parthishere/Insane-Keyboard/project_report/the_insane_keyboard.tex

\documentclass[a4paper,11pt]{article}%,twocolumn
\input{settings/packages}
\input{settings/page}
\input{settings/macros}
\usepackage[ framed, numbered]{matlab-prettifier}%framed,%
\usepackage{listings}
\usepackage{physics}
\usepackage{pdfpages}
\usepackage[toc,page]{appendix}
\usepackage{float}
% for code
\usepackage{listings}
\usepackage{color}
\usepackage{pifont}

\usepackage{scalerel,xparse}
\NewDocumentCommand\emojismile{}{
    \scalerel*{
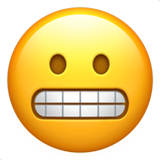
[picture p1: project_report/figures/emoji/u1F62C.png]
        
    }{X}
}

% Define colors
\definecolor{codegreen}{rgb}{0,0.6,0}
\definecolor{codegray}{rgb}{0.5,0.5,0.5}
\definecolor{codepurple}{rgb}{0.58,0,0.82}
\definecolor{backcolour}{rgb}{0.95,0.95,0.92}
% Setup the listings package
\lstset{
    backgroundcolor=\color{backcolour},   
    commentstyle=\color{codegreen},
    keywordstyle=\color{magenta},
    numberstyle=\tiny\color{codegray},
    stringstyle=\color{codepurple},
    basicstyle=\footnotesize,
    breakatwhitespace=false,         
    breaklines=true,                 
    captionpos=b,                    
    keepspaces=true,                 
    numbers=left,                    
    numbersep=5pt,                  
    showspaces=false,                
    showstringspaces=false,
    showtabs=false,                  
    tabsize=2
}

\begin{document}
\input{content/title_page}

\pagebreak

\tableofcontents
\listoffigures
\listoftables
\vfill
\begin{center}
    \textbf{\textit{*PDF is clickable}}
\end{center}

\pagebreak

% \section{}

\section{\color{red}Project Proposal}

\textbf{Team name:}\\
Low Self Esteem Team\\

\textbf{Student Name:}\\
Parth Rajeshkumar Thakkar\\
ParthRajeshkumar.Thakkar@colorado.edu\\

Anagha Aditya\\
Anagha.Aditya@colorado.edu\\

Akash Karoshi\\
Akash.Karoshi@colorado.edu\\

\subsection{Project Rationale and Goals}
For the ECEN 5833 Low Power Embedded System Design course, our team is developing an advanced mechanical keyboard called "The Insane Keyboard". This project aims to create a high-performance input device that combines ergonomic design, customization options, and some cool features.

\subsubsection{Project Rationale}
Our analysis of the mechanical keyboard market revealed several issues:
\begin{itemize}
    \item Ergonomic keyboards often lack additional features or are expensive
    \item Many feature-rich keyboards are wired, limiting mobility
    \item Affordable keyboards offer limited customization
    \item Few keyboards combine ergonomic design, wireless capability, programmable lighting, and smart functions
    \item Keyboards with displays or extra features often have poor power efficiency
\end{itemize}
\subsubsection{Project Goals}
We aim to create a mechanical keyboard with the following features:
\begin{itemize}
    \item Split ergonomic design to reduce physical strain
    \item Wireless connectivity using Bluetooth Low Energy.
    \item Programmable RGB lighting with addressable LEDs
    \item Hot-swappable key switches for easy customization
    \item Low-power E-ink display for additional information
    \item Multi-device compatibility
    \item Advanced power management techniques
    \item Environment temperature and pressure sensing.
    \item Real Time clock module for timer, stopwatch and time features.
    \item Potential energy harvesting from typing (Yet to be seen)
    \item Open-source firmware for extensive customization
    \item Cost-effective design for market accessibility
\end{itemize}

\subsubsection{Unique Features}
"The Insane Keyboard" has unique features like:
\begin{itemize}
    \item Integration of multiple desirable features in one device
    \item Optimized power management for extended use
    \item Potential energy harvesting from typing motions
    \item Open-source firmware for community-driven development
    \item Adaptable design for future upgrades
\end{itemize}

\subsubsection{Expected Outcomes}
Upon completion, this project could:
\begin{itemize}
    \item Improve ergonomics in daily computer use
    \item Advance keyboard power management and energy harvesting
    \item Foster a community of keyboard enthusiasts and developers
    \item Demonstrate practical applications of low-power embedded design
\end{itemize}

\subsection{Existing Products and Ideas from products}

% Placeholder for a diagram of the keyboard design
\begin{figure}[H]
    \centering
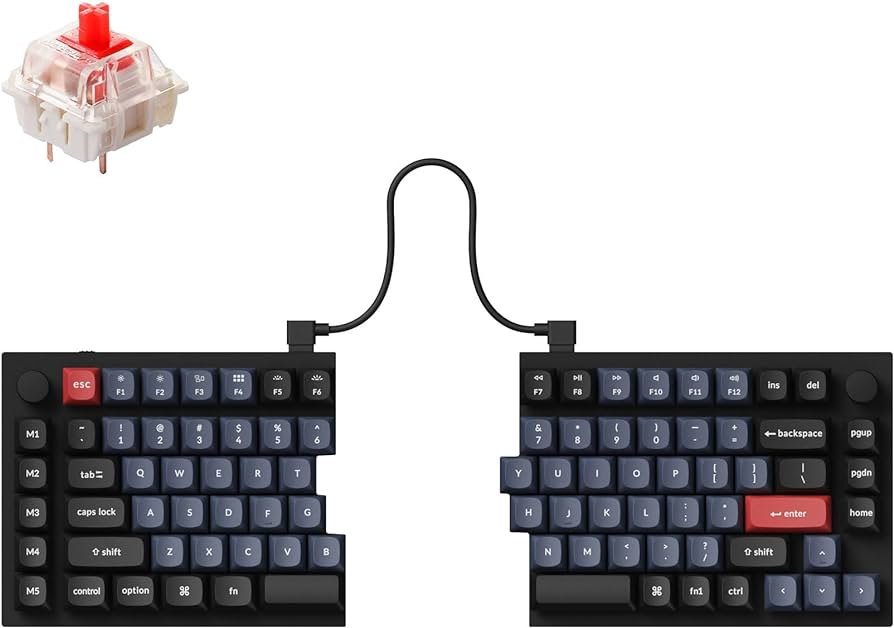
[picture p2: project_report/figures/split_keyboard.jpg]
    
    \caption{Split Keyboard without display(Wired)}
    % Figure content to be added
\end{figure}
\vspace{0.2cm}
\begin{figure}[H]
    \centering
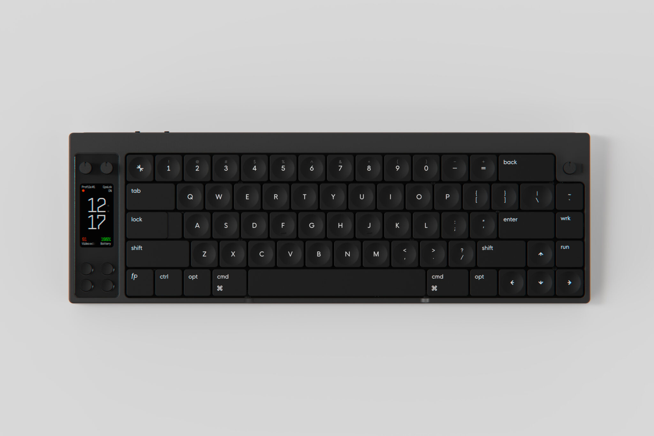
[picture p3: project_report/figures/nomad.jpg]
    
    \caption{Keyboard which is expensive and have a Display}
    % Figure content to be added
\end{figure}
\vspace{0.2cm}

\begin{figure}[H]
    \centering
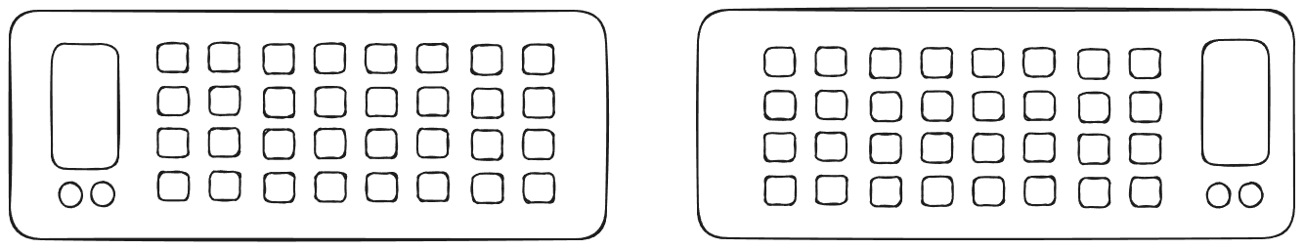
[picture p4: project_report/figures/concept.png]
    
    \caption{Conceptual Design of The Insane Keyboard}
    % Figure content to be added
\end{figure}
\vspace{0.2cm}

\subsection{High Level Requirements}

\subsubsection{General Requirements}
\begin{itemize}
\item Two EFR32BG13 boards (one per module)
\item Should be Ergonomic
\item 75\% keyboard layout (TKL layout)
\item IO expander for each MCU
\item Temperature sensor
\item Pressure sensor
\item Real-Time Clock (RTC)
\item Connectivity to three host devices
\item Computer software for LED customization
\item Individually customizable LEDs
\item E-ink display on each module
\item Energy harvesting on each module
\item Charging circuit with Type-C connector
\item Charging indicator
\item Battery indicator
\item Minimum 6-key rollover
\item HID protocol communication between modules
\item Smart power states (active, idle, deep sleep)
\item RTOS: FreeRTOS (Yet to be decide)
\item PWM-based RGB LED control
\item Hot-swappable key switches
\item Time, date, battery status, current profile, custom graphics
\item Spotify integration for music control and now-playing information(yet to be seen)
\end{itemize}

\subsection{Keyboard Layout and Design}

\subsubsection{Main Board Key Layout}
\begin{center}
\begin{tabular}{|c|c|c|c|c|c|c|}
\hline
\multicolumn{7}{|c|}{\textbf{Function Row}} \\ \hline
\begin{tabular}[c]{@{}c@{}}ESC\ $\sim$ `{}\end{tabular} &
\begin{tabular}[c]{@{}c@{}}F1\ 1 !\end{tabular} &
\begin{tabular}[c]{@{}c@{}}F2\ 2 @\end{tabular} &
\begin{tabular}[c]{@{}c@{}}F3\ 3 \#\end{tabular} &
\begin{tabular}[c]{@{}c@{}}F4\ 4 \$\end{tabular} &
\begin{tabular}[c]{@{}c@{}}F5\ 5 \%\end{tabular} &
\begin{tabular}[c]{@{}c@{}}F6\ 6 \^{}\end{tabular} \\
\hline
\multicolumn{7}{|c|}{\textbf{QWERTY Row}} \\
\hline
TAB & Q & W & E & R & T &\\
\hline
\multicolumn{7}{|c|}{\textbf{Home Row}} \\
\hline
CAPS & A & S & D & F & G & \\
\hline
\multicolumn{7}{|c|}{\textbf{Bottom Row}} \\
\hline
SHIFT & Z & X & C & V & B & \\
\hline
\multicolumn{7}{|c|}{\textbf{Modifier Row}} \\
\hline
CTRL & OPT & WIN/MAC & ALT & \multicolumn{3}{c|}{SPACE} \\
\hline
\end{tabular}
\end{center}
\textbf{Additional Inputs:}
\begin{itemize}
\item 2 × Rotary Encoders (Knobs)
\item 3 × Extra Buttons
\end{itemize}
\textbf{Additional Components}
\begin{itemize}
    \item E-Ink display
    \item Battery
    \item Battery Charging and Power Management Unit \textcolor{yellow}{(Not in Secondary module)}
    \item Tempurature Sensor \textcolor{yellow}{(Not in Secondary module)}
    \item Real time Clock \textcolor{yellow}{(Not in Secondary module)}
\end{itemize}

\subsection{Secondary Module Key Layout}
\begin{center}
\begin{tabular}{|c|c|c|c|c|c|c|c|}
\hline
\multicolumn{8}{|c|}{\textbf{Function Row}} \\
\hline
F7 & F8 & F9 & F10 & F11 & F12 & BKSP & HOME \\
\hline
\multicolumn{8}{|c|}{\textbf{QWERTY Row}} \\
\hline
Y & U & I & P & \{[ & \}] & |$\backslash$  & DEL \\
\hline
\multicolumn{8}{|c|}{\textbf{Home Row}} \\
\hline
H & J & K & L & \begin{tabular}[c]{@{}c@{}}; :\end{tabular} & \begin{tabular}[c]{@{}c@{}}" '\end{tabular} & ENTER & PGUP \\
\hline
\multicolumn{8}{|c|}{\textbf{Bottom Row}} \\
\hline
N & M & \begin{tabular}[c]{@{}c@{}}, <\end{tabular} & \begin{tabular}[c]{@{}c@{}}. >\end{tabular} & \begin{tabular}[c]{@{}c@{}}/ ?\end{tabular} & SHIFT & ↑ & PGDN \\
\hline
\multicolumn{8}{|c|}{\textbf{Modifier Row}} \\
\hline
& SPACE & ALT/MAC & FN & CTRL & ← & ↓ & → \\
\hline
\end{tabular}
\end{center}
\textbf{Additional Inputs:}
\begin{itemize}
\item 2 × Rotary Encoders (Knobs)
\item 3 × Extra Buttons
\end{itemize}
\textbf{Additional Components:}
\begin{itemize}
    \item E-Ink display
    \item Battery
    \item Power Management Unit
\end{itemize}

\subsection{Challenges and Considerations}
\begin{itemize}
\item Managing state machines with complex software like e-ink display drivers
\item Integrating drivers with BLE firmware
\item Implementing RTC driver and temperature control driver
\item Ensuring reliable wireless connectivity
\item Implementing multi-host communication and switching
\item Developing HID profile in BLE stack
\item Implementing anti-ghosting techniques
\item Optimizing keyboard scan rate for low latency
\item Achieving N-key rollover or 6-key rollover
\end{itemize}

\pagebreak
\section{\color{red}Project Update: Week 1}

\subsection{Technical Considerations}

\subsubsection{Functional hardware block diagram}

\begin{figure}[H]
    \centering
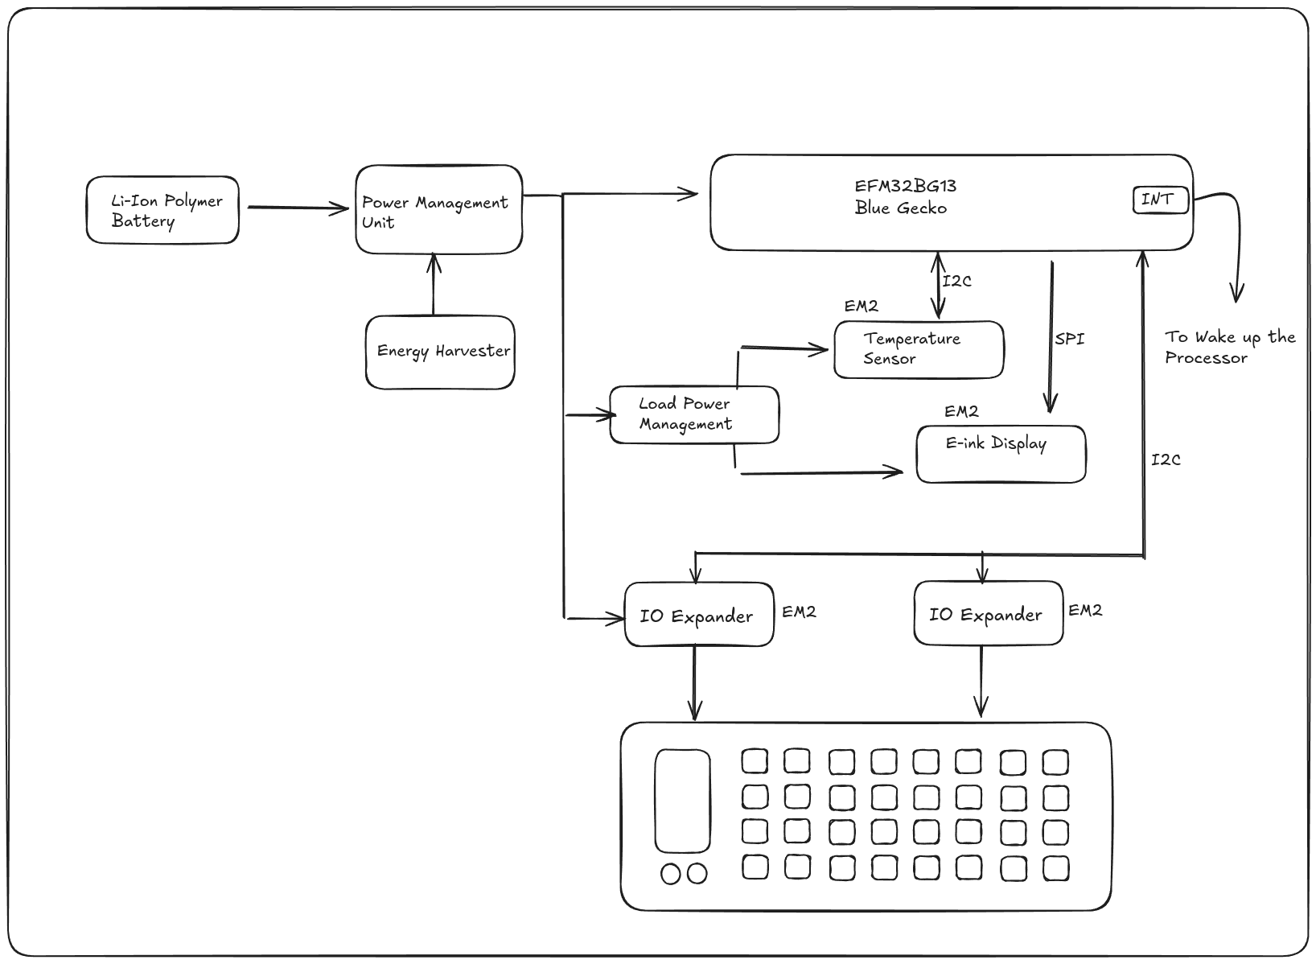
[picture p5: project_report/figures/blockdiagram.png]
    
    \caption{Hardware block diagram}
    % Figure content to be added
\end{figure}
\vspace{0.2cm}

\textbf{0-Key Rollover (Normal Matrix)}
\begin{figure}[H]
	\centering
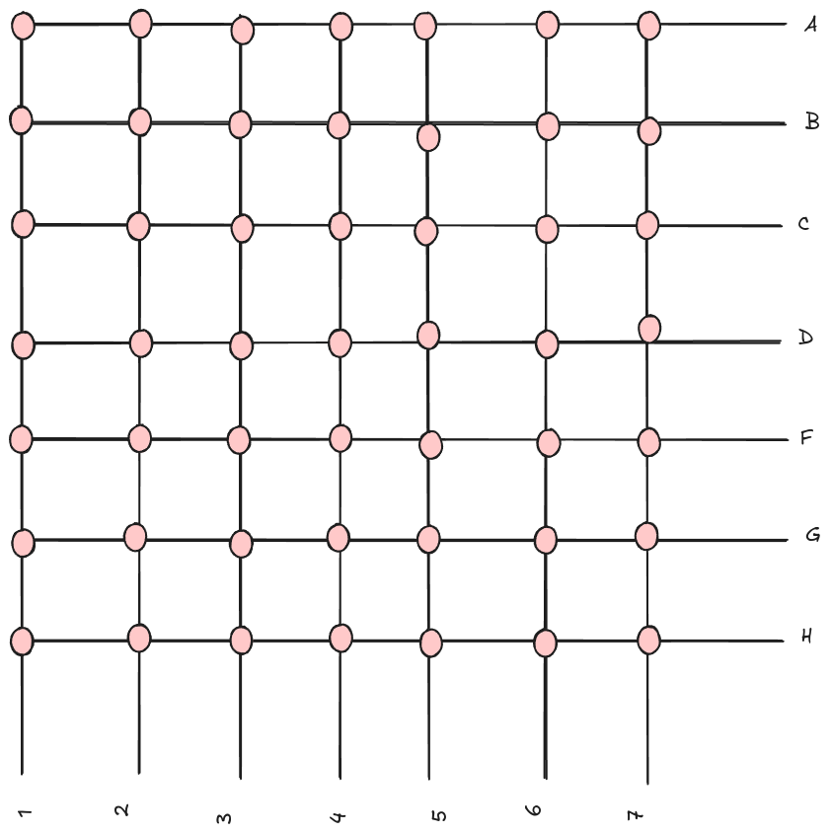
[picture p6: project_report/figures/NRO.png]
	
	\caption{Normal Matrix for no key roll over}
\end{figure}
\begin{figure}[H]
	\centering
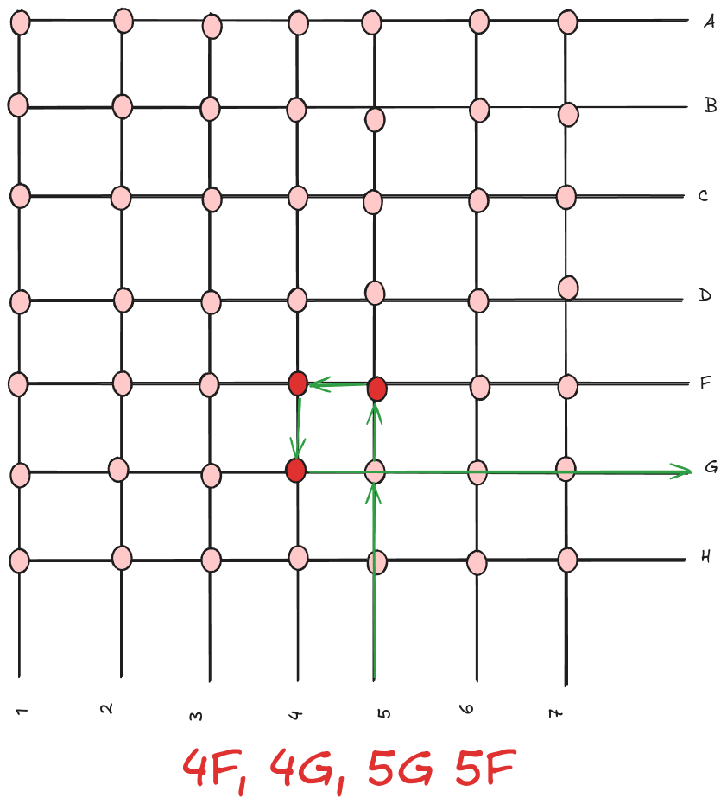
[picture p7: project_report/figures/nkr-EX.png]
	
	\caption{Decoding wrong button press}
\end{figure}

\textbf{N-Key Rollover feature with Diodes}
\begin{figure}[H]
    \centering
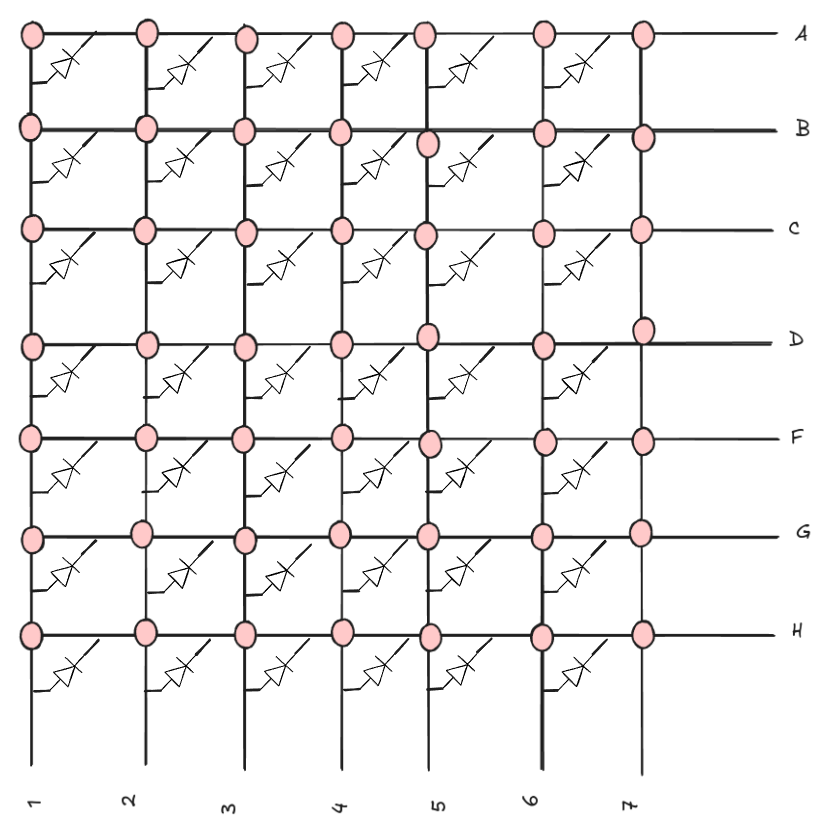
[picture p8: project_report/figures/NKRO.png]
    
    \caption{N-Key Rollover}
\end{figure}

\begin{figure}[H]
	\centering
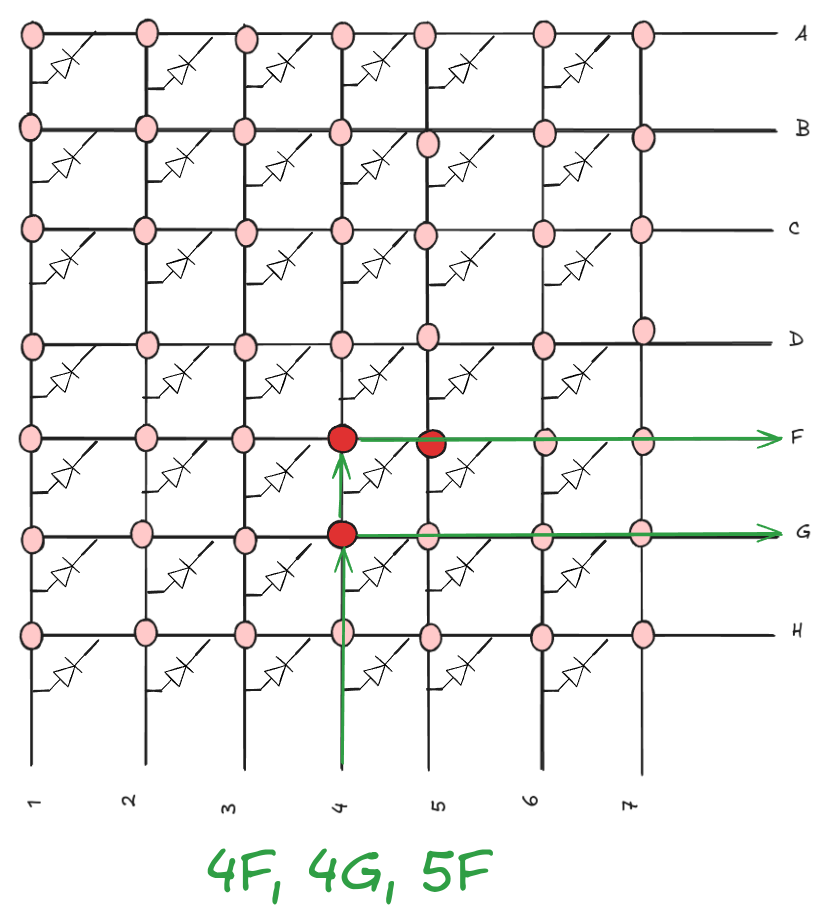
[picture p9: project_report/figures/NKRO-EX.png]
	
	\caption{Multiple keys pressed}
\end{figure}

The keyboard uses a matrix layout, which is an efficient way to manage multiple key inputs with fewer microcontroller pins. In the images, we see an 8x7 matrix (rows A-H, columns 1-7).\\
Scanning Process:\\

The microcontroller scans this matrix by activating one column at a time and reading the state of all rows.
When a key is pressed, it connects a row and column, which the microcontroller detects.\\

\textbf{Ghosting and Its Prevention:}

Ghosting is a problem in simple matrix designs where pressing multiple keys can lead to false key registrations.
Example (Image 1):\\

If keys at 4F, 4G, and 5F are pressed simultaneously, the matrix might also falsely register 5G.\\

\textbf{Solution (Images 2 and 3):}

Diodes are added to each key switch.
These diodes allow current to flow in only one direction, preventing the "phantom" current paths that cause ghosting.
With diodes, when 4F, 4G, and 5F are pressed, 5G is not falsely registered.\\

\textbf{N-Key Rollover (NKRO):}

NKRO allows the keyboard to correctly register any number of simultaneous key presses.\\
Implementation:\\

Each key gets its own diode, ensuring independent registration.
The microcontroller scans the entire matrix rapidly, detecting all pressed keys without conflicts.\\

\textbf{Hardware Components:}

\textbf{Central Microcontroller:}

EFM32BG13 Blue Gecko: This MCU manages all keyboard functions and interfaces with other components.\\

\textbf{Sensors:}

TMP117: Measures temperature, humidity, and pressure, potentially for environmental adaptation or user information.\\
DS3231 RTC Module: Provides accurate timekeeping, useful for time-based functions or logging.\\

\textbf{Display}:

E-Ink Display (800x600, 4.3inch): Offers a low-power way to show keyboard status, settings, or other information.\\

\textbf{Expansion:}

MCP23017 IO Expander: Increases the number of available pins for the key matrix, allowing for more keys or other inputs.\\

\textbf{Power Management:}

Power Management Unit: Manages power distribution and consumption.\\
Li-Ion Polymer Battery: Provides portable power.\\
Energy Harvester: Potentially extends battery life by capturing ambient energy.\\

\textbf{Key Switches and Caps:}

Gateron G Black Pro 2.0 switches: Known for smooth linear action.
Cherry MX key caps: Industry-standard keycaps for customization.\\

\textbf{Additional Inputs:}

Rotary encoders: Provide alternative input methods, possibly for volume control or menu navigation.\\

\textbf{PCB Design:}

4-layer PCB: Allows for more complex routing and better signal integrity.\\
Two versions:\\

Main Module with  all sensors and charging capabilities.\\
Simplified Secondary Module without temperature, humidity, RTC, and LiPo charger.\\

\subsection{Wireless Communication and Software Architecture}

We have made significant progress in defining our wireless communication protocol and software architecture:

\subsubsection{HID Profile Characteristics}
We've detailed the HID (Human Interface Device) profile for our keyboard, including:
\begin{itemize}
    \item Keyboard Input Report: 8-byte structure for key presses
    \item Keyboard Output Report: 1-byte for LED status
    \item Protocol Mode: Supports both Boot and Report protocols
    \item HID Information and Control Point: For device management
    \item Report Map: Defines input/output report formats
\end{itemize}

\subsubsection{Software Architecture}
We've developed a functional software block diagram that outlines the interaction between various software components, including the BLE stack, keyboard matrix scanning, and power management modules.

\begin{figure}[H]
    \centering
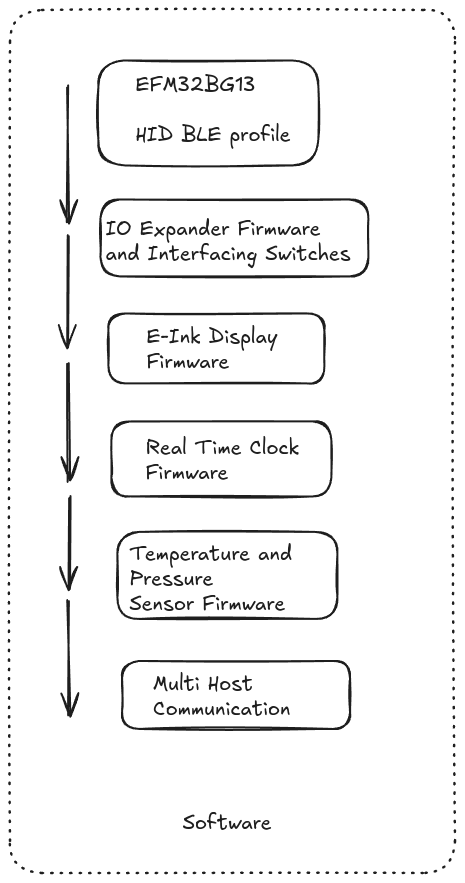
[picture p10: project_report/figures/software_diagram.png]
    
    \caption{Software Block Diagram}
\end{figure}

\subsection{Project Management}

We've set up a robust project management system:

\begin{enumerate}
    \item Timeline: We've created a detailed project timeline (Figure \ref{fig:timeline}) to track our progress and milestones.
    
    \item Version Control: Our project is now on GitHub, allowing for better collaboration and code management.
    \begin{itemize}
        \item Project Board: \href{https://github.com/users/parthishere/projects/2}{GitHub Project}
        \item Code Repository: \href{https://github.com/parthishere/Insane-Keyboard}{GitHub Code Repository}
    \end{itemize}
    
    \item Task Tracking: We're using a Kanban board (Figure \ref{fig:kanban}) to manage our tasks and workflow efficiently.
\end{enumerate}

\begin{figure}[H]
    \centering
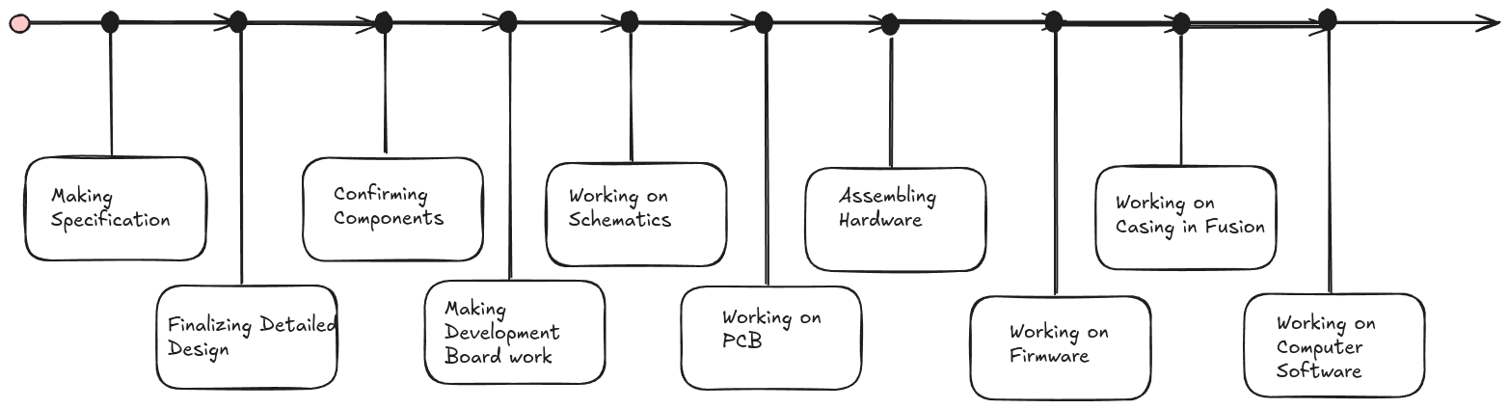
[picture p11: project_report/figures/Timeline.png]
    
    \caption{Project Timeline}
    \label{fig:timeline}
\end{figure}

\begin{figure}[H]
    \centering
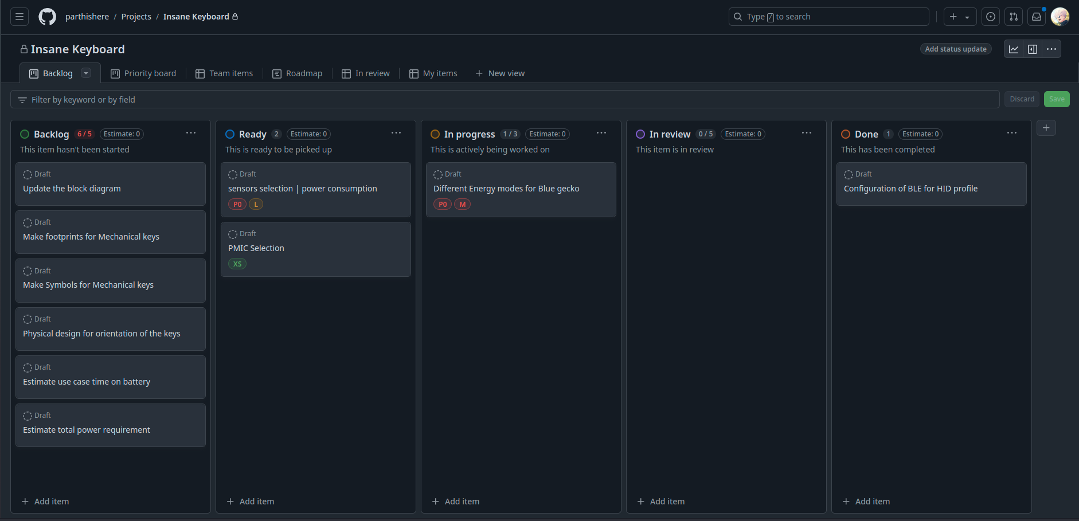
[picture p12: project_report/figures/kanban.png]
    
    \caption{Kanban Board for Task Management}
    \label{fig:kanban}
\end{figure}

\subsection{Energy Analysis and Power Management}

We've conducted initial energy mode analysis and made decisions on power management:

\begin{enumerate}
    \item Energy Calculations: We've performed preliminary calculations (Figure \ref{fig:energy_calc}) to estimate power consumption in various modes.

    \item Energy Harvesting: We've chosen to incorporate a solar panel for energy harvesting, enhancing the keyboard's power autonomy.

    \item Interface Selections:
    \begin{itemize}
        \item Display: SPI interface chosen for faster data transfer
        \item Temperature Sensor and IO Expander: I2C interface for power efficiency
    \end{itemize}

    \item Load Power Management: Implemented a load switch to disable the temperature sensor and display when not in use, reducing standby power consumption.

    \item Multiple Energy Modes: Our design now supports various energy modes to optimize power usage based on the keyboard's current state.
\end{enumerate}

\begin{figure}[H]
    \centering
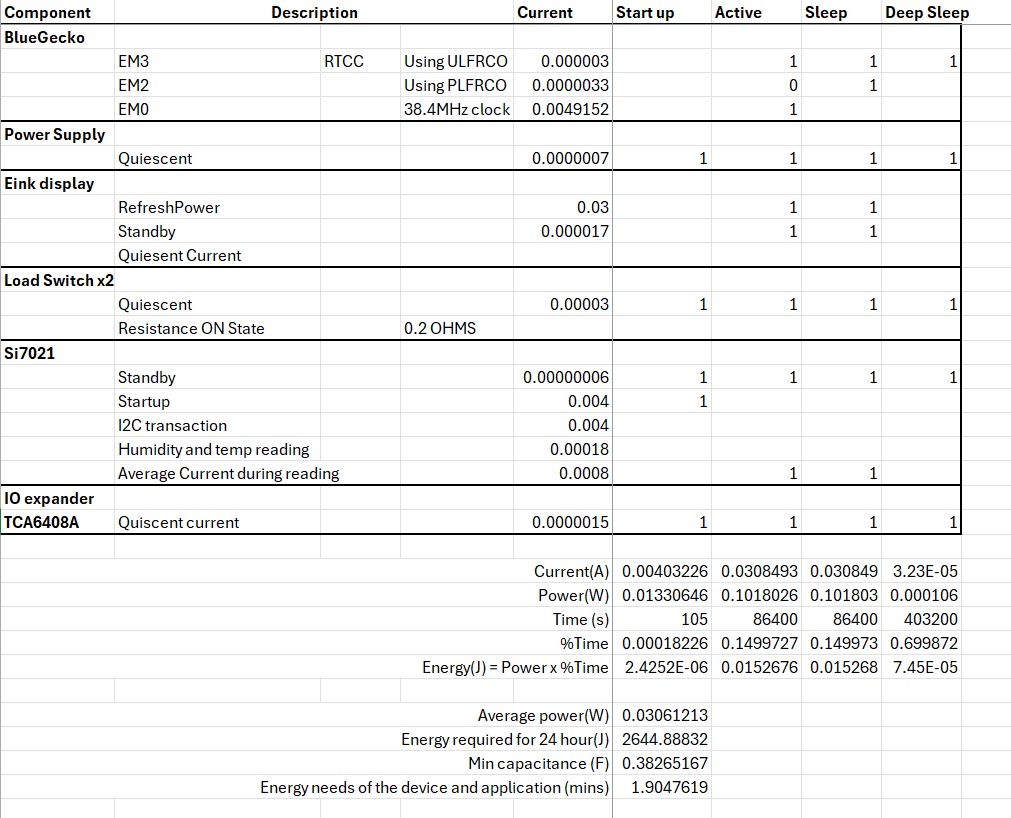
[picture p13: project_report/figures/calc.jpeg]
    
    \caption{Energy Calculations}
    \label{fig:energy_calc}
\end{figure}

\pagebreak

\section{\color{red}Project Update: Week 2}

\subsection{Selection Criteria}
We chose components based on:

\begin{enumerate}
    \item Availability: Multiple suppliers to ensure steady supply.
    \item Power efficiency: Low standby and active currents, multiple power-saving modes.
    \item Documentation: Comprehensive datasheets, application notes, and support.
    \item Sleep modes: Various low-power states with quick wake-up capabilities.
    \item Temperature range: Suitable for varied environments.
    \item EMC/EMI: Built-in interference mitigation.
    \item ongevity: Components not near end-of-life.
    \item Cost: Balanced features and performance with price.
\end{enumerate}

\subsubsection{Chosen Components}

\begin{longtable}{|p{2cm}|p{1.5cm}|p{3cm}|p{1.5cm}|p{6cm}|}
    \hline
    \textbf{Component} & \textbf{Quantity} & \textbf{Function} & \textbf{Interface} & \textbf{DigiKey Part Number} \\
    \hline
    EFR32BG13 & 2 & Microcontroller & - & 
    \href{https://www.digikey.com/en/products/detail/silicon-labs/EFR32BG13P632F512GM32-D/10135852}{EFR32BG13P632F512GM32-D-ND} \\
    \hline
    TCA6408A & 2 & IO Expander & I2C  & 
    \href{https://www.digikey.com/en/products/detail/texas-instruments/TCA6408ARSVR/2044045}{296-24328-1-ND} \\
    \hline
    Waveshare E-ink Display & 1 & Display & SPI  & 
    \href{https://www.waveshare.com/1.54inch-e-paper-module.htm}{External Link} \\
    \hline
    TPS22919 & 1 & Load Switch & -  & 
    \href{https://www.digikey.com/en/products/detail/texas-instruments/TPS22919DCKT/9953066}{296-53421-1-ND} \\
    \hline
    BQ25570 & 2 & PMIC & - & 
    \href{https://www.digikey.com/en/products/detail/texas-instruments/BQ25570RGRT/4430487}{296-37014-1-ND} \\
    \hline
    Battery 1000mAh & 2 & Energy Storage & -  & 
    \href{https://www.digikey.com/en/products/detail/globtek-inc/BL1200P4054481S1PCAC/11201333}{1939-BL1200P4054481S1PCAC-ND} \\
    \hline
    SI7021 & 1 & Temperature and Humidity Sensor & I2C  & 
    \href{https://www.digikey.com/en/products/detail/silicon-labs/SI7021-A20-GMR/5048936}{336-4379-1-ND} \\
    \hline
    Schottky Diodes & 1 & Power Management & -  & 
    \href{-}{Have not decided yet} \\
    \hline
    Gateron G Black Pro 2.0 & 68 & Key Switches & - & 
    \href{https://www.gateron.co/products/gateron-g-pro-2-0-switch-set}{External link} \\
    \hline
    Mechanical Key Hotswap & 68 & Hotswap Sockets & - & 
    \href{https://www.gateron.co/products/gateron-hot-swap-pcb-socket}{External Link} \\
    \hline
    Cherry MX Key Caps & 68 & Key Caps & - & 
    \href{https://www.aliexpress.com/i/3256802573932641.html?gatewayAdapt=4itemAdapt}{External link} \\
    \hline
    Rotary Encoders & 2 & Input Device & - & 
    \href{https://www.digikey.com/en/products/detail/bourns-inc/PEC12R-4222F-S0024/4699283}{PEC12R-4222F-S0024-ND} \\
    \hline
    Solar Panel SM141K06L & 1 & Energy Harvesting & - & 
    \href{https://www.digikey.com/en/products/detail/anysolar-ltd/SM141K06L/9990462}{SM141K06L-ND} \\
    \hline
    \caption{Component List for The Insane Keyboard with DigiKey Part Numbers}
    \label{tab:components}
\end{longtable}

\subsection{Justification for Each Component}

\subsubsection{EFR32BG13 Microcontroller}
\begin{itemize}
    \item Bluetooth 5.0 capable
    \item Energy-efficient: 60 uA/MHz at 40 MHz
    \item Five power modes: 1.4 uA in deep sleep, 20 nA in shutoff
    \item Low-energy peripherals for efficient keyboard scanning
    \item Comprehensive development tools
\end{itemize}

\subsubsection{TCA6408A I/O Expander}
\begin{itemize}
    \item 0.1 uA standby current
    \item 400 kHz I2C interface for quick I/O updates
    \item 8 programmable I/O pins, each sinking 25 mA
    \item Interrupt output for event-driven operation
    \item Chosen over PCA9538 and SX1509 for lower power and simpler programming
\end{itemize}

\subsubsection{Waveshare E-ink Display}
\begin{itemize}
    \item Power used only during updates
    \item Enables dynamic key labeling
    \item SPI interface for fast updates
    \item 200x200 pixel resolution
    \item Preferred over OLED for lower power consumption
\end{itemize}

\subsubsection{TPS22919 Load Switch}
\begin{itemize}
    \item 12 nA quiescent current
    \item 15 us response time
    \item 2A current capacity
    \item 1.5V to 5.5V input range
    \item Built-in protection features
    \item Chosen over TPS22860 and SiP32431 for balanced performance
\end{itemize}

\subsubsection{BQ25570 Power Management IC}
\begin{itemize}
    \item 100 mV to 5.1 V input range
    \item Integrated Maximum Power Point Tracking
    \item 488 nA quiescent current
    \item Built-in boost charger and buck converter
    \item Programmable voltage thresholds
    \item Selected over SPV1050 and ADP5090 for solar power optimization
\end{itemize}

\subsubsection{SI7021 Temperature and Humidity Sensor}
\begin{itemize}
    \item ±0.4°C and ±3\%RH accuracy
    \item 150 nA standby current
    \item I2C interface
    \item 3x3 mm package
    \item 1.9V to 3.6V supply range
    \item Chosen over HDC1080 and BME280 for accuracy and power efficiency
\end{itemize}

\subsubsection{Solar Panel (SM141K06L)}
\begin{itemize}
    \item 42mm x 23mm size
    \item 184 mW maximum output
    \item 3.35V at maximum power point
\end{itemize}

\subsubsection{Battery (1000mAh)}
\begin{itemize}
    \item Size: 2.09" x 1.89" x 0.16"
    \item 525mA charge current, 1.05A discharge current
    \item 3.7V nominal voltage
\end{itemize}

\subsection{Energy Analysis}
\subsubsection{Overall Energy Efficiency}
We have made the following assumption for our energy calculations:
The keyboard will be operational 24/7, with the following daily usage pattern:\
8 hours of active use per day
\begin{itemize}
\item 4 hours in active mode
\item 4 hours in sleep mode
\end{itemize}
16 hours in deep sleep mode
\paragraph{Energy Consumption Breakdown}
Based on our calculations, the energy consumption for different operational states is as follows:
\begin{itemize}
\item Start-up: 0.000101970 W
\item Active: 0.0166035556 W
\item Transmit: 0.129140610 W
\item Sleep: 0.000122760 W
\item Deep Sleep: 0.00011187 W
\end{itemize}
\paragraph{Average Power Consumption}
The weighted average power consumption, considering the time spent in each mode, is calculated to be:
\begin{equation}
P_{avg} = 0.003976168 \text{ W}
\end{equation}
This remarkably low average power consumption is achieved through intelligent power management and efficient component selection.
\paragraph{Daily Energy Requirement}
Based on our average power consumption, the total energy required for 24 hours of operation is:
\begin{equation}
E_{daily} = 343.5409345 \text{ J} = 0.095428 \text{ Wh}
\end{equation}
\paragraph{Battery Capacity Calculation}
For sustained operation over a week, we calculated the required battery capacity:
\begin{align*}
E_{weekly} &= 2404.786542 \text{ J} = 0.667996262 \text{ Wh} \
\text{Adjusted Energy} &= \frac{0.667996262}{0.85 \times 0.8} = 0.982347443 \text{ Wh} \
\text{Battery Capacity} &= \frac{0.982347443 \text{ Wh}}{3.7 \text{ V}} \times 1000 = 265.499309 \text{ mAh}
\end{align*}
This calculation takes into account a battery efficiency of 85\% and a maximum depth of discharge of 80\% to ensure long-term battery health.
\paragraph{Energy Harvesting Efficiency}
Our solar panel and power management system are designed to harvest energy efficiently even in low-light indoor conditions. The BQ25570 PMIC, with its Maximum Power Point Tracking (MPPT) capability, ensures optimal energy extraction from the solar panel.
\paragraph{Power Budget Analysis}
\begin{itemize}
\item Average current draw: 1.07464 mA
\item Peak current (during transmission): 39.0296560 mA
\item Quiescent current (deep sleep): 33.9 uA
\end{itemize}
The significant difference between peak and quiescent current underscores the effectiveness of our power-saving modes.
\paragraph{Capacitor Sizing}
To support peak current demands, we calculated a minimum capacitance of:
\begin{equation}
C_{min} = 0.049702103 \text{ F}
\end{equation}
This capacitance ensures stable operation during high-current events while allowing the solar harvesting system to replenish energy during low-power periods.
With an average power consumption of just 3.976 mW and a weekly energy requirement of less than 1 Wh, our keyboard is well-positioned for long-term, self-sustained operation using solar energy harvesting, even in typical indoor environments.
\subsection{Battery and Power Management}
\subsubsection{Power Management IC (PMIC) Selection}
We have selected the BQ25570 PMIC as it provides the necessary features for efficient solar harvesting and battery management. Key features include:
\begin{itemize}
\item Wide input range: 100 mV to 5.1 V, ideal for solar harvesting
\item Integrated Maximum Power Point Tracking (MPPT)
\item Ultra-low quiescent current: 488 nA typical
\item Integrated boost charger and buck converter
\item Programmable voltage thresholds for optimal battery management
\end{itemize}
\subsubsection{Energy Storage Element Selection}
\textbf{Choice: SM141K06L Solar panel}
\begin{itemize}
\item Power Output: 184 mW
\item Voltage at Maximum Power Point (Vmpp): 3.35 V
\item Current at Maximum Power Point (Impp): 55.1 mA
\item Open Circuit Voltage (Voc): 4.15 V
\item Short Circuit Current (Isc): 58.6 mA
\item Size: 42.00mm x 23.00mm x 2.10mm (1.654" x 0.906" x 0.083")
\end{itemize}
Reasons for selection:
\begin{itemize}
\item Significantly higher power output compared to previous options
\item Larger but still manageable size for a keyboard design
\item Higher voltage output, beneficial for power management
\item Good power-to-size ratio
\end{itemize}
Energy Calculations (assuming 8 hours of typical indoor lighting per day):
\begin{flalign*}
&\text{Energy per day} = Power * Time &&\
&\text{Energy per day} = 184 mW * 8 hours  &&\
&\boxed{\text{Energy per day} = 1,472 mWh }&&
\end{flalign*}
Power Density:
\begin{equation*}
\text{Power Density} = \frac{\text{Power Output}}{\text{Area}} = \frac{184 \text{ mW}}{42\text{ mm} \times 23\text{ mm}} = \boxed{0.191 \text{ mW/mm²}}
\end{equation*}
\subsection{Energy Requirements Analysis}
\subsubsection{Unregulated Supply Performance}
Constant Power Case:
\begin{itemize}
\item Regulated power supply providing power for microcontroller and sensors which require input voltage kept in limited range.
\item As voltage out of energy source drops from Vworking to Vmin, current increases to keep power through supply constant.
\end{itemize}
\subsubsection{Peak and Average Current Use Cases}
We have analyzed the current requirements for each component in our system under both peak and average use conditions. Table \ref{tab:current_requirements} summarizes these findings:
\begin{table}[H]
\centering
\begin{tabular}{|l|c|c|}
\hline
\textbf{Component} & \textbf{Peak Current (A)} & \textbf{Average Current (A)} \\
\hline
Temperature Sensor & 0.004 & 0.00071424 \\
\hline
E-ink Display & 0.008 & 8.05558E-05 \\
\hline
MCU & 0.0393152 & 0.000115536 \\
\hline
PMIC & 0.0000009 & 0.0000009 \\
\hline
Load Switch & 0.0000201 & 0.0000201 \\
\hline
IO Expander & 0.0000015 & 0.0000015 \\
\hline
\textbf{Total} & 0.0513377 & 0.000932832 \\
\hline
\end{tabular}
\caption{Component Current Requirements}
\label{tab:current_requirements}
\end{table}
\subsubsection{Total Energy Required Between Charging}
Given:
\begin{itemize}
\item Battery Capacity: 1000 mAh
\item Assumed Battery Voltage: 3.7 V (typical for Li-ion)
\item Daily Energy Consumption: 343.5409345 J
\end{itemize}
Calculations:
\begin{enumerate}
\item \textbf{Convert Battery Capacity to Joules:}
\begin{equation}
\text{Energy (J)} = \text{Capacity (mAh)} \times \text{Voltage (V)} \times 3.6
= 1000 \times 3.7 \times 3.6 = 13,320 \text{ J}
\end{equation}
\item \textbf{Calculate Number of Days:}
\begin{equation}
\text{Days} = \frac{\text{Total battery energy}}{\text{Daily energy consumption}}
= \frac{13,320 \text{ J}}{343 \text{ J/day}} \approx 38.83 \text{ days}
\end{equation}
\item \textbf{Convert to Weeks:}
\begin{equation}
38.83 \text{ days} \approx 5.55 \text{ weeks}
\end{equation}
\end{enumerate}
\subsubsection{Recharge Time Calculation}
We are using a 1000mAh battery with a 0.5C charging rate:
\begin{itemize}
\item Theoretical charging current: 0.5C = 500mA
\item BQ25570 PMIC maximum charging current: 230mA (typical)
\end{itemize}
Since the PMIC can't provide 500mA, it will charge at its maximum rate of 230mA.
\begin{equation}
\text{Estimated charging time} = \frac{\text{Battery Capacity}}{\text{Charging Current}}
= \frac{1000\text{mAh}}{230\text{mA}} \approx 4.35 \text{ hours}
\end{equation}

\subsection{Supercapacitor vs Battery Comparison: Mathematical Analysis}

We'll compare a 4F Vishay supercapacitor with our 1000mAh Li-ion battery, focusing on quantitative aspects.

\subsubsection{Energy Storage}

\paragraph{Battery:}
Energy stored in the battery:
\begin{equation}
    E_{\text{battery}} = \text{Capacity} \times \text{Voltage} = 1000 \text{ mAh} \times 3.7 \text{ V} = 3700 \text{ mWh} = 13320 \text{ J}
\end{equation}

\paragraph{Supercapacitor:}
Energy stored in the supercapacitor (assuming 2.7V max voltage):
\begin{equation}
    E_{\text{supercap}} = \frac{1}{2} C V^2 = \frac{1}{2} \times 4 \text{ F} \times (2.7 \text{ V})^2 = 14.58 \text{ J} = 0.00405 \text{ Wh}
\end{equation}

\subsubsection{Power Density}

\paragraph{Battery:}
Assuming a discharge time of 1 hour at maximum current (1.05A):
\begin{equation}
    P_{\text{battery}} = 3.7 \text{ V} \times 1.05 \text{ A} = 3.885 \text{ W}
\end{equation}

\paragraph{Supercapacitor:}
Assuming a discharge time of 1 second (typical for supercapacitors):
\begin{equation}
    P_{\text{supercap}} = \frac{E_{\text{supercap}}}{\text{time}} = \frac{14.58 \text{ J}}{1 \text{ s}} = 14.58 \text{ W}
\end{equation}

\subsubsection{Current Handling}

\paragraph{Battery:}
Maximum discharge current: 1.05A

\paragraph{Supercapacitor:}
Maximum current can be calculated using the ESR (Equivalent Series Resistance). Assuming an ESR of 0.1 Ohm:
\begin{equation}
    I_{\text{max,supercap}} = \frac{V_{\text{max}}}{ESR} = \frac{2.7 \text{ V}}{0.1 \text{ \ohm}} = 27 \text{ A}
\end{equation}

\subsubsection{Self-Discharge}

\paragraph{Battery:}
Assuming 5\% self-discharge per month:
\begin{equation}
    E_{\text{loss,battery}} = 0.05 \times 3700 \text{ mWh} = 185 \text{ mWh/month}
\end{equation}

\paragraph{Supercapacitor:}
Self-discharge in supercapacitors can be modeled as:
\begin{equation}
    V(t) = V_0 e^{-t/\tau}
\end{equation}
Where $\tau = RC$, R is the leakage resistance (assume 100 kOhm), and C is 4F:
\begin{equation}
    \tau = 100 \text{ k\ohm} \times 4 \text{ F} = 400000 \text{ s} \approx 4.63 \text{ days}
\end{equation}

After one month (2,592,000 seconds):
\begin{equation}
    V(1 \text{ month}) = 2.7 \text{ V} \times e^{-2592000/400000} \approx 0.48 \text{ V}
\end{equation}

Energy remaining:
\begin{equation}
    E_{\text{remaining}} = \frac{1}{2} \times 4 \text{ F} \times (0.48 \text{ V})^2 = 0.4608 \text{ J}
\end{equation}

Energy lost:
\begin{equation}
    E_{\text{loss,supercap}} = 14.58 \text{ J} - 0.4608 \text{ J} = 14.1192 \text{ J} = 0.003922 \text{ Wh/month}
\end{equation}

\subsubsection{Charging Time}

\paragraph{Battery:}
With a charging current of 525mA:
\begin{equation}
    t_{\text{charge,battery}} = \frac{1000 \text{ mAh}}{525 \text{ mA}} = 1.90 \text{ hours}
\end{equation}

\paragraph{Supercapacitor:}
Assuming a charging current of 1A:
\begin{equation}
    t_{\text{charge,supercap}} = \frac{C \times V}{I} = \frac{4 \text{ F} \times 2.7 \text{ V}}{1 \text{ A}} = 10.8 \text{ seconds}
\end{equation}

\subsubsection{Conclusion}

This mathematical analysis confirms our previous conclusions:

\begin{itemize}
    \item The battery stores $\frac{3700}{0.00405} \approx 914$ times more energy than the supercapacitor.
    \item The supercapacitor can deliver $\frac{14.58}{3.885} \approx 3.75$ times more power in short bursts.
    \item The supercapacitor can handle much higher peak currents (27A vs 1.05A).
    \item The battery retains charge much better, losing only 5\% per month compared to the supercapacitor's 96.8% loss.
    \item The supercapacitor charges $\frac{1.90 \times 3600}{10.8} \approx 633$ times faster than the battery.
\end{itemize}

These calculations support using the battery as the main power source,

\subsection{PCB Design Progress}
We've completed footprint creation for most components, with the following exceptions:

Solar Panel: Recently added, footprint pending
0603 components: Footprints for resistors and MLCC capacitors still needed

\subsubsection{Footprint Generation}
Footprints:

\begin{figure}[H]
    \centering
    \begin{tabular}{cc}
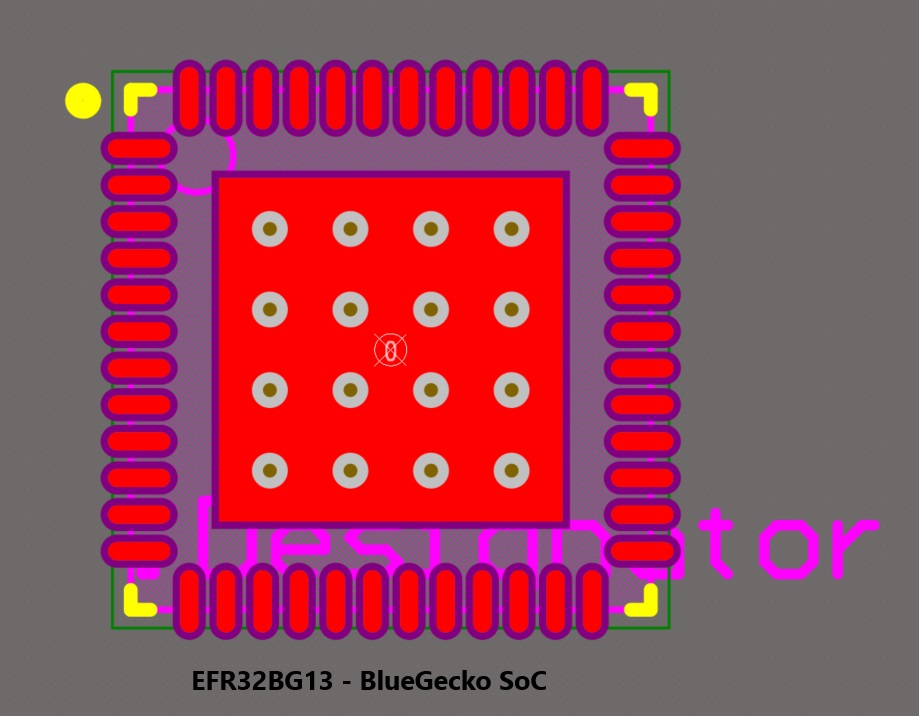
[picture p14: project_report/figures/BlueGecko.jpg]
         &
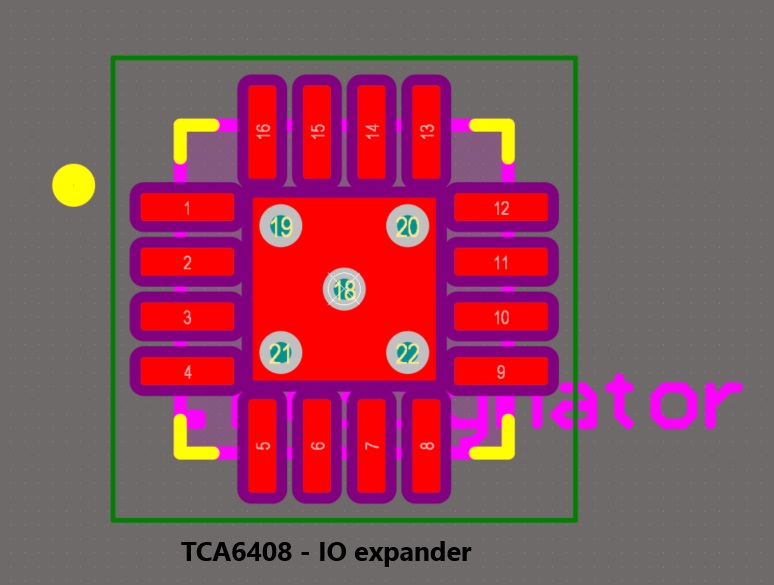
[picture p15: project_report/figures/IO expander.jpg]
         \\
        BlueGecko EFR32BG13 QFN48 package & IO expander \\
        
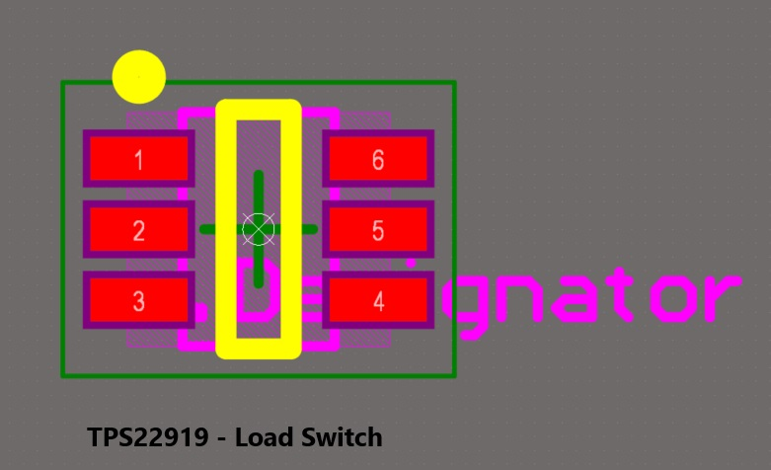
[picture p16: project_report/figures/Loadswitch.jpg]
         &
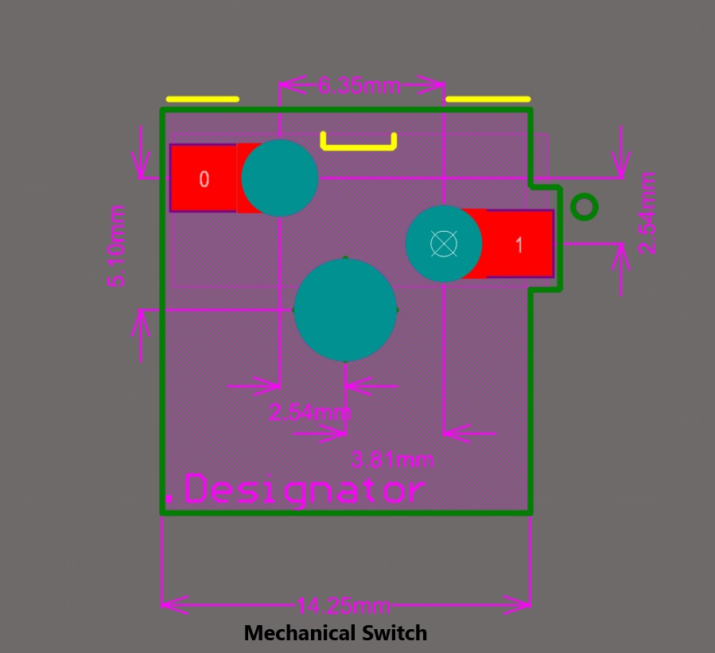
[picture p17: project_report/figures/Mechanical Switch.jpg]
         \\
        Loadswitch & Mechanical switch \\
        
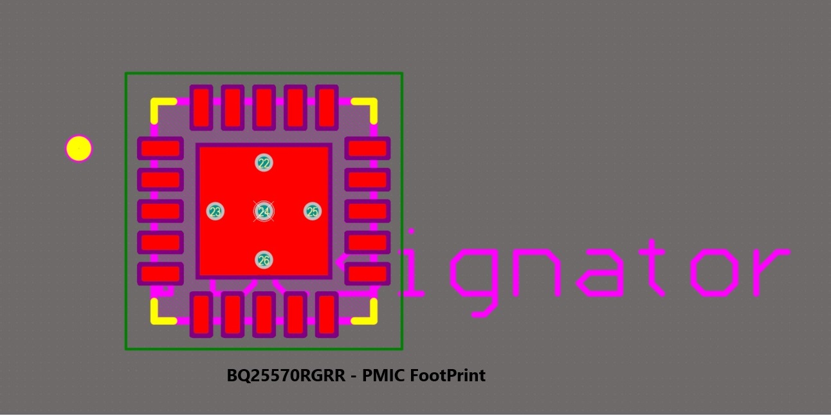
[picture p18: project_report/figures/PMIC.jpg]
         &
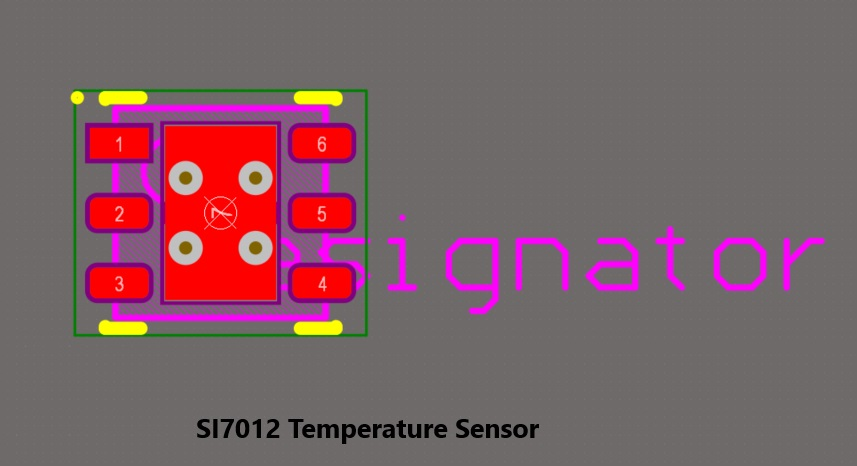
[picture p19: project_report/figures/Temperature sensor.jpg]
         \\
        PMIC & Temperature Sensor
    \end{tabular}
    \caption{Component Footprints}
    \label{fig:component_footprints}
\end{figure}

\subsubsection{Power Supply Considerations}
For components requiring a stable input voltage:

A regulated power supply will be used
As the energy source voltage decreases, current will increase to maintain constant power

\subsection{Mechanical Design}
\subsubsection{Dimensions}

Left unit: 165mm x 120mm x 35mm\\
Right unit: 175mm x 120mm x 35mm

\subsubsection{Material}
Carbon fiber-filled Nylon selected for construction
\subsubsection{Operating Conditions}

Temperature range: 0°C to 50°C\\
Voltage range: 
\begin{figure}[H]
	\centering
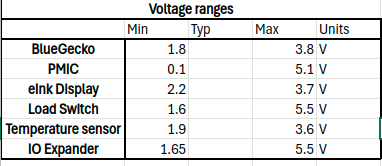
[picture p20: project_report/figures/vr.png]
	
	\caption{Voltage Range}
\end{figure}

\subsection{Project Progress and Future Plans}
\subsubsection{Recent Updates}
\begin{itemize}
    \item Added solar panel for energy harvesting
    \item removed Supercapacitor
    \item Added links to components
    \item created Libraries
\end{itemize}
\begin{figure}[H]
	\centering
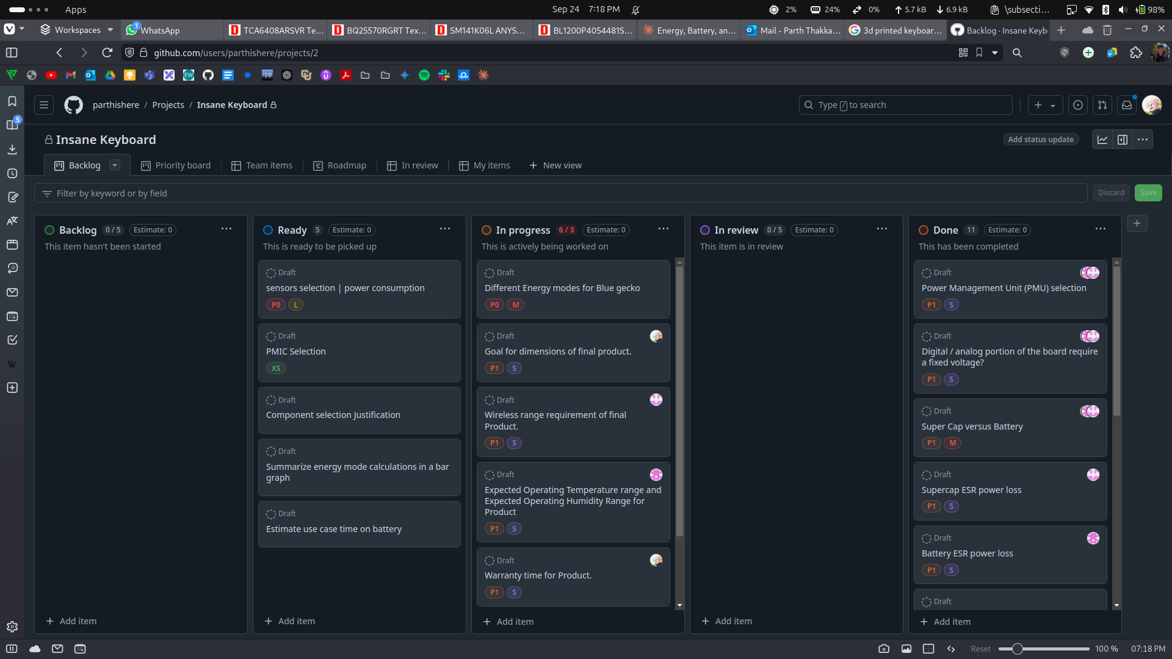
[picture p21: project_report/figures/kanban_2.png]
	
	\caption{Kanban for update 2}
\end{figure}

\subsubsection{Upcoming Tasks}
\begin{enumerate}
    \item Component Selection:
    \begin{itemize}
        \item Choose appropriate decoupling capacitors
    \end{itemize}
    \item Design Refinement:
    \begin{itemize}
        \item Optimize key size and spacing for ergonomics
        \item Finalize keyboard layout
    \end{itemize}
    \item Prototyping Preparation:
    \begin{itemize}
        \item Design 3D case model using Fusion 360
        \item 3D print prototype case
    \end{itemize}
\end{enumerate}

\begin{figure}[H]
	\centering
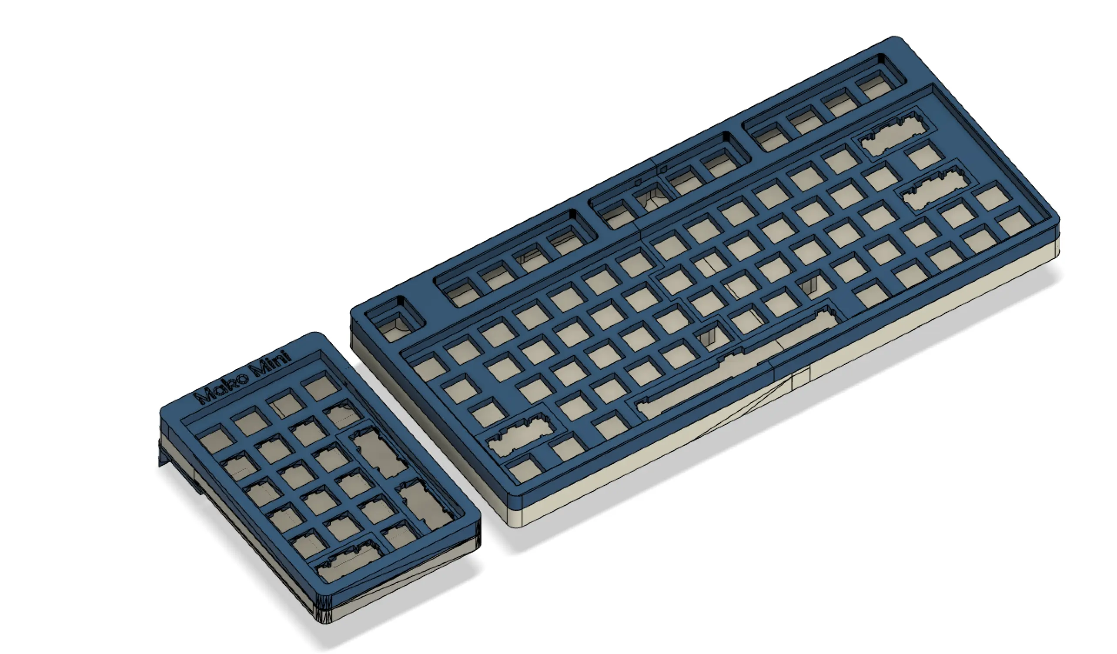
[picture p22: project_report/figures/3d_print_fusion.png]
	
	\caption{Design a Case and PCB}
\end{figure}

\pagebreak

\section{\color{red}{Update 3}}

\subsection{Battery Specifications and Usage Profile}

\begin{table}[h]
\centering
\begin{tabular}{|l|c|}
\hline
\textbf{Parameter} & \textbf{Value} \\
\hline
Internal Resistance (RDS) & 0.18 $\Omega$ \\
Capacity & 1.2 Ah \\
C-rate & 0.2 \\
Discharge Current at 0.2C & 0.24 A \\
Discharge Time at 0.2C & 5 hours \\
Charge Cycles & 300 \\
\hline
\end{tabular}
\caption{Battery Specifications}
\label{tab:battery_specs}
\end{table}

\begin{table}[h]
\centering
\begin{tabular}{|l|c|c|}
\hline
\textbf{Mode} & \textbf{Current (A)} & \textbf{Time Fraction} \\
\hline
Start-up & 0.00003240 & 0.0001808911 \\
Active & 0.0050311560 & 0.1488477220 \\
Transmit & 0.0390311560 & 0.007500960 \\
Sleep & 0.00003870 & 0.1488477220 \\
Deep Sleep & 0.0000354 & 0.694622704 \\
\hline
\end{tabular}
\caption{Current Draw and Time Distribution in Different Modes}
\label{tab:current_distribution}
\end{table}

\subsubsection{Power Consumption Analysis}

Based on our usage profile and battery characteristics:

\begin{itemize}
    \item Average Current: 1.07618 mA
    \item Sleep Current: 38.7824 µA
    \item Peak Current: 47.224281 mA
    \item Weighted Average ESR Loss: 2.73528 µW
    \item On-mode ESR Loss: 0.208469 µW
    \item Off-mode ESR Loss: 0.270733 nW
    \item Peak Current ESR Loss: 401.424 µW
\end{itemize}

The peak current requirement (47.2 mA) is well below the battery's discharge current capability (240 mA at 0.2C), the battery can comfortably handle peak demands.

\subsubsection{Charging Characteristics}

We are using the BQ25570 Power Management IC for battery charging. Key charging parameters include:

\begin{itemize}
    \item Battery Capacity: 1000 mAh
    \item Theoretical Charging Rate: 0.5C (500 mA)
    \item BQ25570 PMIC Maximum Charging Current: 230 mA (typical)
\end{itemize}

\paragraph{Charging Current and Time Calculations}

Theoretical charging current:
\begin{equation}
    I_{charge} = 1000 \text{ mAh} \times 0.5 = 500 \text{ mA}
\end{equation}

Actual charging current (limited by PMIC):
\begin{equation}
    I_{actual} = 230 \text{ mA}
\end{equation}

Estimated charging time:
\begin{equation}
    t_{charge} = \frac{1000 \text{ mAh}}{230 \text{ mA}} \approx 4.35 \text{ hours}
\end{equation}

\subsubsection{Conclusion}

\begin{itemize}
    \item The chosen battery meets the peak current demands of our system.
    \item While capable of 0.5C charging, the actual charging rate is limited to 230 mA by the BQ25570 PMIC.
    \item A full charge from a depleted state takes approximately 4.35 hours.
    \item This charging configuration prioritizes battery longevity and safety over fast charging speeds, aligning with our low-power design goals.
\end{itemize}

\pagebreak

\subsection{Worst-Case Communication Bus Timing}

\begin{table}[H]
    \centering
    \resizebox{\textwidth}{!}{%
    \begin{tabular}{|l|c|c|c|c|}
        \hline
    \textbf{Parameter} & \textbf{IO Expander} & \textbf{Temperature Sensor} & \textbf{Blue Gecko} & \textbf{Worst Case} \\
    \hline
    SCL frequency & 400 kHz & 400 kHz & 400 kHz & 400 kHz \\
    \hline
    SCL high & 0.6 µs & 0.6 µs & 0.6 µs & 0.6 µs \\
    \hline
    SCL low & 1.3 µs & 1.3 µs & 1.3 µs & 1.3 µs \\
    \hline
    Spike time / Suppressed pulse width & 50 ns & 50 ns & - & 50 ns \\
    \hline
    SDA setup & 100 ns & 0.1 µs & 100 ns & 0.1 µs \\
    \hline
    SDA hold & 0 ns & 0.1 µs & 100-900 ns & 0.1-0.9 µs \\
    \hline
    Input rise time & 300 ns & - & - & 300 ns \\
    \hline
    Input fall time & 300 ns & - & - & 300 ns \\
    \hline
    Output fall time (10pF - 400pF load) & 300 ns & - & - & 300 ns \\
    \hline
    Bus free time & 1.3 µs & 1.3 µs & 1.3 µs & 1.3 µs \\
    \hline
    Start setup time & 0.6 µs & 0.6 µs & 0.6 µs & 0.6 µs \\
    \hline
    Start hold time & 0.6 µs & 0.6 µs & 0.6 µs & 0.6 µs \\
    \hline
    Stop setup time & 0.6 µs & 0.6 µs & - & 0.6 µs \\
    \hline
    Data valid time & 1 µs & 0.9 µs & - & 1 µs \\
    \hline
    ACK valid time & 1 µs & 0.9 µs & - & 1 µs \\
    \hline
\end{tabular}%
}
\caption{I2C Fast Mode (400 kHz) Bus Timings}
\label{tab:i2c_fast_mode}
\end{table}

\begin{table}[H]
        \centering
        \resizebox{\textwidth}{!}{%
        \begin{tabular}{|l|c|c|c|}
            \hline
            \textbf{Parameter} & \textbf{IO Expander} & \textbf{Blue Gecko} & \textbf{Worst Case} \\
        \hline
        SCL frequency & 100 kHz & 100 kHz & 100 kHz \\
        \hline
        SCL high & 4 µs & 4 µs & 4 µs \\
        \hline
        SCL low & 4.7 µs & 4.7 µs & 4.7 µs \\
        \hline
        Spike time & 50 ns & - & 0 ns \\
        \hline
        SDA setup & 250 ns & 250 µs & 250 µs \\
        \hline
        SDA hold & 0 ns & 100 µs & 100 µs \\
        \hline
        Input rise time & 1000 ns & - & - \\
        \hline
        Input fall time & 300 ns & - & - \\
        \hline
        Output fall time (10pF - 400pF load) & 300 ns & - & - \\
        \hline
        Bus free time & 4.7 µs & 4.7 µs & 4.7 µs \\
        \hline
        Start setup time & 4.7 µs & 4 µs & 4.7 µs \\
        \hline
        Start hold time & 4 µs & 4 µs & 4 µs \\
        \hline
        Stop setup time & 4 µs & - & 4 µs \\
        \hline
        Data valid time & 1 µs & - & 1 µs \\
        \hline
        ACK valid time & 1 µs & - & 1 µs \\
        \hline
    \end{tabular}%
    }
    \caption{I2C Standard Mode (100 kHz) Bus Timings}
        \label{tab:i2c_standard_mode}
        \end{table}
        \begin{table}[H]
            \centering
    \caption{SPI Communication Parameters}
    \resizebox{\textwidth}{!}{%
    \begin{tabular}{|l|l|l|l|l|l|l|l|l|}
        \hline
        \multirow{2}{*}{\textbf{Parameter}} & \multicolumn{4}{c|}{\textbf{E-Ink Display}} & \multicolumn{4}{c|}{\textbf{Blue Gecko}} \\
    \cline{2-9}
    & \textbf{Condition} & \textbf{Min} & \textbf{Typ} & \textbf{Max} & \textbf{Condition} & \textbf{Min} & \textbf{Typ} & \textbf{Max} \\
    \hline
    \multirow{2}{*}{SCL freq} & Write & - & - & 20 MHz & Write & - & - & 31.25 MHz \\
    & Read & - & - & 2.5 MHz & Read & \multicolumn{3}{c|}{6*tHFPERCLK} \\
    \hline
    \multirow{2}{*}{CS\_setup} & Write & 20 ns & - & - & Write & 12.5 ns & - & - \\
    & Read & 100 ns & - & - & Read & 4 ns & - & 70 ns \\
    \hline
    \multirow{2}{*}{CS\_hold} & Write & 20 ns & - & - & Write & 12.5 ns & - & - \\
    & Read & 50 ns & - & - & Read & 4 ns & - & 70 ns \\
    \hline
    CS\_high & Both & 100 ns & - & - & Both & \multicolumn{3}{c|}{-} \\
    \hline
    \multirow{2}{*}{SCL\_high} & Write & 25 ns & - & - & Write & \multicolumn{3}{c|}{2*tHFPERCLK} \\
     & Read & 180 ns & - & - & Read & \multicolumn{3}{c|}{2.5*tHFPERCLK} \\
     \hline
    \multirow{2}{*}{SCL\_low} & Write & 25 ns & - & - & Write & \multicolumn{3}{c|}{2*tHFPERCLK} \\
    & Read & 180 ns & - & - & Read & \multicolumn{3}{c|}{2.5*tHFPERCLK} \\
    \hline
    \multirow{2}{*}{SDA\_setup} & Write & 10 ns & - & - & Write & 9 ns & - & - \\
    & Read & - & 50 ns & - & Read & 12.5 ns & - & - \\
    \hline
    \multirow{2}{*}{SDA\_hold} & Write & 40 ns & - & - & Write & 9 ns & - & - \\
    & Read & - & 0 ns & - & Read & 13 ns & - & - \\
    \hline
\end{tabular}%
    }
    \subsubsection{SPI Bus Timing}
    \label{tab:spi_params}
\end{table}

\subsection{High-Risk Development Items}
\subsubsection{Hardware Challenges}
\begin{itemize}
    \item \textbf{PCB Design for Key Matrix:} Creating an accurate PCB layout for the keyboard matrix is significant challenge, as our design is based only on datasheet specifications without physical prototyping.
    
    \item \textbf{Ergonomic Key Spacing:} Determining the ergonomic spacing between keys is importanant. We are considering a 19.05 mm center-to-center distance, but the ergonomic efficacy of this choice remains uncertain.
    
    \item \textbf{Key Mounting Mechanism:} Developing a precise gasket or mounting system for the keys, whether PCB-based or 3D-printed, requires exact dimensional accuracy to ensure proper key fit and function.
\end{itemize}

\subsubsection{Software Challenges}
\begin{itemize}
    \item \textbf{E-Ink Display Driver:} Development of a custom driver for the E-ink display is expected to be time-intensive.
    
    \item \textbf{Multi-Host Connectivity:} Implementing firmware to support seamless multi-host connections presents significant complexity.
\end{itemize}

\subsection{Mitigation Plans}
To address the identified risks and challenges, we have developed the following mitigation strategies:

\subsubsection{Prototyping and Manufacturing}
\begin{itemize}
    \item We have access to the ITLL 3D printing facility,
    \begin{itemize}
        \item Prototype cases and gaskets using PLA
        \item Iterate designs rapidly and cost-efficiently.
        \item Produce final components using high-quality materials once designs are finalized.
    \end{itemize}
\end{itemize}

\subsubsection{Hardware Development}
\begin{itemize}
    \item Initially utilize development boards, modules, and breadboards for proof-of-concept.
    \item Test and validate circuit functionality before proceeding to schematic design.
    \item Implement incremental improvements based on prototype performance.
\end{itemize}

\subsubsection{Software Development}
\begin{itemize}
   
    \item Develop initial drivers for more commonly used platforms (e.g., STM32 or Arduino).
    \item Validate display functionality on these platforms.
    \item Port the verified code to our target EFR32BG13 platform.

\end{itemize}

\subsection{Update}
Our project is progressing as scheduled. Key developments include:
\begin{itemize}
    \item Firmware development is on track.
    \item Hardware integration is proceeding as planned.
    \item Schematic design is nearing completion.
\end{itemize}

\subsection{gnatt chart}
Figure \ref{fig:gantt_chart} presents our updated Gantt chart, reflecting the current project timeline and milestones.\\
{\center
\href{https://github.com/users/parthishere/projects/2/views/1}
{GITHUB}}

\begin{figure}[h]
    \centering
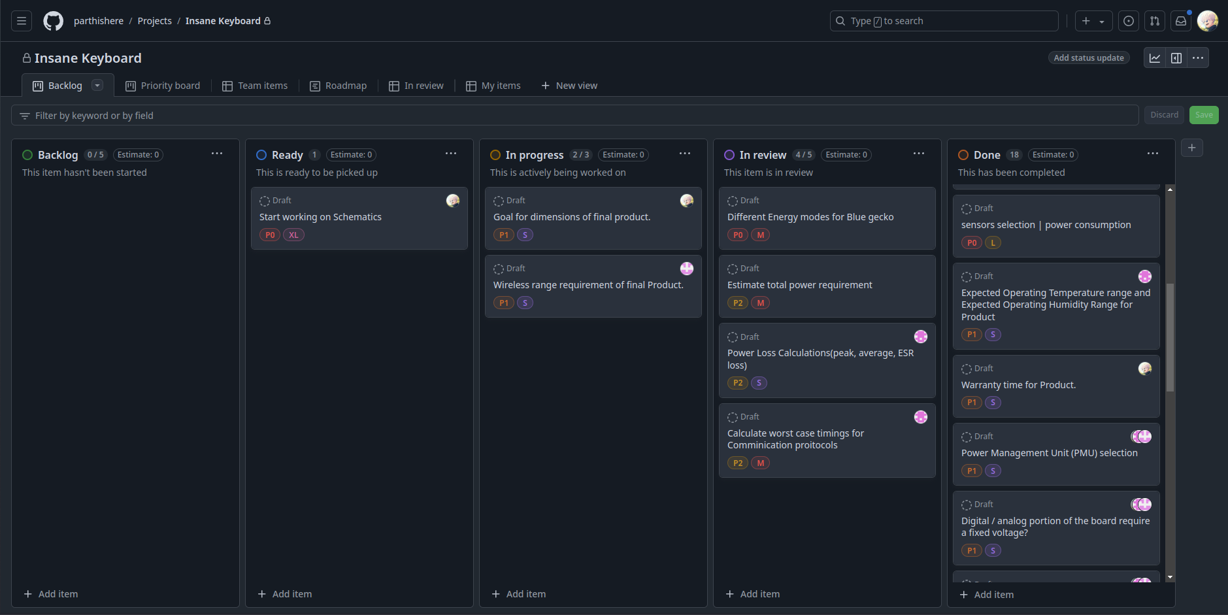
[picture p23: project_report/figures/update3.png]
    
    \caption{Updated Project Gantt Chart}
    \label{fig:gantt_chart}
\end{figure}

\pagebreak

\hrule

\section{\color{red}{Update 4}}

\subsection{Microcontroller Programming}

The EFR32BG13 microcontroller will be programmed using the Mini Serial Wire Debug (SWD) interface. This method is described in Silicon Labs application note AN0062. The SWD interface uses two signals:

\begin{itemize}
    \item SWDIO: A bidirectional data line
    \item SWCLK: A clock line controlled by the host device
\end{itemize}

The Mini SWD connector has a 5x2 header. This header connects to the Blue Gecko development board using a female SWD ribbon cable.

\begin{figure}[H]
    \centering
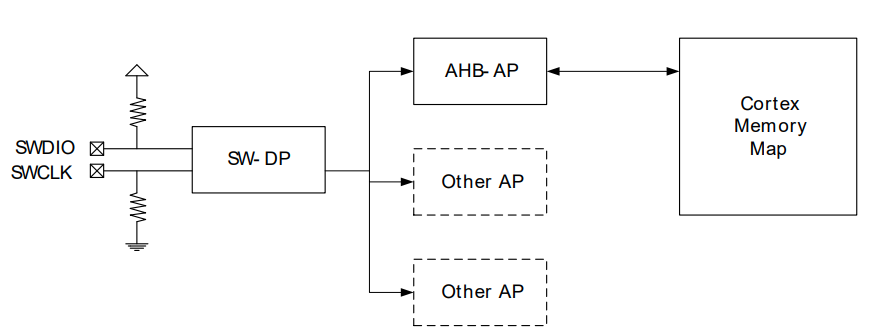
[picture p24: project_report/figures/serial_wire.png]
    
    \caption{Serial Wire Debug Interface}
\end{figure}

\begin{figure}[H]
    \centering
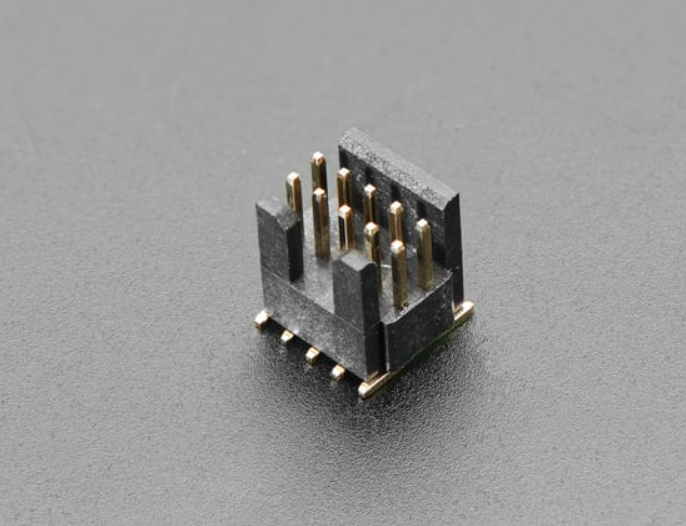
[picture p25: project_report/figures/miniSWD.png]
    
    \caption{Mini SWD (5 x 2 header)}
\end{figure}

\begin{figure}[H]
    \centering
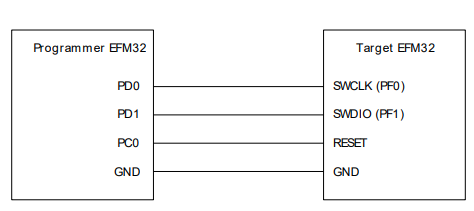
[picture p26: project_report/figures/defaultPCefm.png]
    
    \caption{Default Programmer Connection EFM32GG-STK3700}
\end{figure}

\subsection{Test Points}

We have added test points to various signals on the board. Table \ref{tab:test_points} lists these test points.

\begin{table}[H]
    \centering
    \begin{tabular}{|l|l|l|}
        \hline
        \textbf{Module} & \textbf{Designator} & \textbf{Signal} \\
        \hline
        Interrupts & TP1 & IO\_ROW\_INT \\
        & TP2 & IO\_COL\_INT \\
        \hline
        Temperature sensor & TP3 & TEMP\_LOAD\_SW \\
        \hline
        Mini SWD connector & TP4 & RESET \\
        & TP5 & SWDIO \\
        & TP6-TP11 & Various SWD signals \\
        \hline
        eInk display & TP12-TP15 & Display control signals \\
        \hline
        I2C communication & TP16 & SCL \\
        & TP17 & SDA \\
        \hline
        Power supply & TP18-TP25 & Various power signals \\
        \hline
        Crystals & TP26-TP29 & Crystal connections \\
        \hline
    \end{tabular}
    \caption{Test Points}
    \label{tab:test_points}
\end{table}

\subsection{Reset Circuit}

The reset input of the EFR32BG13 is active low. It is internally connected to AVDD through a pull-up resistor. Our reset circuit consists of:

\begin{itemize}
    \item A 100 $\Omega$ resistor connected to ground
    \item A 1 $\mu$F capacitor for debouncing
\end{itemize}

This circuit prevents unwanted resets due to electrical noise.

\begin{figure}[H]
    \centering
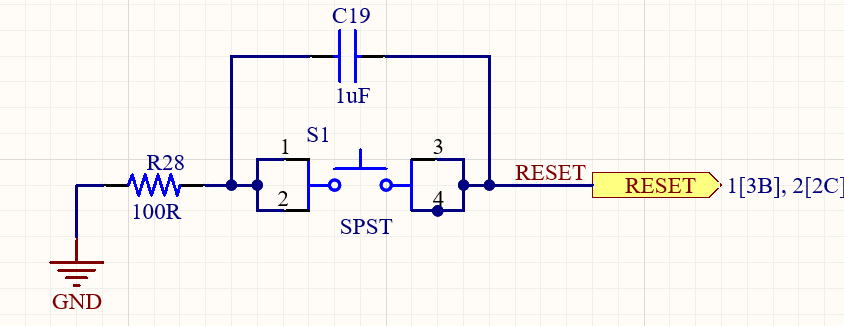
[picture p27: project_report/figures/reset_circuit.png]
    
    \caption{Reset Circuit}
\end{figure}

\subsection{Clock Generation}

We use two crystals for clock generation:

\begin{itemize}
    \item High-frequency crystal: 38.4 MHz
    \begin{itemize}
        \item Connected to HFXTAL\_N and HFXTAL\_P
        \item Internal capacitor range: 9 - 25 pF
    \end{itemize}
    \item Low-frequency crystal: 32.768 kHz
    \begin{itemize}
        \item Connected to LFXTAL\_N and HFXTAL\_P
        \item Internal capacitor range: 8 - 40 pF
    \end{itemize}
\end{itemize}

These crystals provide accurate timing for the microcontroller's operations.

\subsection{Power Management and Energy Sources}

\subsubsection{Energy Sources}

The keyboard can be powered by:

\begin{itemize}
    \item Solar panel with energy harvesting circuit
    \item USB-C power
    \item AEM pin on the Mini SWD connector (for jumpstart)
\end{itemize}

We added a 0 $\Omega$ resistor between the PMU output and the MCU power supply. This allows isolation during jumpstart.

\subsubsection{Power Specifications}

\begin{itemize}
    \item PMU maximum current: 240 mA
    \item Jumpstart source maximum current: 300 mA
    \item Energy storage maximum current: 240 mA
    \item Simulated maximum battery current: 58 mA
    \item Simulated maximum inductor current: 165 mA
\end{itemize}

\subsubsection{Battery Management}

\begin{itemize}
    \item Minimum battery voltage: 3 V
    \item Voltage regulation: Boost converter
    \item Output voltage: 3.3 V
    \item Battery cutoff voltage: 3 V
\end{itemize}

We use a boost converter to maintain 3.3 V output as the battery voltage decreases to 3 V.

\subsection{Power Analysis}

Our simulations show:

\begin{equation}
    I_{battery,max} = 58 \text{ mA}
\end{equation}
\begin{equation}
    I_{inductor,max} = 165 \text{ mA}
\end{equation}

The PMIC can supply 230 mA peak current. This gives us a margin of:

\begin{equation}
    \text{Current Margin} = 230 \text{ mA} - 165 \text{ mA} = 65 \text{ mA}
\end{equation}

\begin{equation}
    \text{Margin Percentage} = \frac{65 \text{ mA}}{230 \text{ mA}} \times 100\% = 28.3\%
\end{equation}

This margin ensures the power system can handle varying loads.

\subsection{3D Printed Keyboard Case}

We have made significant progress on the mechanical design of our keyboard. Using 3D printing technology, we have successfully produced the left side of the keyboard case. This prototype has provided valuable insights into the physical dimensions and ergonomics of our design.

\begin{figure}[H]
    \centering
    
    \caption{3D printed left side of the keyboard case}
\end{figure}

\begin{figure}[H]
    \centering
    
    \caption{3D printed left side of the keyboard case}
\end{figure}

\begin{figure}[H]
    \centering
    
    \caption{3D printed left side of the keyboard case}
\end{figure}

The 3D printed case fits our components very well, confirming the accuracy of our 3D model. This success validates our approach to the mechanical design and provides a solid foundation for further refinements.

Our next steps in the case design process include:

\begin{itemize}
    \item Modifying the 3D model to include precise cutouts for the display and rotary encoder knobs
    \item Refining the internal structure to accommodate the PCB and other electronic components
    \item 3D printing the right side of the keyboard case
    \item Iterating on the design based on assembly and usability tests
\end{itemize}

\subsection{Progress Update}

\subsubsection{Completed Tasks}
\begin{itemize}
    \item Created schematic
    \item Generated component footprints
    \item Developed board programming plan
    \item Assigned test points
    \item Planned alternate power sources
    \item Created 3D model of keyboard case
    \item Acquired components for breadboard prototype
    \item Simulated PMU and verified power requirements
\end{itemize}

\subsubsection{Upcoming Tasks}
\begin{itemize}
    \item Start firmware development
    \item Finalize schematic
    \item Create initial PCB layout
    \item Assemble breadboard prototype
\end{itemize}

\subsection{Conclusion}

Our project is on schedule. We have not encountered any major problems. We have completed the power system design and validated it through simulation. Our next steps focus on firmware development and building a physical prototype to test our design.

\pagebreak

\hrule

\section{\color{red}{Update 5}}

\subsection{Bulk capacitor selection}

Voltage requirements of the components in the system
\begin{table}[h!]
    \centering
    \begin{tabular}{|l|c|c|c|c|}
    \hline
    \textbf{Component}        & \textbf{Min} & \textbf{Typ} & \textbf{Max} & \textbf{Units} \\ \hline
    BlueGecko                 & 1.8          &              & 3.8          & V             \\ \hline
    PMIC                      & 0.1          &              & 5.1          & V             \\ \hline
    eInk Display              & 2.2          &              & 3.7          & V             \\ \hline
    Load Switch               & 1.6          &              & 5.5          & V             \\ \hline
    Temperature sensor        & 1.9          &              & 3.6          & V             \\ \hline
    IO Expander               & 1.65         &              & 5.5          & V             \\ \hline
    \end{tabular}
    \caption{Voltage Range requirements of the system}
    \end{table}
    
    \begin{table}[h!]
        \centering
        \begin{tabular}{|l|c|c|}
        \hline
        \textbf{Parameter}   & \textbf{Value} & \textbf{Units} \\ \hline
        $V_{\text{in\_min}}$    & 3.0            & V             \\ \hline
        $V_{\text{in\_max}}$    & 4.2            & V             \\ \hline
        $V_{\text{in\_nominal}}$ & 3.7            & V             \\ \hline
        \end{tabular}
        \caption{Input Voltage Specifications}
        \end{table}
        
    As per the results from the simulation, upon using a 22uF bulk capacitor with worst case input voltage of 3V, the Vout ranges from 2.677V to 3.31V. 
    \begin{figure}[H]
        \centering
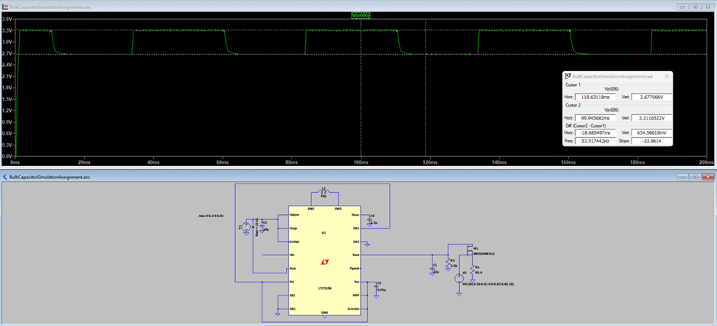
[picture p28: project_report/figures/Update5/3V_22uF_Vout_simulation.png]
        
        \caption{Simulation of Vout with 3V input}
    \end{figure}
        
    The current through the inductor has a max running current of 

\begin{table}[h!]
    \centering
    \begin{tabular}{|l|r|}
    \hline
    \textbf{Parameter}                   & \textbf{Value} \\ \hline
    Capacitor manufacturing tolerance     & 0.2            \\ \hline
    DC bias tolerance                     & 0.55           \\ \hline
    Aging degradation                                & 0.1            \\ \hline
    Temperature degradation                          & 0.125          \\ \hline
    Total degradation                     & 0.7165         \\ \hline
    Initial capacitance                   & 47 \,uF         \\ \hline
    Total tolerance                       & 13.3245 \,uF    \\ \hline
    \end{tabular}
    \caption{Capacitor Tolerance and Degradation Table Part number: GRM21BR61A476ME15K}
    \end{table}

    \begin{figure}[H]
        \centering
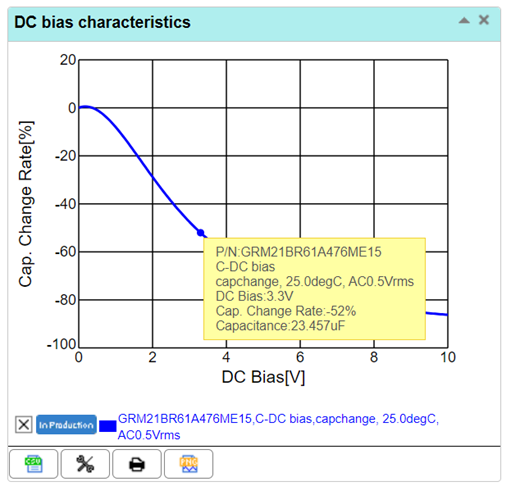
[picture p29: project_report/figures/Update5/DC bias characteristics of capacitor .png]
        
        \caption{DC bias characteristics of GRM21BR61A476ME15K}
    \end{figure}

    \begin{figure}[H]
        \centering
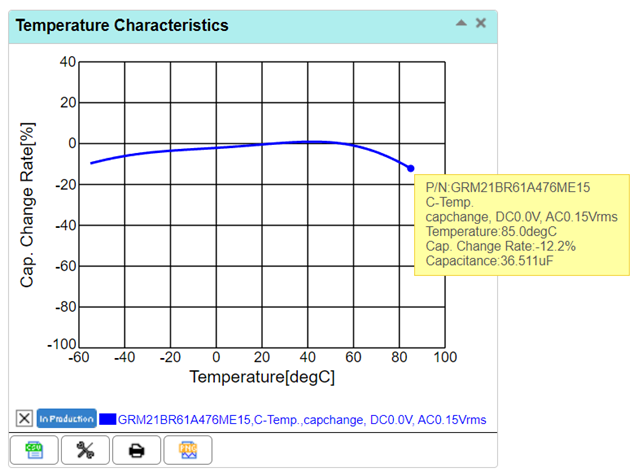
[picture p30: project_report/figures/Update5/Temperature characteristics of capacitor.png]
        
        \caption{Temperature characteristics of GRM21BR61A476ME15K}
    \end{figure}

    \begin{figure}[H]
        \centering
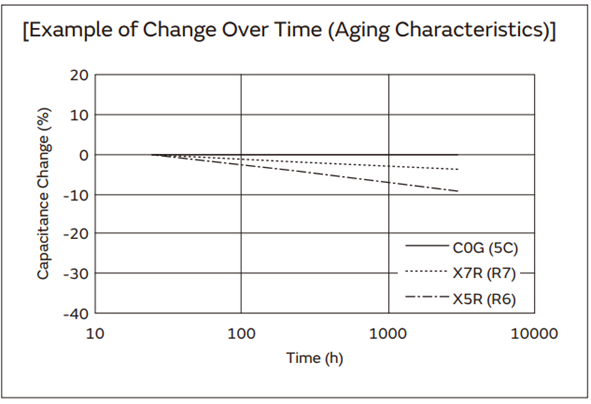
[picture p31: project_report/figures/Update5/Aging characteristics of capacitor.png]
        
        \caption{Aging characteristics of GRM21BR61A476ME15K}
    \end{figure}

    The worst case degradation of the capacitor is 71\%. The effective capacitance value comes to a worst case of 13.3uF.
    Hence to achieve a suitable bulk capacitance, we need to use two 47uF bulk capacitors or 47uF each. 

\subsection{ESD considerations}
%there is some error in this part
I/O ports in our design:
\textbf{USB:} These are connected to an TVS diode for ESD protection since these pins are exposed to ESD. 
\begin{itemize}
    \item $USB\_VBUS$
    \item $USB\_Data\_N$
    \item $USB\_Data\_P$
\end{itemize}
\textbf{SWD pins:} These pins are not easily victim to ESD since they are not accessed by the user. It is accessed only during programming and debugging. 
\begin{itemize}
    \item {VAEM (Power)}
    \item {Reset}
    \item $VCOM\_TX$ and $VCOM\_RX$
    \item $SWDIO$, $SWCLK$, $SWO$
\end{itemize}
\textbf{Reset switch:}
\textbf{DPDT switch:}

\subsection{Missed in previous updates}
Max current throught he inductor is 160mA. This is within the max current limit of 230mA of the PMIC. 

\subsection{Progress Update}

\subsubsection{Completed Tasks}
\begin{itemize}
    \item Created schematic
    \item Developed board programming plan
    \item Acquired components for breadboard prototype
    \item Simulated PMU and verified power requirements
\end{itemize}

\subsubsection{Upcoming Tasks}
\begin{itemize}
    \item Start firmware development
    \item Finalize schematic
    \item Create initial PCB layout
    \item Assemble breadboard prototype
\end{itemize}

\subsection{Conclusion}

Our project is on schedule. We have not encountered any major problems. We have completed the power system design and validated it through simulation. Our next steps focus on firmware development and building a physical prototype to test our design.

%---------------------------------------------------------------------------
\end{document}
-
