parthishere/Insane-Keyboard/project_report/content/title_page.tex

\begin{titlepage}
\center % Center everything on the page

%-------------------------------------------------------------------------------------
%	HEADING SECTIONS
%------------------------------------------------------------------------------------
\textbf{\large Department of Electrical and Computer Engineering}\\[0.5cm]
\textbf{\Large University of Colorado at Boulder}\\[1cm]
\textbf{\large ECEN5833 - Low Power Embedded Design Techniques}\\[2cm]
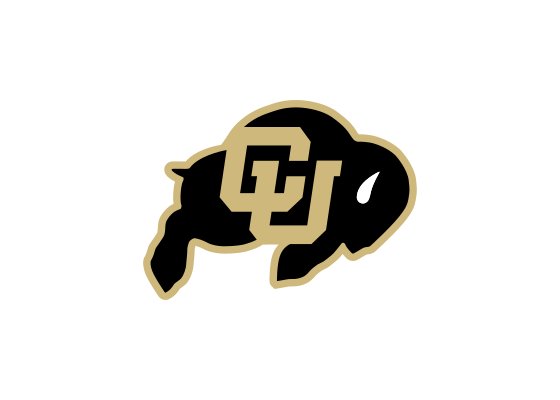
[picture p32: project_report/figures/cu.png]
\\[2cm] 

%-------------------------------------------------------------------------------------
%	TITLE SECTION
%------------------------------------------------------------------------------------
\textbf{\Huge Fall 2024, ECEN 5833 }\\[0.2cm]

\textbf{\Large Course Project Report}\\[2cm]
\href{https://github.com/users/parthishere/projects/2}{GITHUB Project}\\
\href{https://github.com/parthishere/Insane-Keyboard}{GITHUB Code link}
\vspace{1.5cm}
% \begin{figure}[H]
% 	\centering
% 	\includegraphics[scale=0.2]{figures/qr_download.png}
% 	\label{555_schematic}
% \end{figure}\vspace{1.3cm}

%----------------------------------------------------------------------------------------
%	MEMBERS SECTION
%----------------------------------------------------------------------------------------

\vfill

\textbf{\large Submitted by}

{\large Parth Thakkar}\\
{\large Anagha Aditya}\\
{\large Akash Karoshi}\\[0.5cm]

%----------------------------------------------------------------------------------------
%	DATE SECTION
%----------------------------------------------------------------------------------------

\textbf{\large Submitted on}\\
\textbf{\Large \today} % Date, change the \today to a set date if you want to be precise

%----------------------------------------------------------------------------------------

\vfill % Fill the rest of the page with whitespace

\end{titlepage}
