parthishere/Insane-Keyboard/HardwareDesign/PCB/InsaneKeyboard (Copy)/InsaneKeyboard.PcbDoc.htm

Reporting Options

# File in Previous Format

Date | : | 20-10-2024
Time | : | 11:09:50
Filename | : | D:\Embedded Systems - MS\LowPowerEmbeddedSystems\Insane-Keyboard\HardwareDesign\PCB\InsaneKeyboard\InsaneKeyboard.PcbDoc

Version | Warning
Release 24.4 | CAUTION - This PCB document contains polygon pours with the "Obey Rules" option enabled. If you save the PCB document in this older version, the "Obey Rules" option will be turned off for these polygon pours.

This file was generated by a later version of the software
