parthishere/Insane-Keyboard/HardwareDesign/ExcelSheets/Current and Power Calculations.xlsx

Sheet: Sheet1
EM3 | RTCC | Using ULFRCO | 3e-06 | Working |  |  |  |  | Sleep
EM2 |  | Using PLFRCO | 3.3e-06
EM0 |  | Using | 0.0049152 | Blue gecko
 |  |  |  |  | EM3 | RTCC | Using ULFRCO | 3e-06 | EM2 | Using PLFRCO | 3.3e-06
 |  |  |  |  | EM2 |  | Using PLFRCO | 3.3e-06 | EM0 | Using | 0.0049152
Eink display |  |  |  |  | EM0 |  | Using | 0.0049152
RefreshPower |  |  | 0.03
Standby |  |  | 1.7e-05 | E ink
 |  |  |  |  | RefreshPower |  |  | 0.03 | Standby |  | 1.7e-05
Load Switch
TPS22919 | 5.5V | 1.5A |  | Load Switch x2
PMIC - | 85% efficiency |  |  |  |  |  |  |  | Quiescent |  | 3e-05
TIBQ25570
Quiscent current |  |  | 4.88e-07 | PMIC
On state |  |  | 8e-06
Si7021
 | Standby |  | 0.06*10^-6 | Si7021
 | Startup |  |  |  | I2C transaction |  |  | 0.0035 | Standby |  | 0.06*10^-6
 | I2C transaction |  | 0.0035 |  | Humidity and temp reading |  |  | 0.09
 | Humidity and temp reading |  | 0.09
 |  |  |  | IO expander
IO expander |  |  |  |  |  |  |  |  | Quiscent current |  | 1.5e-06
TCA6408A
Quiscent current |  |  | 1.5e-06

Sheet: Sheet3
Component | Description |  |  | Current | Start up | Active | Sleep | Deep Sleep
BlueGecko
 | EM3 | RTCC | Using ULFRCO | 3e-06 |  | 1 | 1 | 1
 | EM2 |  | Using PLFRCO | 3.3e-06 |  | 0 | 1
 | EM0 |  | 38.4MHz clock | 0.0049152 |  | 1
Power Supply
 | Quiescent |  |  | 7e-07 | 1 | 1 | 1 | 1
Eink display
 | RefreshPower |  |  | 0.03 |  | 1 | 1
 | Standby |  |  | 1.7e-05 |  | 1 | 1
 | Quiesent Current
Load Switch x2
 | Quiescent |  |  | 3e-05 | 1 | 1 | 1 | 1
 | Resistance ON State |  | 0.2 OHMS
Si7021
 | Standby |  |  | 6e-08 | 1 | 1 | 1 | 1
 | Startup |  |  | 0.004 | 1
 | I2C transaction |  |  | 0.004
 | Humidity and temp reading |  |  | 0.00018
 | Average Current during reading |  |  | 0.0008 |  | 1 | 1
IO expander
TCA6408A | Quiscent current |  |  | 1.5e-06 | 1 | 1 | 1 | 1
Current(A) |  |  |  |  | 0.00403226 | 0.03084926 | 0.03084926 | 3.226e-05
Power(W) |  |  |  |  | 0.013306458 | 0.101802558 | 0.101802558 | 0.000106458
Time (s) |  |  |  |  | 105 | 86400 | 86400 | 403200
%Time |  |  |  |  | 0.0001822584425 | 0.1499726612 | 0.1499726612 | 0.6998724191
Energy(J) = Power x %Time |  |  |  |  | 2.42521431e-06 | 0.01526760054 | 0.01526760054 | 7.450701799e-05
Average power(W) |  |  |  |  | 0.03061213332
Energy required for 24 hour(J) |  |  |  |  | 2644.888319
Min capacitance (F) |  |  |  |  | 0.3826516665
Energy needs of the device and application (mins) |  |  |  |  | 1.904761905

Sheet: Sheet2
 | MIN | TYP | MAX
AVDD supply | 1.8 | 3.3 | 3.8
Temp
