parthishere/Insane-Keyboard/HardwareDesign/ExcelSheets/Schematic review_checklist _20240930.xlsx

 |  | Schematic Entry Review worksheet (Verstion 09-30-2024) | Schematic Entry Engineer Review comments /justifications | Partner 1 Engineer Schematic Review comments | Partner 2 Engineer (If team of 3) Schematic Review comments | SA Schematic Review 1 Comments | SA Schematic Review 2 Comments
 |  | Date:
 |  | Engineeer/ Reviewer Name:
 |  | Project name:
 |  | Circuits:
1. Symbol Generation
 | a. Review all custom made .schLib files.
 |  | i. Verify that the schematic symbol is appropriate for the device function. | Done | Done | Done
 |  | ii. If symbol is multipart, verify functional divisions make sense | Done | Done | Done
 |  | iii. Make sure all component pins are accounted for on symbol(s). (Count them!) | Done | Done | Done
 |  | iv. Verify the schematic pin #s match the data sheet. | Done | Done | Done
 |  | v. If thermal pad is required, verify that a pin is specified for the pad and connected to ground. | Done | Done | Done
 |  | vi. Review that the same IC package is selected on the merchant website and on the parameter entry in schematic symbol. | Done | Done | Done
 | b. Verify that all the Parts have their part numbers updated. |  | Done | Done | Done
 | c. Verify that all the segments of a multipart component have the same reference designator assigned. |  | Done | Done | Done
2. Component Selection
 | a. Decoupling capacitor selected should be rated for 175 to 200% of the voltage on the rail. |  | Done | Done | Done
 | b. Guideline, not rule: All resistor 0603 or justify a different size |  | Few have 0402, used for isolation | Few have 0402, used for isolation | Different sizes - 0402 and 0603
 |  | i. space constraints demand smaller, (don’t go smaller than 0402)
 |  | ii. or use case power requires larger
 | c. Guideline, not rule: All Caps 0805 or justify a different size |  | Only bulk cap is 0805, rest are 0603 | Only bulk cap is 0805, rest are 0603 | Bulk capacitors are of 0805
 |  | i. space constraints demand smaller, (don’t go smaller than 0402)
 |  | ii. or capacitance requires larger package,
 |  | iii. or smaller part required to achieve desired response frequency.
3. Page Layout
 | a. Block diagram on first page. |  | Yes | Yes | Done
 | b. Functional blocks grouped logically on pages |  | Yes | Yes | Done
 | c. Pages not overcrowded |  | Yes | Taken care | Done
 | d. Schematics designed to print on 8.5 x 11” page (OK to use 'B' size sheet and shrink to print.) |  | US letter size | Used 8.5*11" - latter size
 | e. Title blocks on all pages? Properly filled in? |  | Done | Done | Done
4. Design
 | a. For every IC
 |  | i. Check voltages on each part. Verify that signals connecting devices are at the same voltages or are open collector (open Drain) signals. | Done | Seems to be correct | Done
 |  | ii. Check whether each signal pin is open drain, and if yes, is there a pull-up resistor. | IO expander has internal pull down | No, as an input we have io expander which is internally pulled low | Done
 |  | iii. Verify the no device on a given bus will be powered down and pull the bus signals low when other devices are trying to communicate. | Yes we will take care that in software | We shouldn’t have an issue with this, its realted to Software and we plan to take care of that | Done
 | b. Go through the PMU datasheet to understand the settings.
 |  | i. Verify that the maximum voltages on any pins are within the device’s PMU specifications. | Done | Done | Done
 |  | ii. Go through each PMU pin specification in order of the data sheet | Done | Done | Done
 |  | iii. Check whether each pin requires a decoupling capacitor. | Done | No, Output, input, vstor, vref - done | Done
 |  | iv. Show math for calculating all feedback components - best to show math on schematic. | Done | Done
 |  | v. Show math for calculating all compensation components - best to show math on schematic. | Done | Done
 | c. What is the planned cut-off voltage of the battery? |  | ~2.9 volts | 3 volts | 3V
 |  | i. Confirm that the PMU is set to disable power to the digital circuit when the battery goes below the cut-off voltage | done | done
 | d. If design is different from reference schematic from vendor, why? |  | We just have added type C in series with Solar. | For type C to charge the battery, which is not present in the reference material from vendor
 |  | i. Justify changes | Viewed one application note | not present in the reference material from vendor
 | e. If super capacitor is chosen as the storage device, check for the leakage current. |  | Not applicable | No Supercap used | No super cap
 | f. Verify if the different modules can be isolated from each other to ease the testing process. |  | Yes, IO expander and display can be isolated | Yes, IO expander and display can be isolated | Yes
 | g. Add a header on the energy harvester to check for current consumption. |  | Done | Done
 | h. If using UART and if the microprocessor is an EFM32LG, an external oscillator will be required as the RC Oscillator isn’t accurate enough to run at 9600 baud rate. |  | Not applicable | N/A
 | i. Every power pin on a part or header should have a decoupling capacitor. |  | Done | Done | Done
 | j. Does design have an appropriate programming connector or method? |  | Mini Simplicity Connector | Mini Simplicity Connector | yes
 |  | i. Does design provide enough power for programming MCU or does it have an alternate programming power connection? | Not applicable | N/A | yes
 | k. Can battery or cap be initially powered in reasonable time? |  | Yes | Yes | yes
 | l. Does schematic have extra GND test point pins to be spread around board? (6-8?) |  | Yes | Yes | yes
 | m. Test point pins on busses? |  | Done | Done | yes
 | n. Test point pins on interrupts? |  | Done | Done | yes
 | o. Extra test pins on spare IO for scope triggers for profiling? |  | Done | Done | yes
 | p. Consider adding LED indicators, especially on the power rails and add it close the subsystem under test (easy to identify if the subsystem is powered on/off). |  | Done | Done
5. Wiring
 | a. Verify the direction and use of the LEDs. |  | Verified | power on LED- verified, we plan to desolder after the final product starts working, due to power consumption
 | b. Verify that the GNDs have all the same name where ever required. |  | Done | Done | yes
 | c. Verify that all appropriate power lines have the same name. |  | Done | Done | yes
 | d. Verify any communication lines: |  | Data/ clock verified | I2C, SPI - Data and clock verified | yes
 |  | i. If one part will be active while another one is powered off on the line, is there a condition where an ESD diode could be pulling the line down? | Not applicable | N/A
 | e. Verify whether any UART RTS and CTS lines need to be shorted or left open. |  |  | No UART Used
 | f. Verify that the micro controller UART TX pin connects to the RX pin of the slave device and that the TX pin of slave device connects to the RX pin of the microcontroller. |  | Not Used | N/A
 | g. Verify that the RESET pin is connected correctly as per the functionality (Active Low/Active High). |  | verified | verified - active low, internally pulled high | yes
 | h. Reset button with proper pull-up / capacitor configuration |  | Internally pulled high | Internally pulled high, and a cap for hardware debounce | yes
 | i. Can you justify the reset metodology for each digital component? |  | We have used gpio reset for both of the io expander and display | Io expander and Display has the reset pin and for the temp sensor we use load power | yes
 | j. All signals should be correctly named. Do not use Altium default signal names. |  | Done | Used Correct Names | yes
 | k. Corectly name the signals of the communication lines in the schematics for ease in debugging. |  | Done | Done | yes
