parthishere/Insane-Keyboard/HardwareDesign/PCB/InsaneKeyboard/Project Outputs for InsaneKeyboard/Report Board Stack/InsaneKeyboard.xls

Board Stack Report
Stack Up |  | Layer Stack
Layer | Board Layer Stack | Name | Material | Thickness | Constant
1 |  | Top Overlay |  | 0mil
2 |  | Top Solder | SM-001 | 0.8mil | 4
3 |  | Top Surface Finish | PbSn | 0.787mil
4 |  | Top Layer | CF-004 | 1.4mil
5 |  | Dielectric 1 | PP-017 | 4mil | 4.3
6 |  | Int1 (GND) | CF-004 | 1.4mil
7 |  | Dielectric 3 | Core-039 | 47mil | 4.8
8 |  | Int2 (GND) | CF-004 | 1.4mil
9 |  | Dielectric 5 | PP-017 | 4mil | 4.3
10 |  | Bottom Layer | CF-004 | 1.4mil
11 |  | Bottom Surface Finish | PbSn | 0.787mil
12 |  | Bottom Solder | SM-001 | 0.8mil | 4
13 |  | Bottom Overlay |  | 0mil
 | Height : 63.774mil
