parthishere/Insane-Keyboard/HardwareDesign/PCB/InsaneKeyboardTwoLayer/Project Outputs for InsaneKeyboard/Report Board Stack/InsaneKeyboard.xls

Board Stack Report
Stack Up |  | Layer Stack
Layer | Board Layer Stack | Name | Material | Thickness | Constant
1 |  | Top Overlay |  | 0mil
2 |  | Top Solder | SM-001 | 1mil | 4
3 |  | Top Surface Finish | PbSn | 0.787mil
4 |  | Top Layer | CF-004 | 1.378mil
5 |  | Dielectric 1 | Core-043 | 59mil | 4.3
6 |  | Bottom Layer | CF-004 | 1.378mil
7 |  | Bottom Surface Finish | PbSn | 0.787mil
8 |  | Bottom Solder | SM-001 | 1mil | 4
9 |  | Bottom Overlay |  | 0mil
 | Height : 65.33mil
