parthishere/Insane-Keyboard/Keyboard_Firmware/image.png

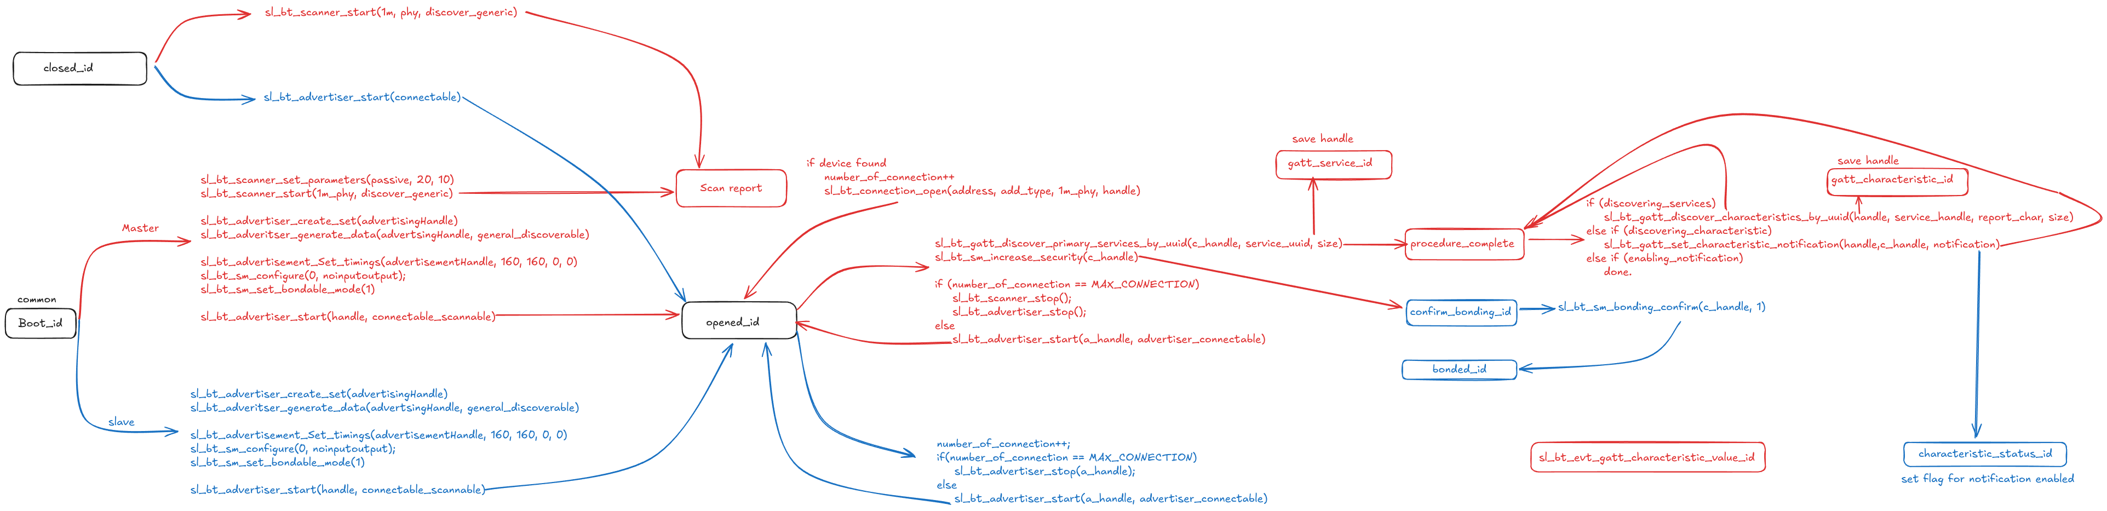
Keyboard_Firmware/image.png
