parthishere/Insane-Keyboard/project_report/figures/AEM.png

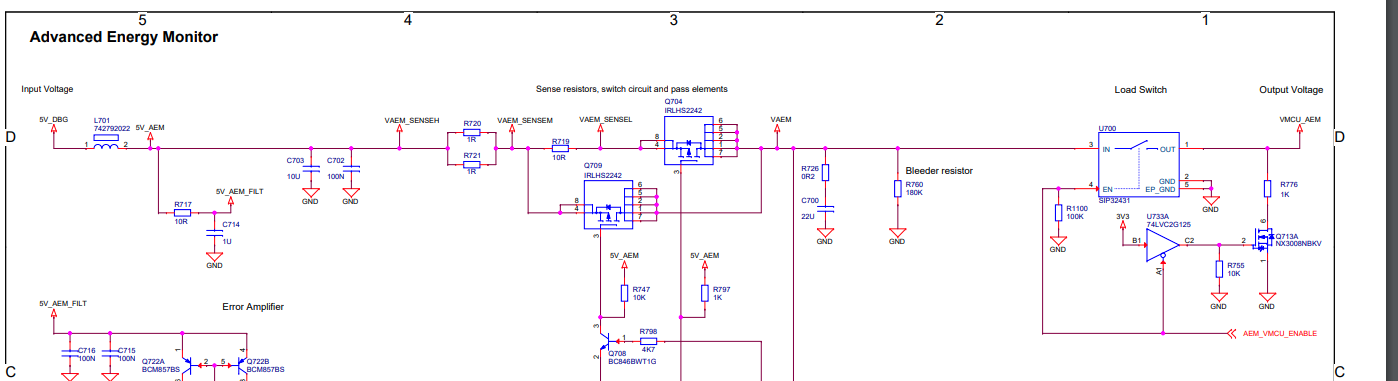
project_report/figures/AEM.png
