parthishere/Insane-Keyboard/project_report/figures/currentMCU.png

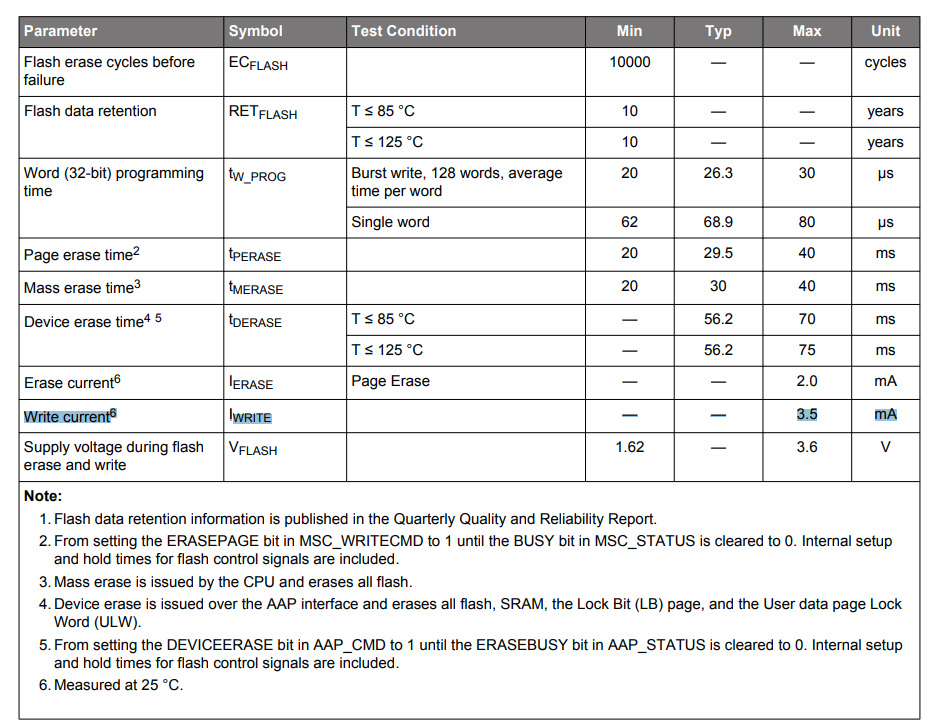
project_report/figures/currentMCU.png
