parthishere/Insane-Keyboard/project_report/figures/HSXO.png

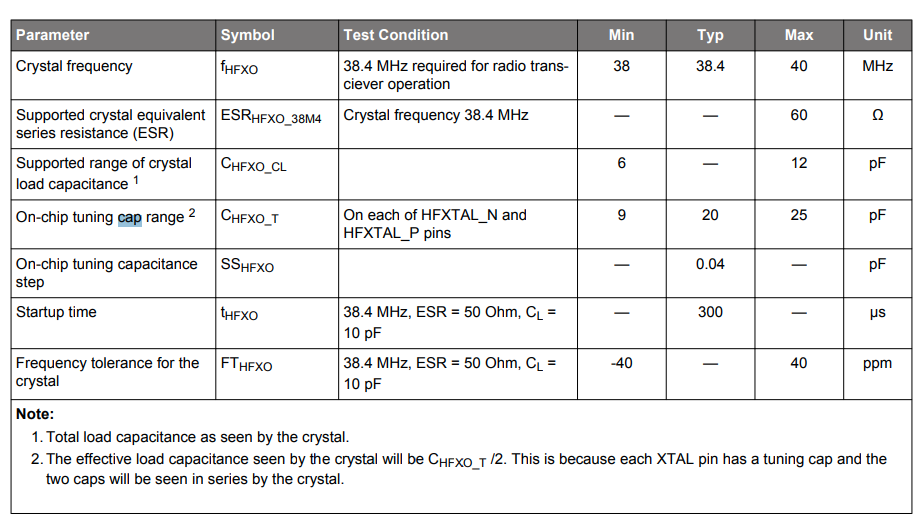
project_report/figures/HSXO.png
