parthishere/Insane-Keyboard/project_report/figures/hw.png

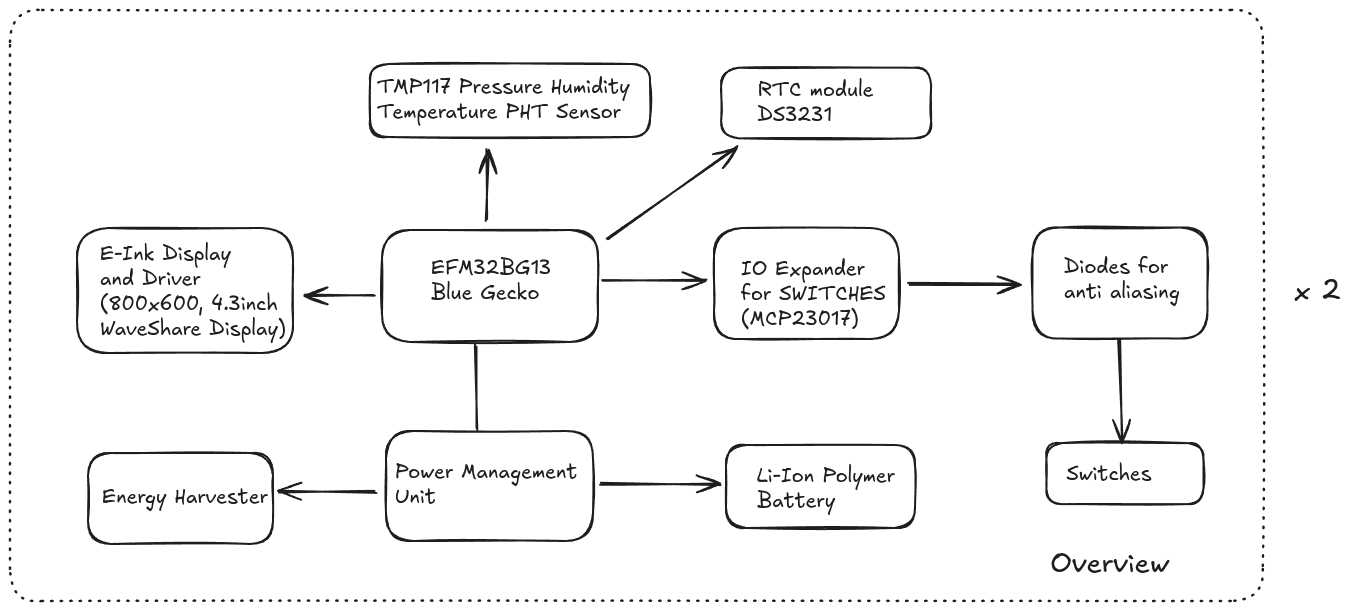
project_report/figures/hw.png
