parthishere/Insane-Keyboard/project_report/figures/image copy 2.png

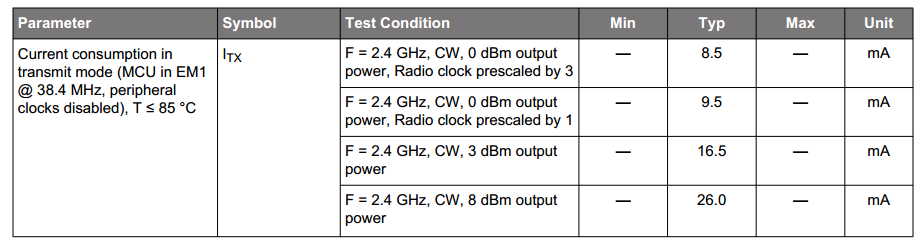
project_report/figures/image copy 2.png
