parthishere/Insane-Keyboard/project_report/figures/image copy.png

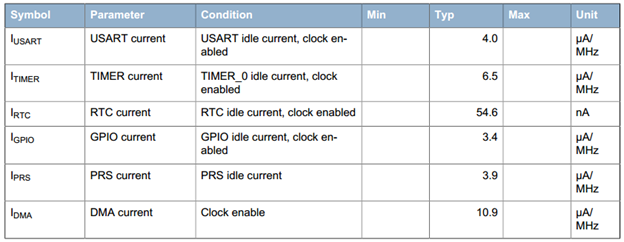
project_report/figures/image copy.png
