parthishere/Insane-Keyboard/project_report/figures/image.png

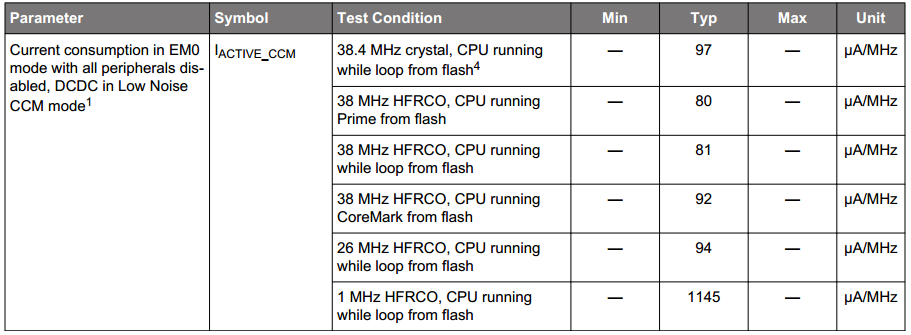
project_report/figures/image.png
