parthishere/Insane-Keyboard/project_report/figures/LFXO.png

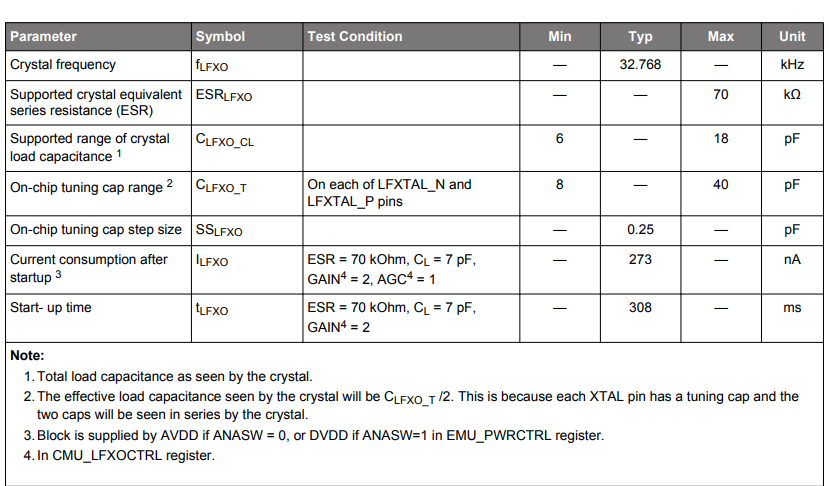
project_report/figures/LFXO.png
