parthishere/Insane-Keyboard/project_report/figures/Update5/Max inductor current.png

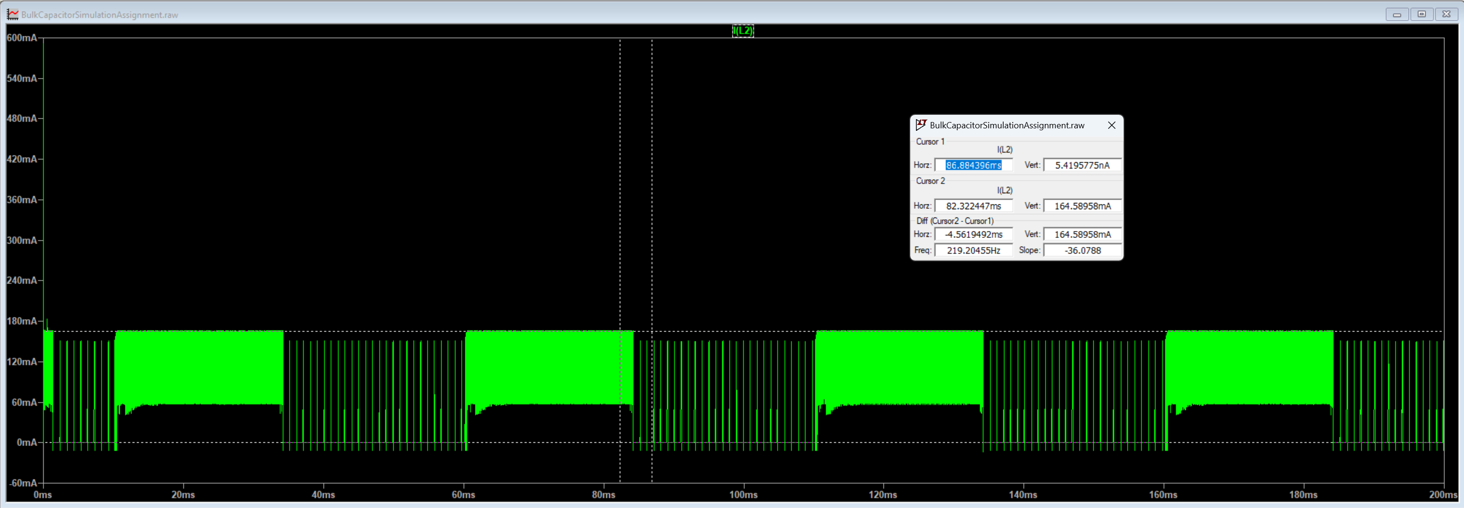
project_report/figures/Update5/Max inductor current.png
