parthishere/Insane-Keyboard/project_report/figures/Update_4/3d3.jpeg

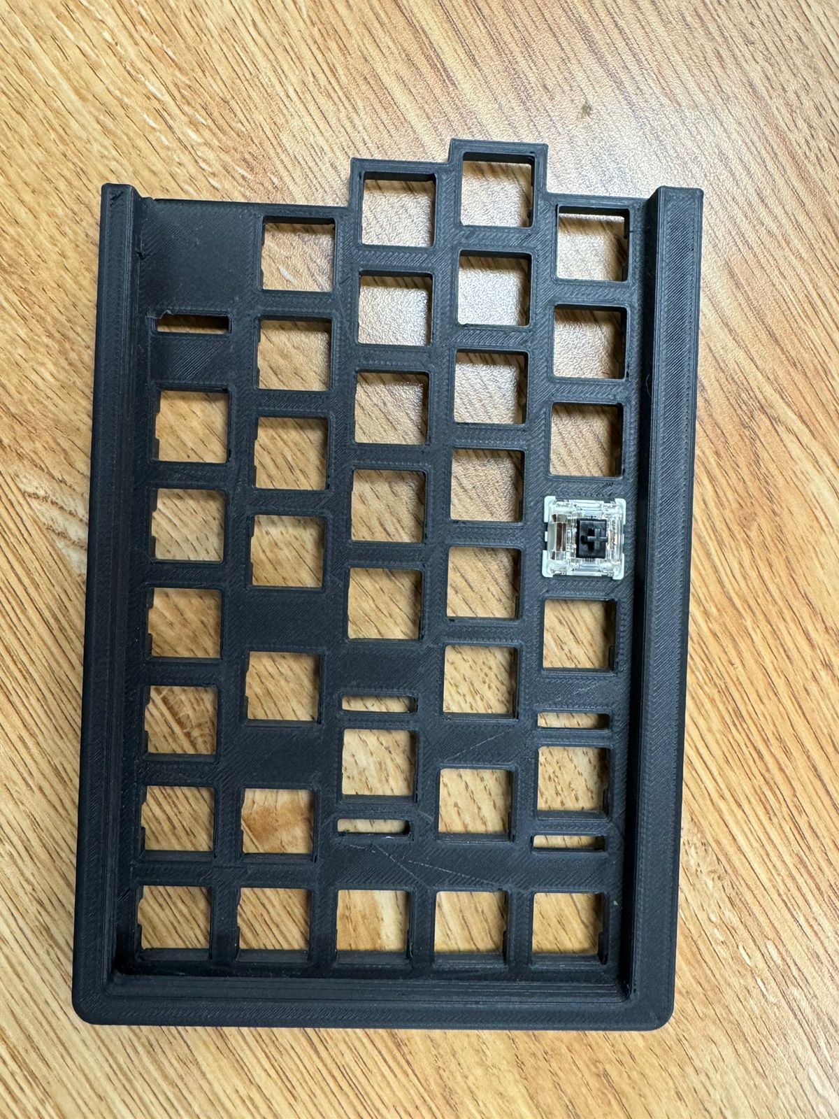
project_report/figures/Update_4/3d3.jpeg
