parthishere/Insane-Keyboard/HardwareDesign/InsaneKeyboard_3D_files/InsaneKeyboard_3D_files/LeftPlate.stl

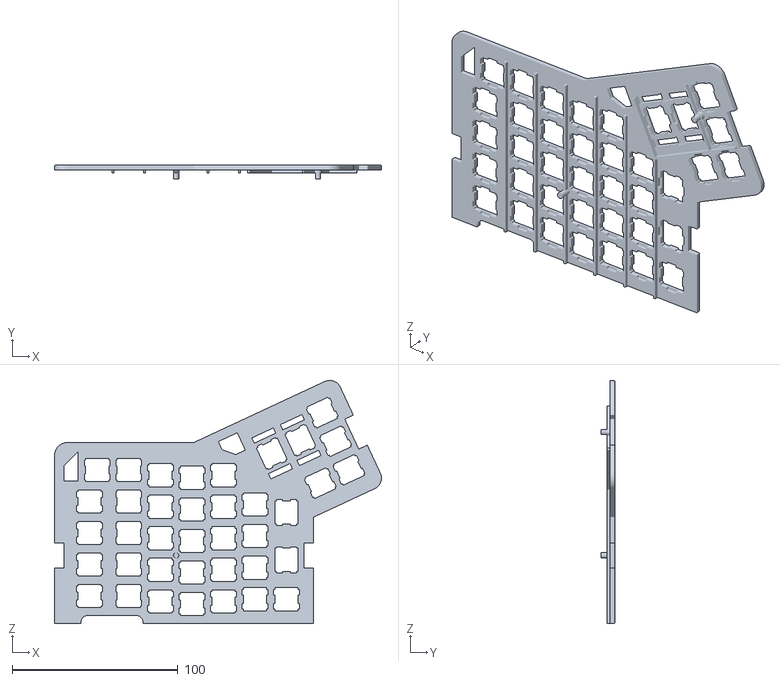
[picture p47: CAD file, 2024-11-20]
HardwareDesign/InsaneKeyboard_3D_files/InsaneKeyboard_3D_files/LeftPlate.stl
197.5 x 8.70 x 146.9
