parthishere/Insane-Keyboard/HardwareDesign/InsaneKeyboard_3D_files/InsaneKeyboard_3D_files/step_file/left_bottom.step

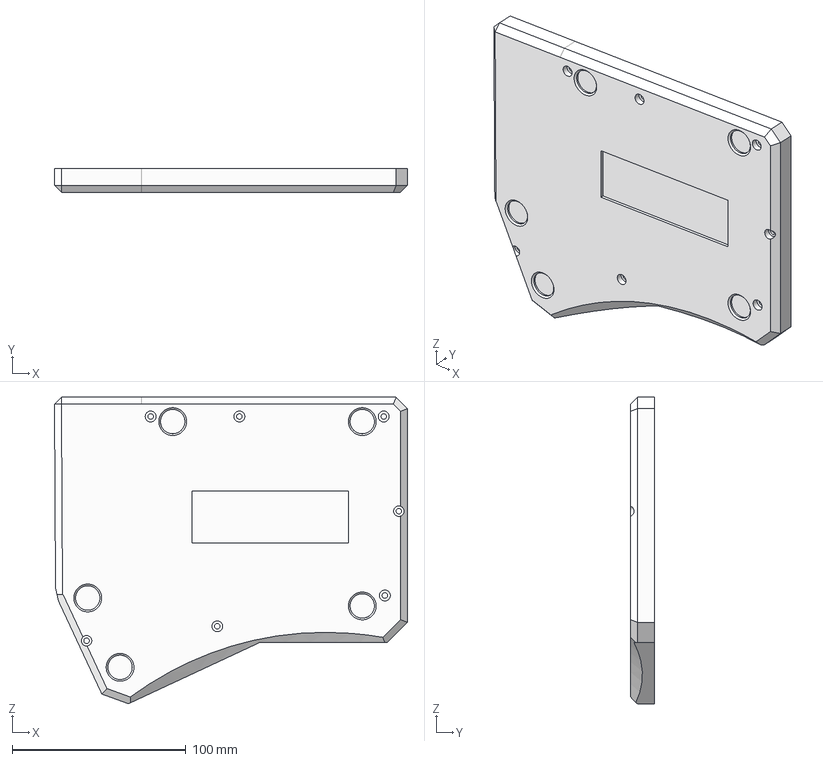
[picture p48: CAD file, 2024-11-20]
HardwareDesign/InsaneKeyboard_3D_files/InsaneKeyboard_3D_files/step_file/left_bottom.step
203.0 x 13.7 x 176.2 mm
