parthishere/Insane-Keyboard/HardwareDesign/InsaneKeyboard_3D_files/InsaneKeyboard_3D_files/PCB.stl

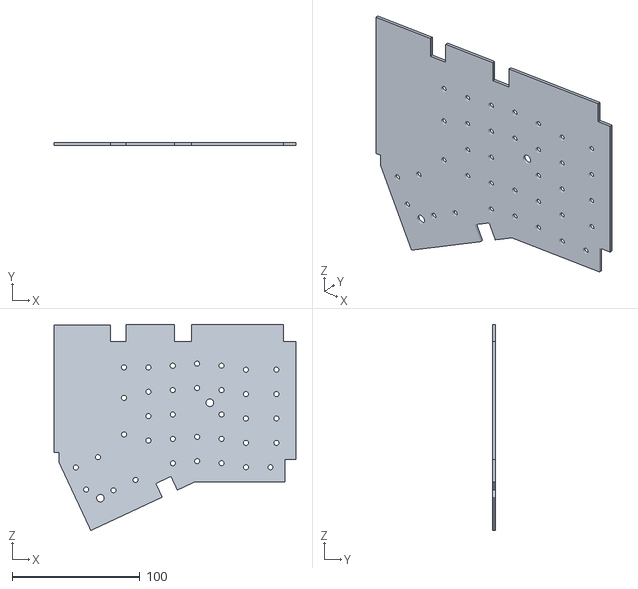
[picture p49: CAD file, 2024-11-20]
HardwareDesign/InsaneKeyboard_3D_files/InsaneKeyboard_3D_files/PCB.stl
189.1 x 2.00 x 161.0
