parthishere/Insane-Keyboard/HardwareDesign/InsaneKeyboard_3D_files/InsaneKeyboard_3D_files/step_file/right_top.step

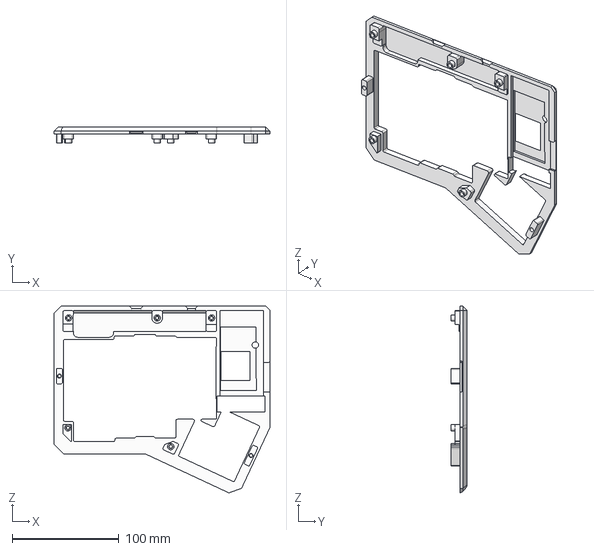
[picture p50: CAD file, 2024-11-20]
HardwareDesign/InsaneKeyboard_3D_files/InsaneKeyboard_3D_files/step_file/right_top.step
202.4 x 15.2 x 175.0 mm
