parthishere/Insane-Keyboard/HardwareDesign/InsaneKeyboard_3D_files/InsaneKeyboard_3D_files/tent.stl

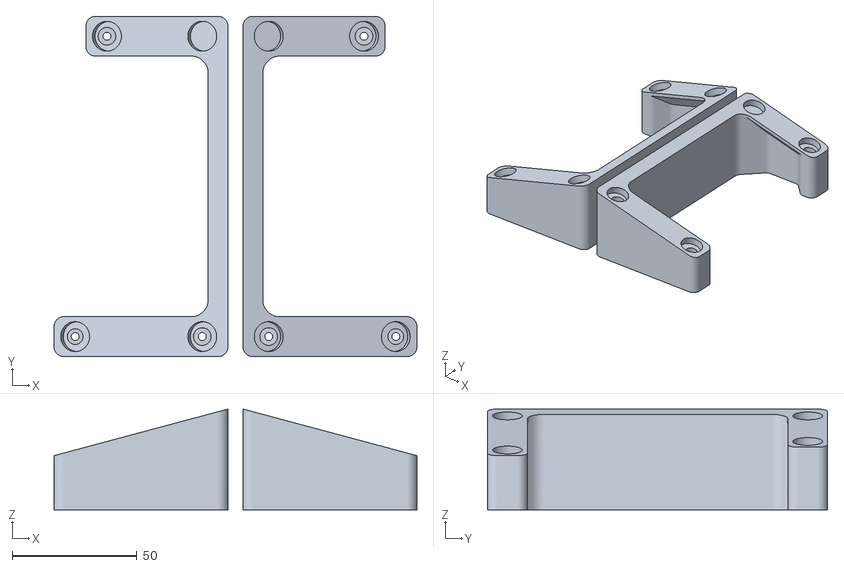
[picture p51: CAD file, 2024-11-20]
HardwareDesign/InsaneKeyboard_3D_files/InsaneKeyboard_3D_files/tent.stl
145.7 x 136.6 x 40.5
