parthishere/Insane-Keyboard/(list of files, cad)

Other CAD files:
HardwareDesign/InsaneKeyboard_3D_files/InsaneKeyboard_3D_files/step_file/right_bottom.step
HardwareDesign/InsaneKeyboard_3D_files/InsaneKeyboard_3D_files/RightPlate.stl
HardwareDesign/InsaneKeyboard_3D_files/InsaneKeyboard_3D_files/step_file/left_top.step
HardwareDesign/InsaneKeyboard_3D_files/InsaneKeyboard_3D_files/left_bottom.stl
HardwareDesign/InsaneKeyboard_3D_files/InsaneKeyboard_3D_files/left_top.stl
HardwareDesign/InsaneKeyboard_3D_files/InsaneKeyboard_3D_files/right_bottom.stl
HardwareDesign/InsaneKeyboard_3D_files/InsaneKeyboard_3D_files/right_top.stl
