parthishere/Insane-Keyboard/HardwareDesign/PCB/InsaneKeyboard (Copy)/InsaneKeyboard.pdf

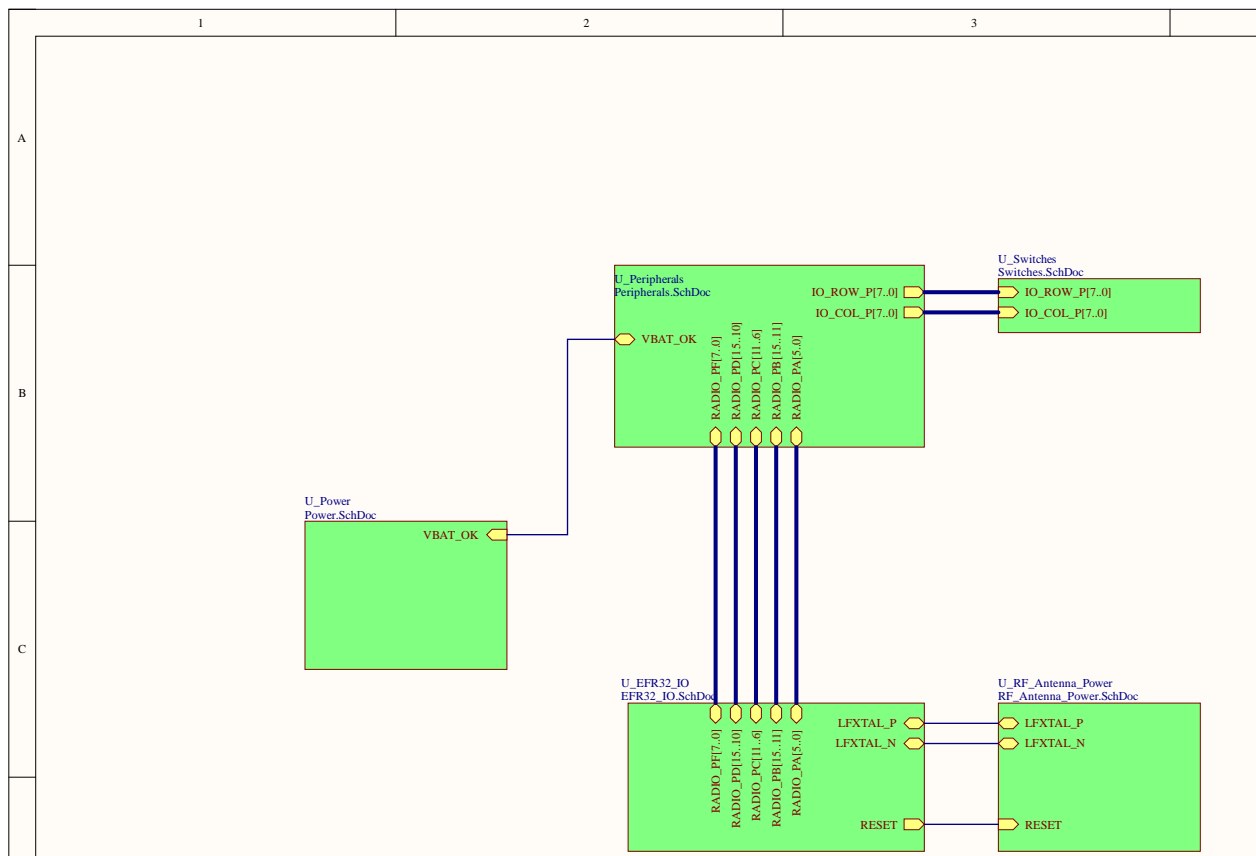
[picture p53: page 1]

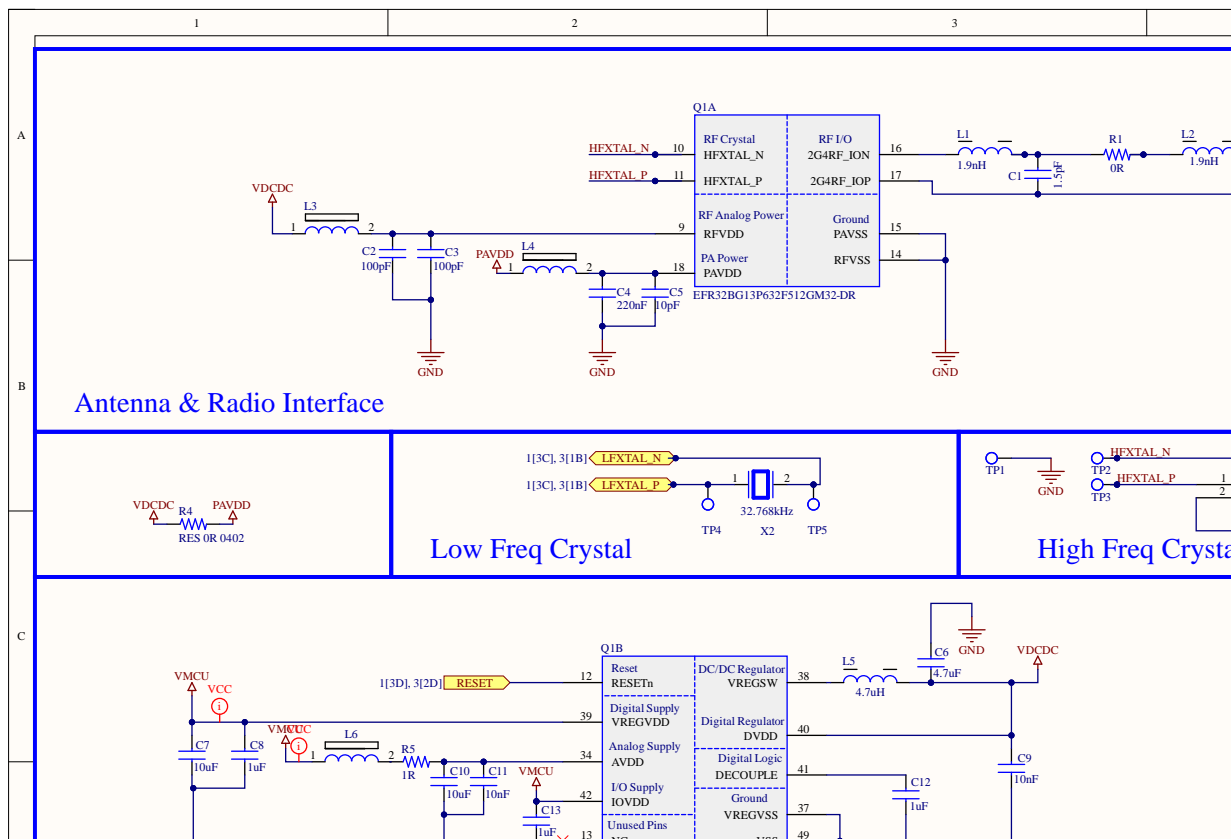
[picture p54: page 2]

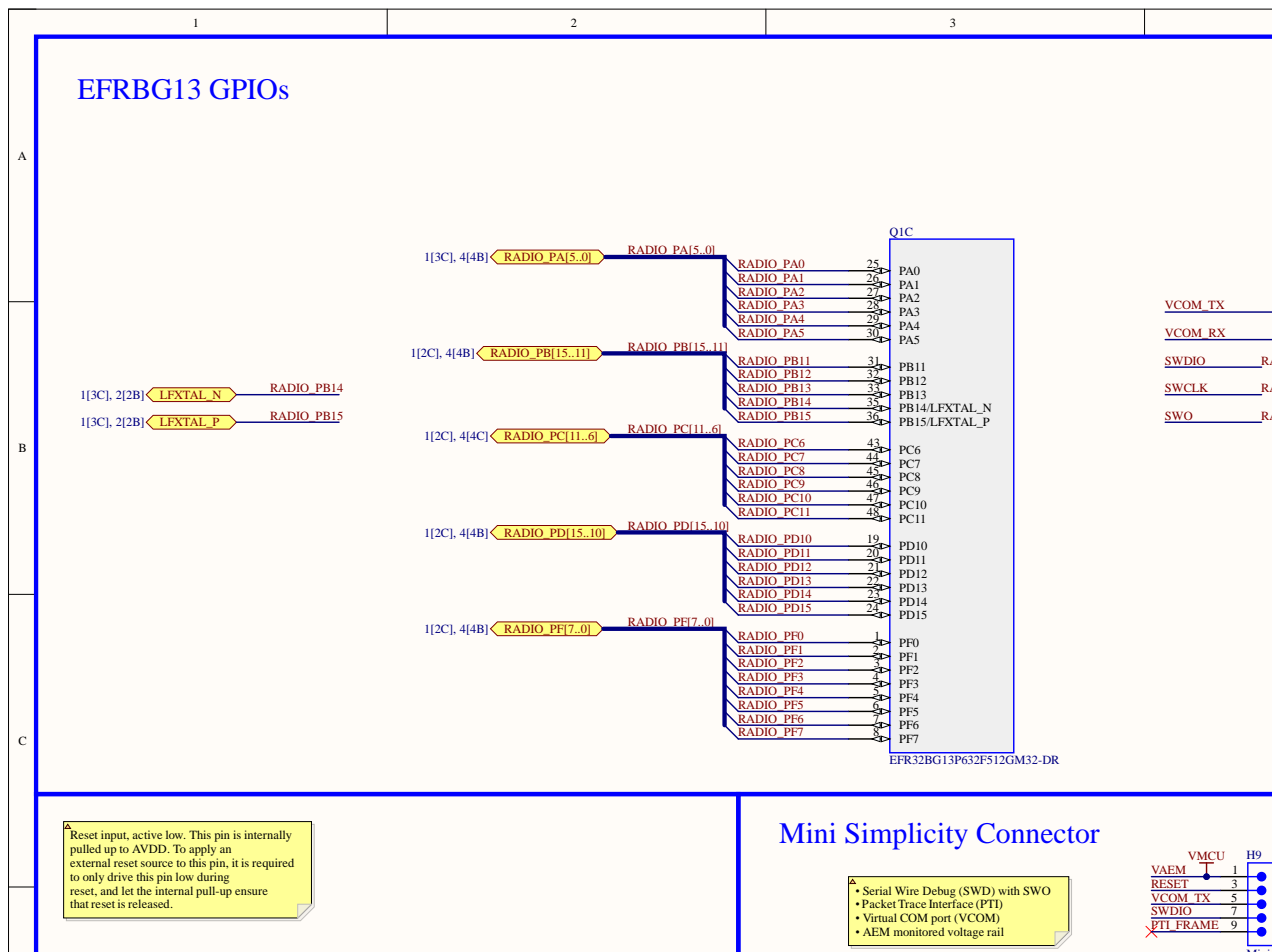
[picture p55: page 3]

Reset input, active low. This pin is internally
pulled up to AVDD. To apply an
external reset source to this pin, it is required
to only drive this pin low during
reset, and let the internal pull-up ensure
that reset is released.

• Serial Wire Debug (SWD) with SWO
• Packet Trace Interface (PTI)
• Virtual COM port (VCOM)
• AEM monitored voltage rail

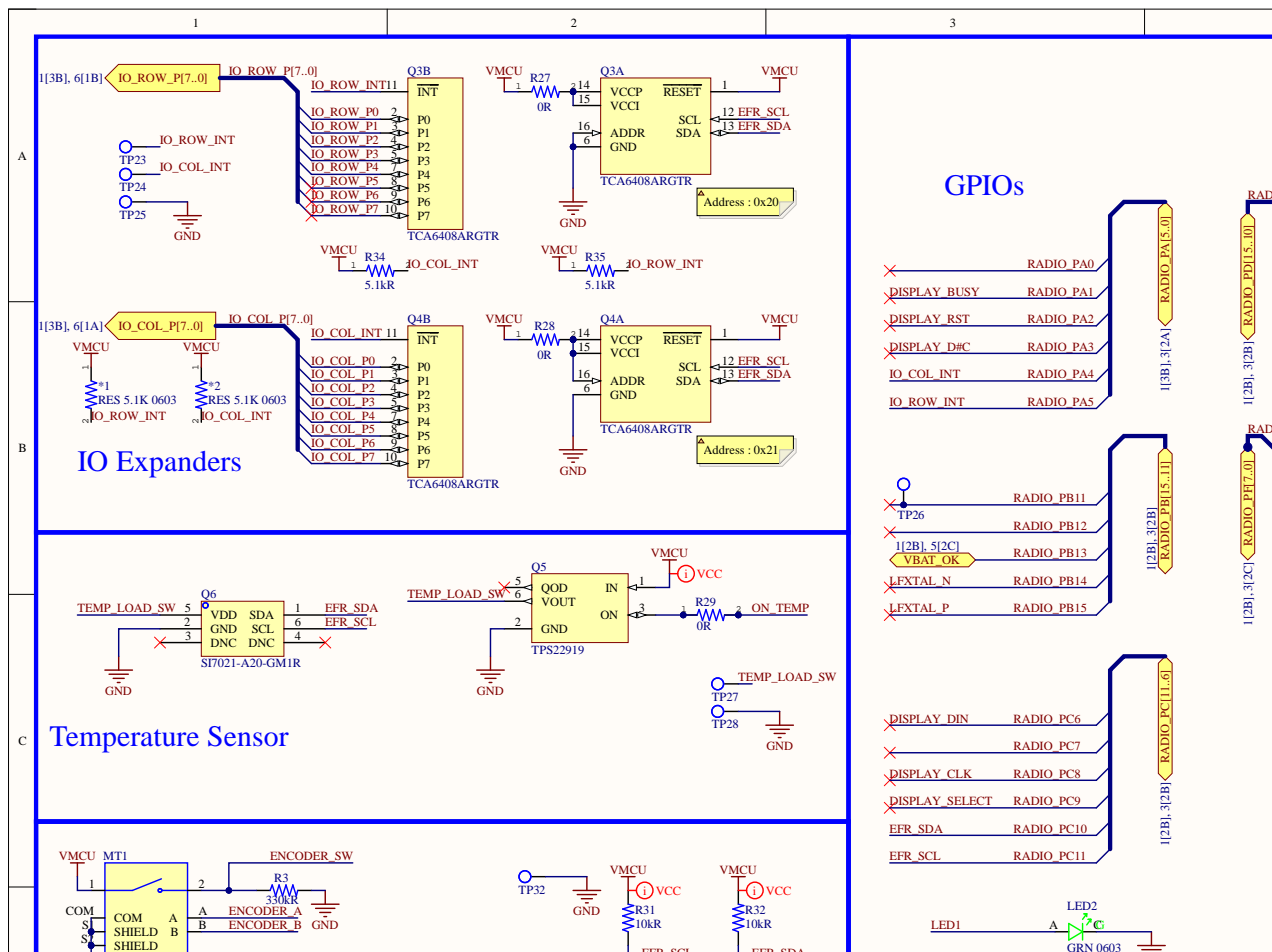
[picture p56: page 4]

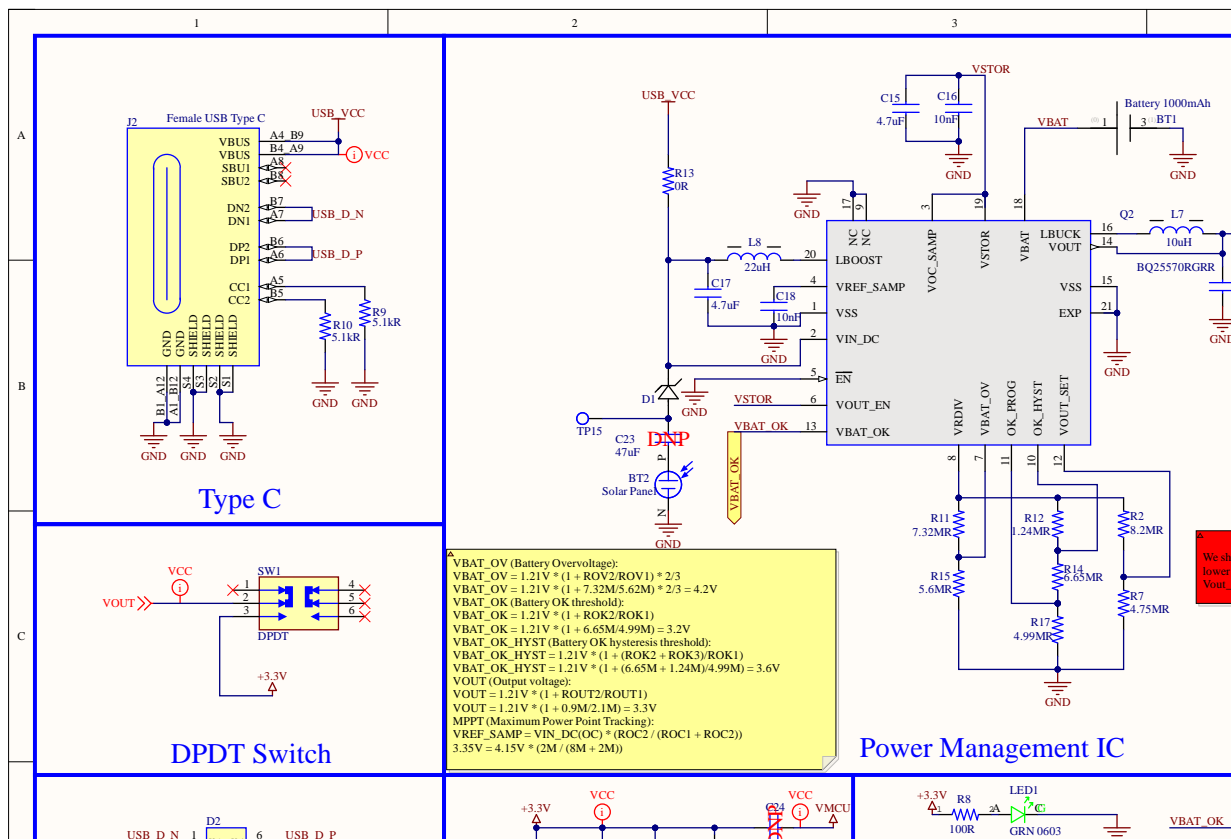
[picture p57: page 5]

SHIELD S1 SHIELD S2 SHIELD S3 SHIELD S4 GND A1_B12 GND B1_A12

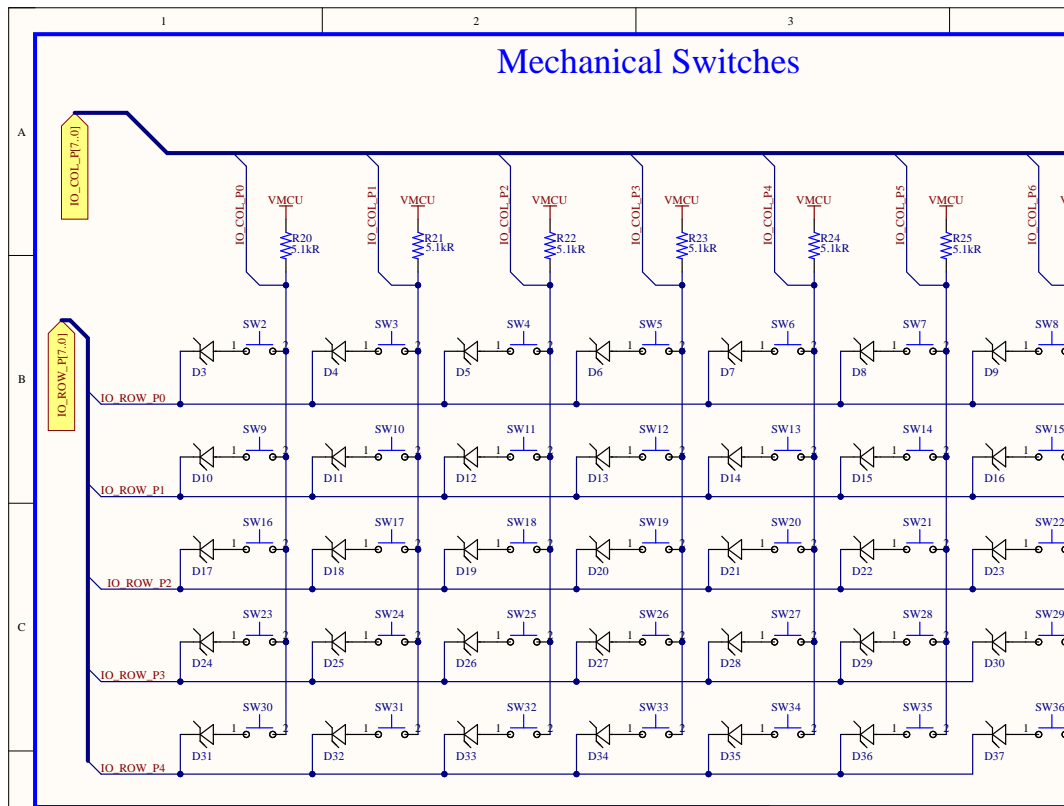
[picture p58: page 6]

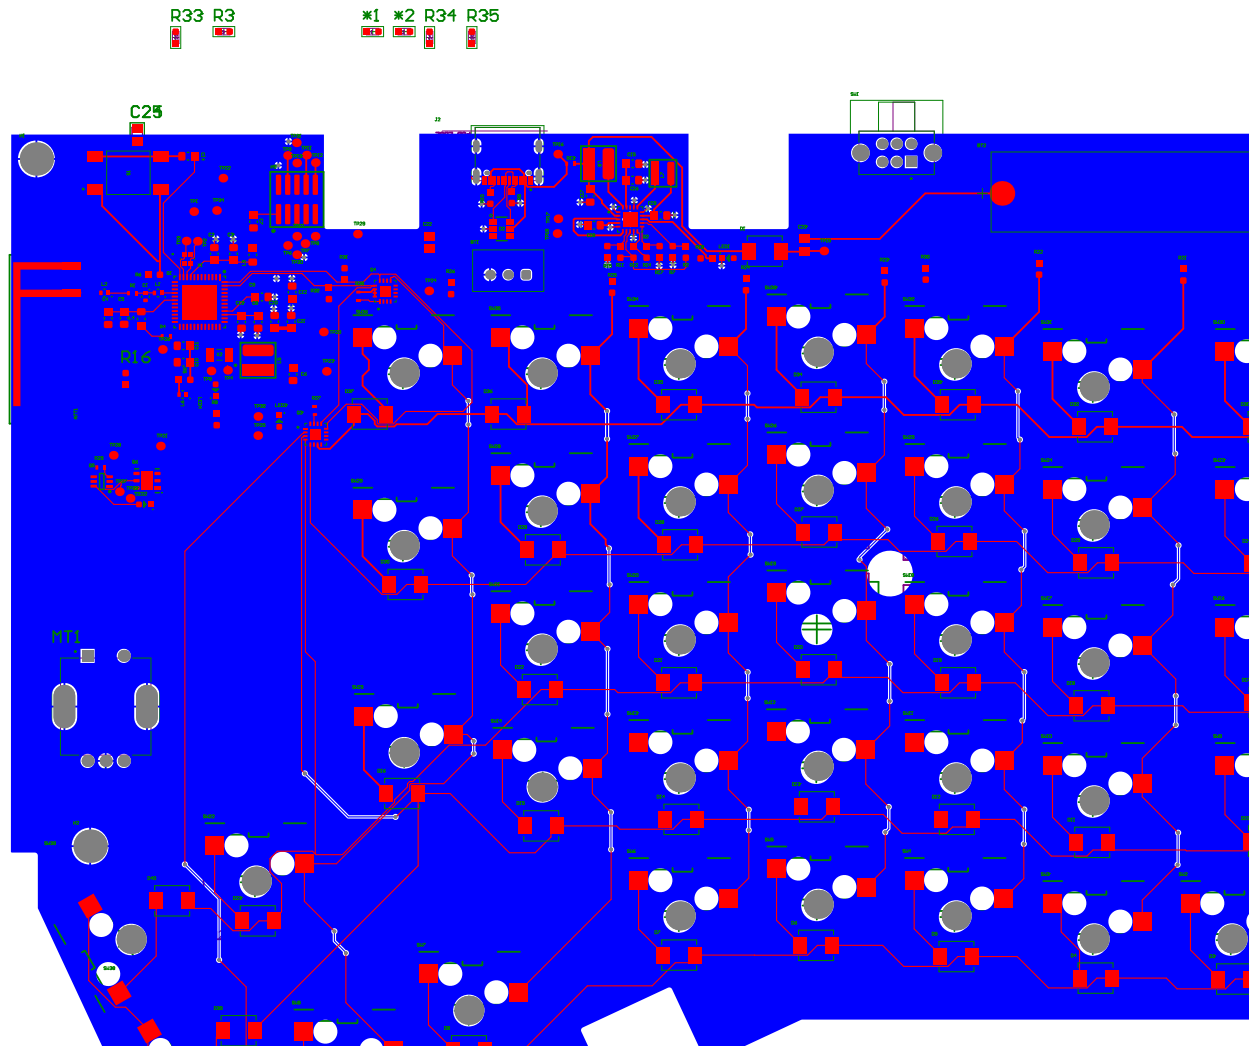
[picture p59: page 7]

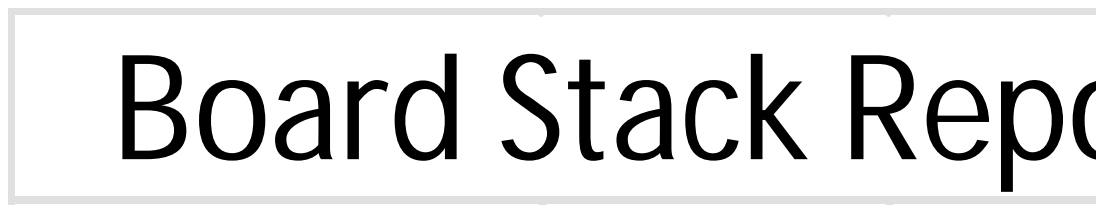
[picture p60: page 8]
