parthishere/Insane-Keyboard/HardwareDesign/PCB/InsaneKeyboard (Copy)/Project Outputs for InsaneKeyboard/Keyboard.PDF

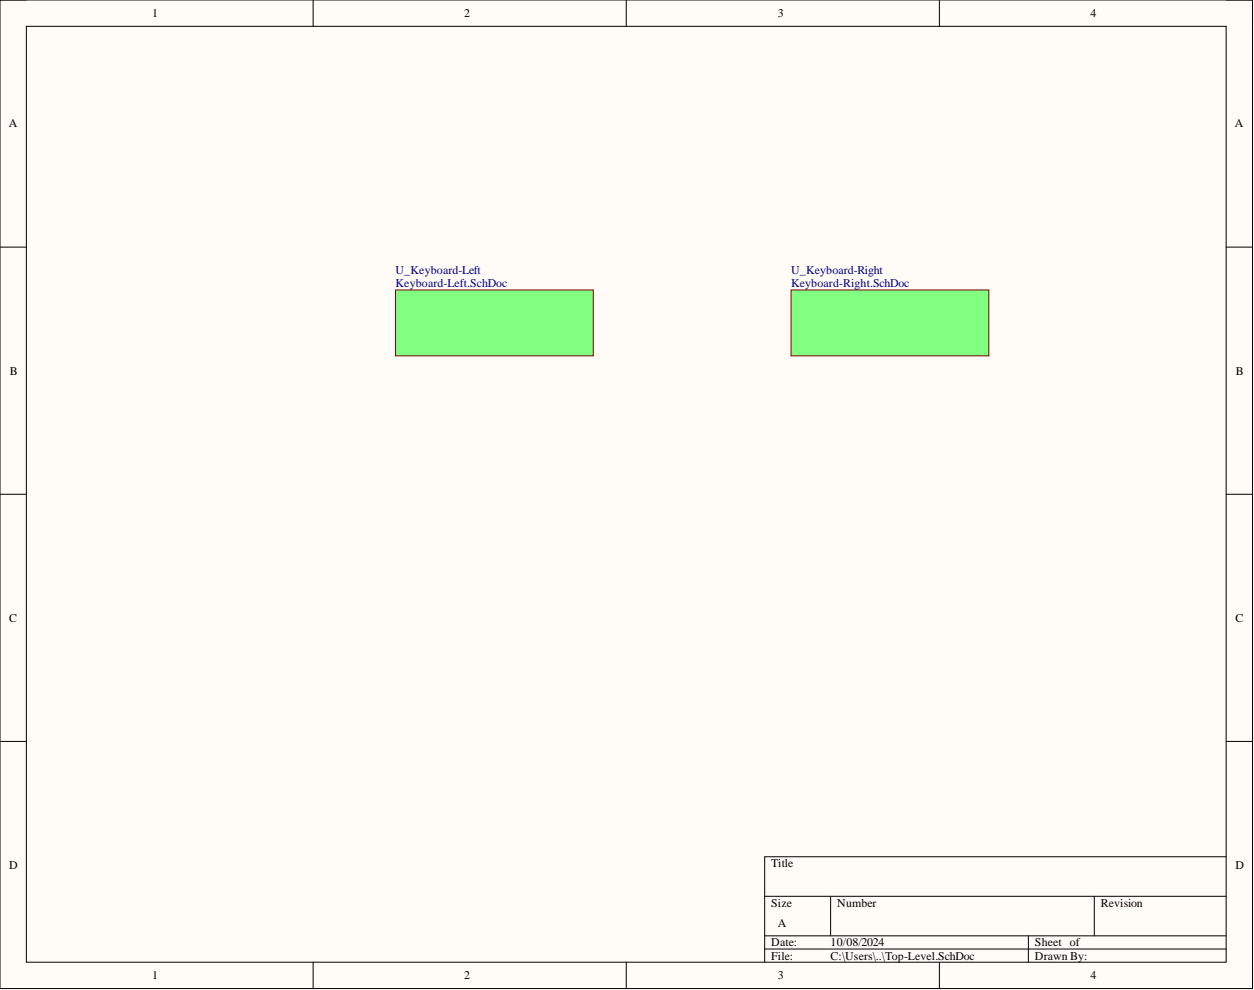
[picture p61: page 1]

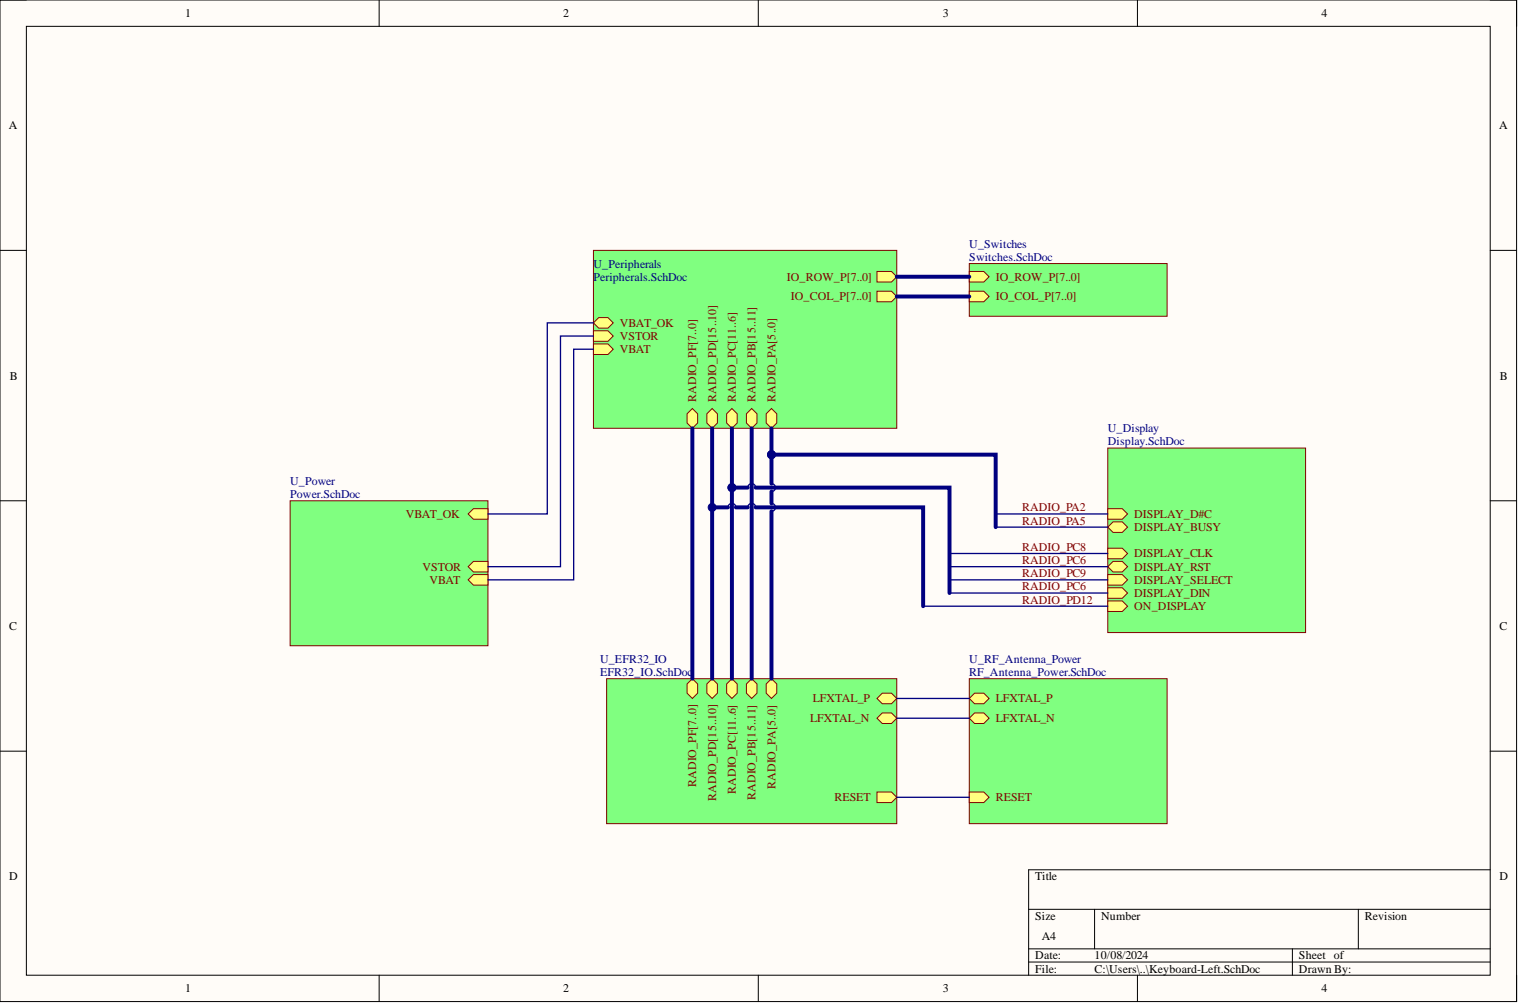
[picture p62: page 2]

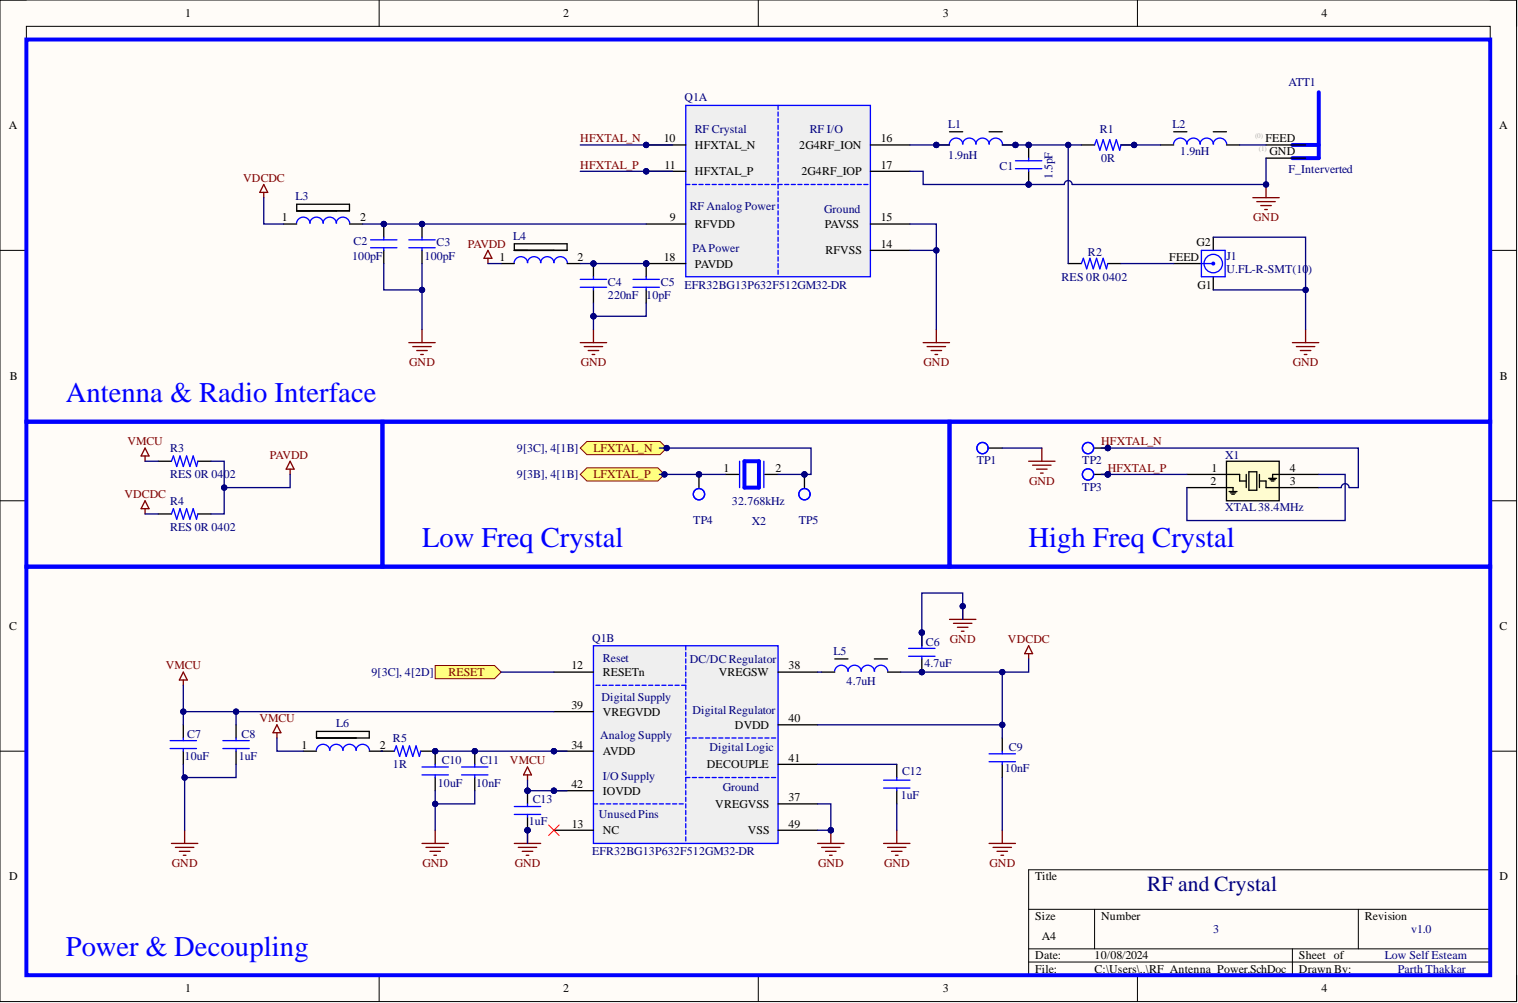
[picture p63: page 3]

Size A4 | Number 3 | Revision v1.0

Low Self Esteam

File: C:\Users\..\RF_Antenna_Power.SchDoc | Drawn By: Parth Thakkar

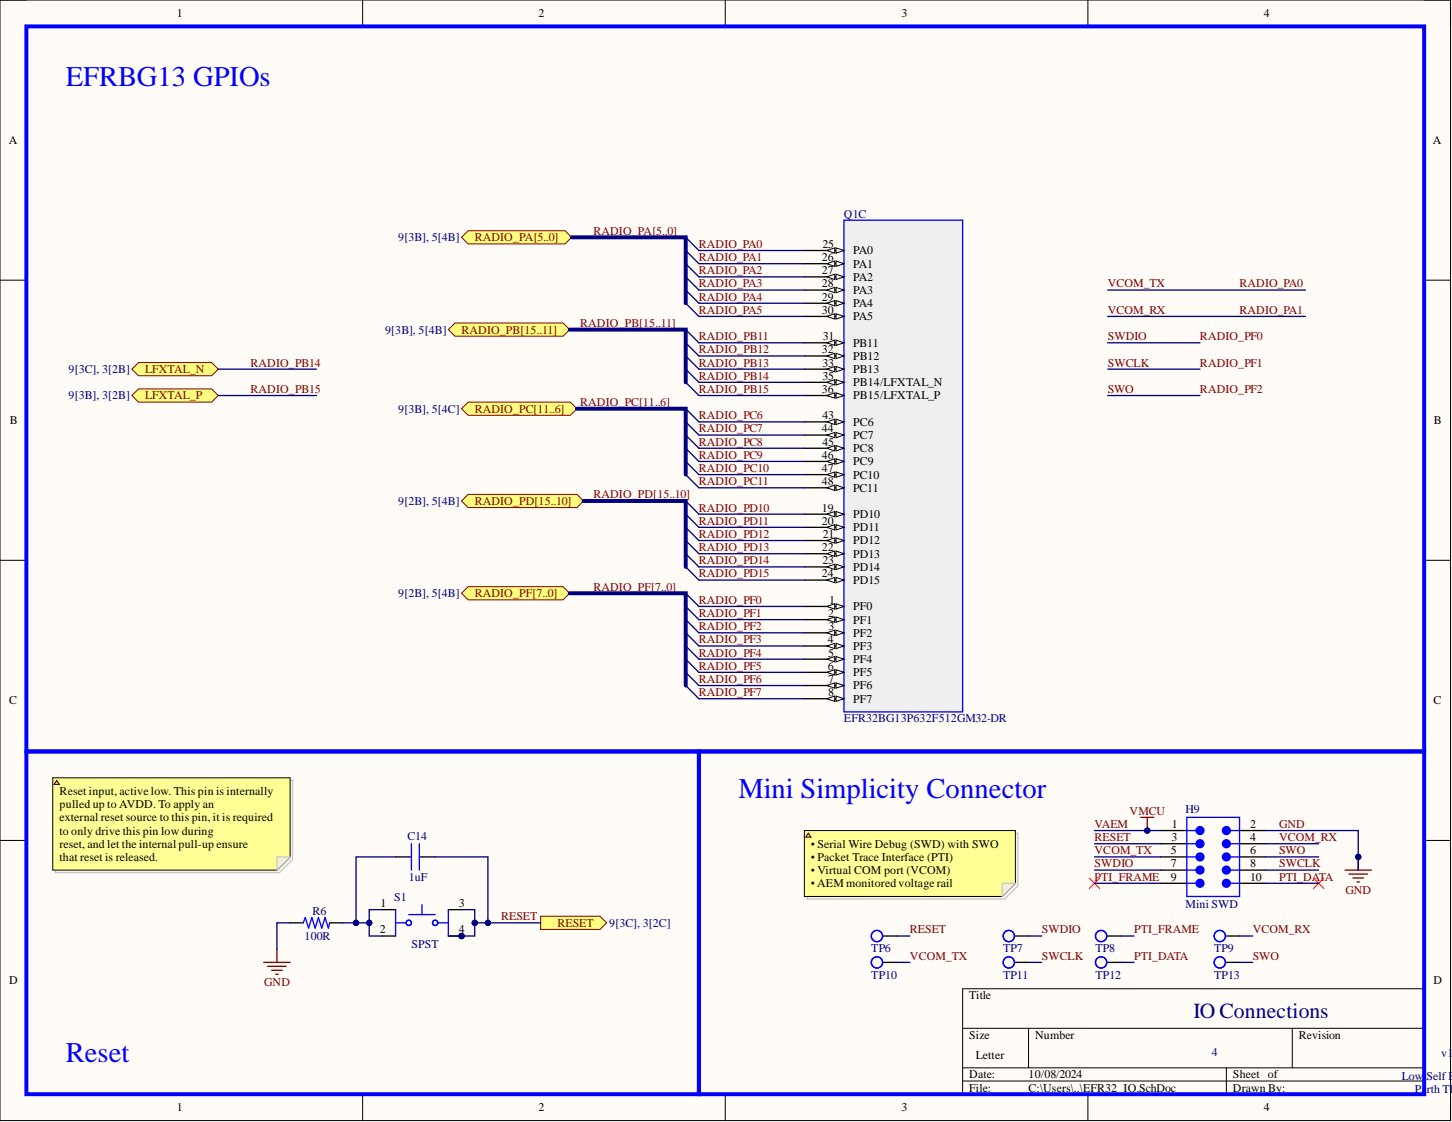
[picture p64: page 4]

Reset input, active low. This pin is internally
pulled up to AVDD. To apply an
external reset source to this pin, it is required
to only drive this pin low during
reset, and let the internal pull-up ensure
that reset is released.

• Serial Wire Debug (SWD) with SWO
• Packet Trace Interface (PTI)
• Virtual COM port (VCOM)
• AEM monitored voltage rail

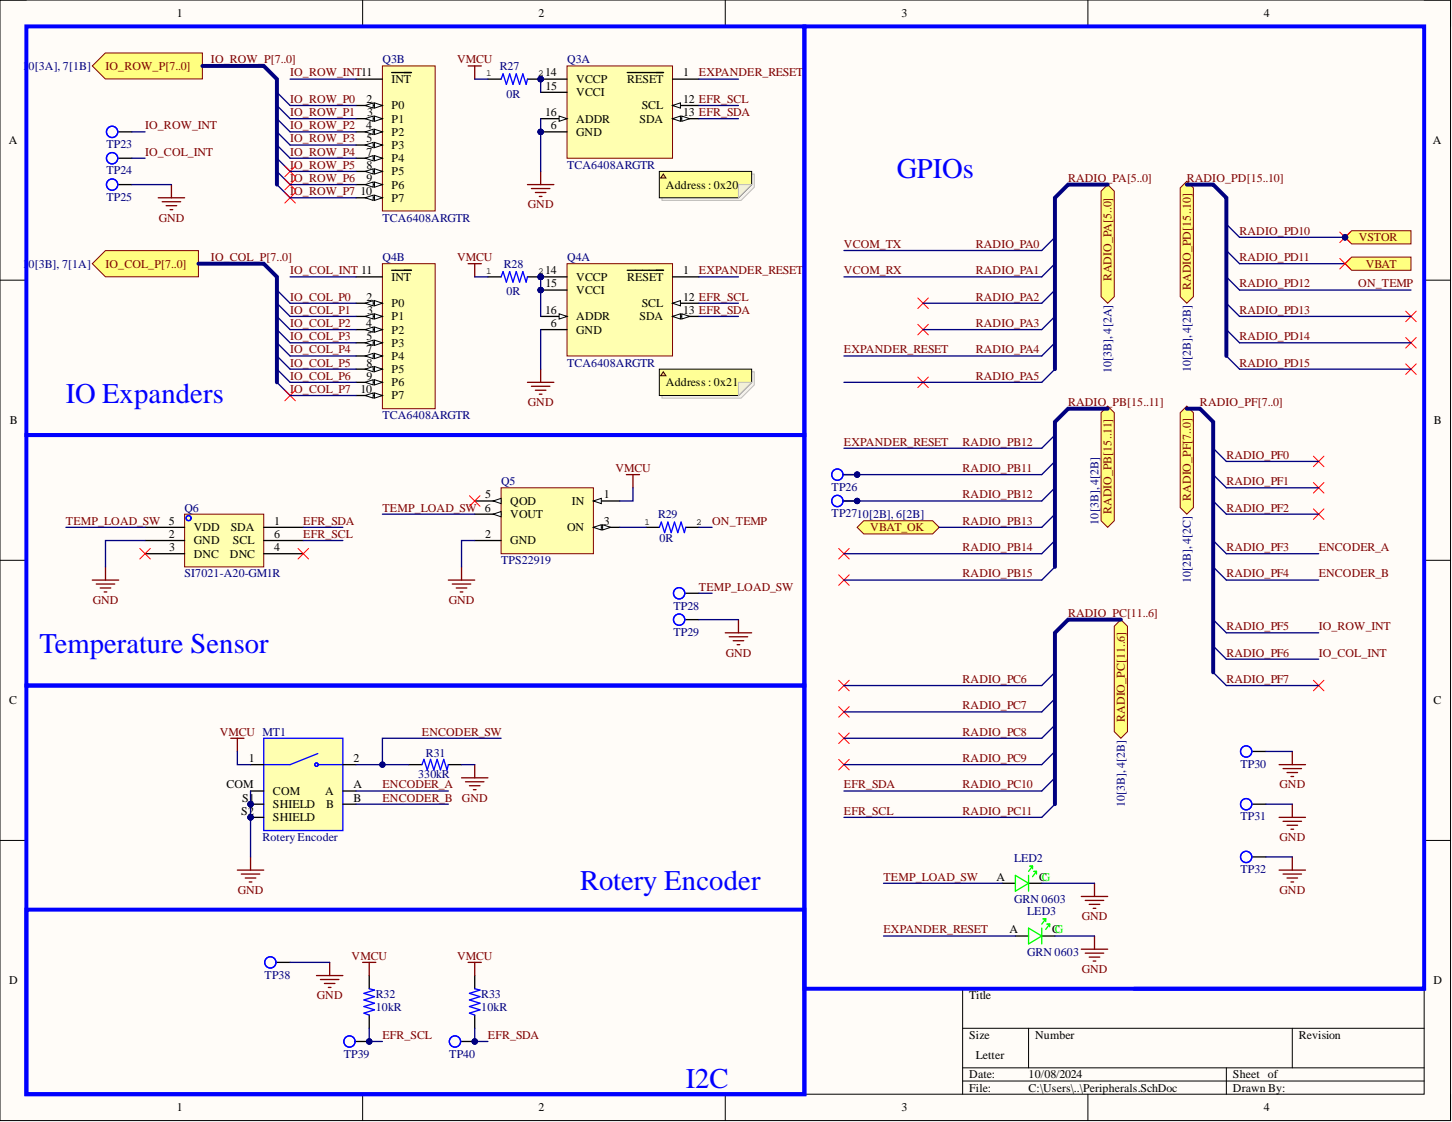
[picture p65: page 5]

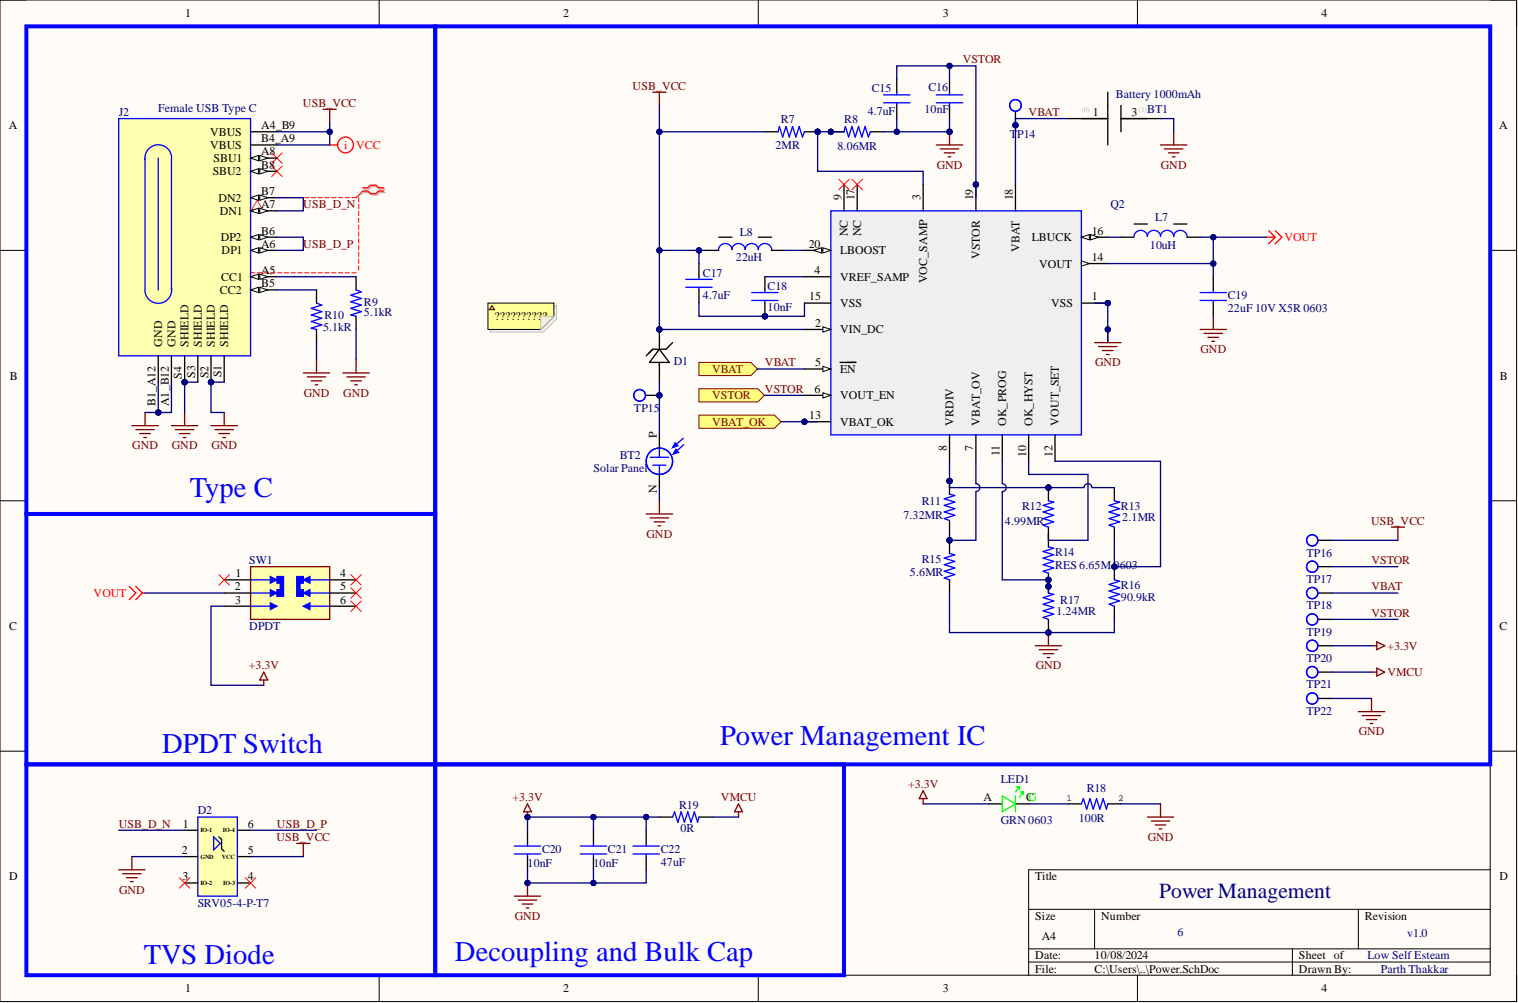
[picture p66: page 6]

SHIELD S1 SHIELD S2 SHIELD S3 SHIELD S4 GND A1_B12 GND B1_A12

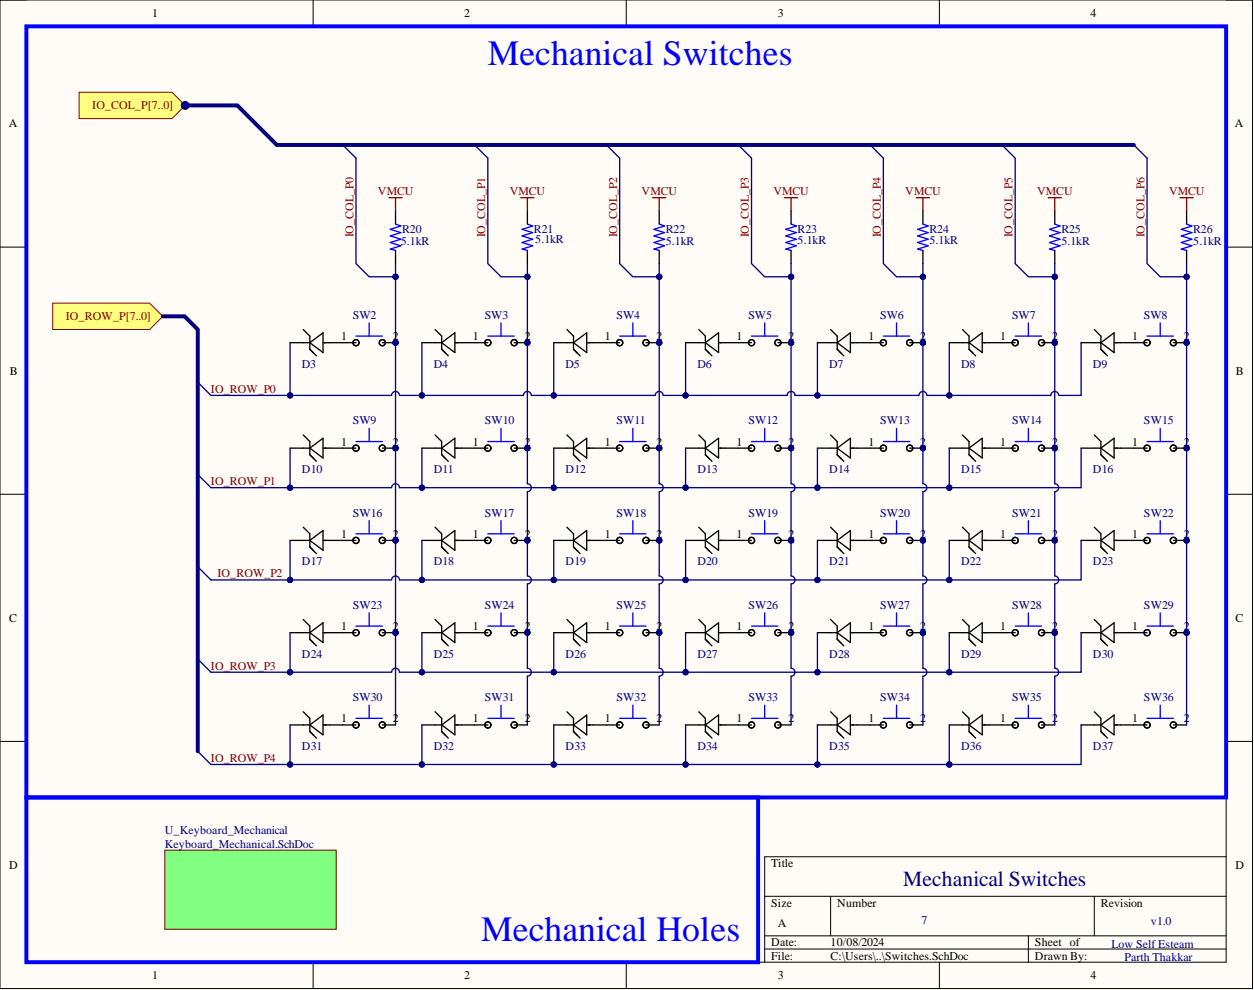
[picture p67: page 7]

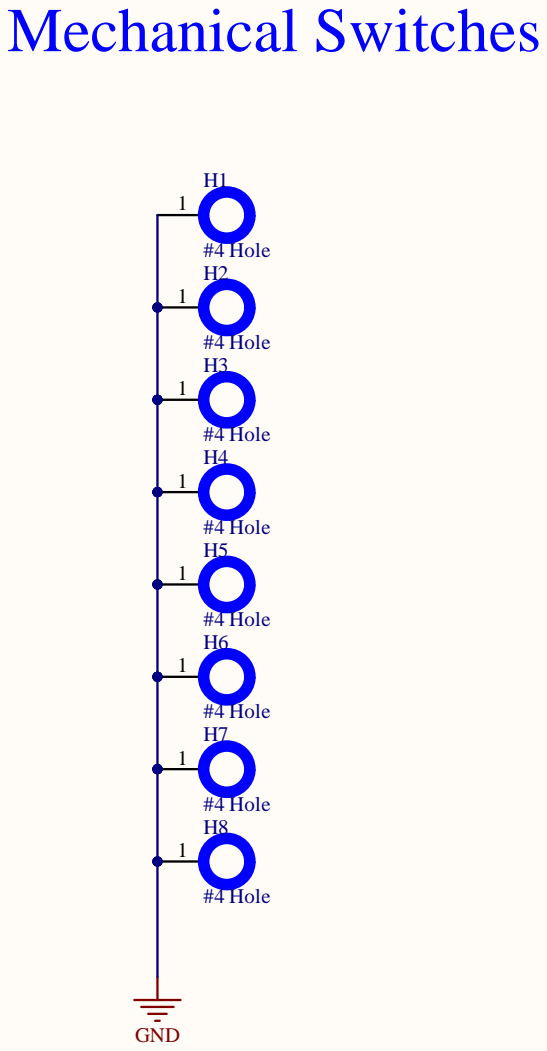
[picture p68: page 8]

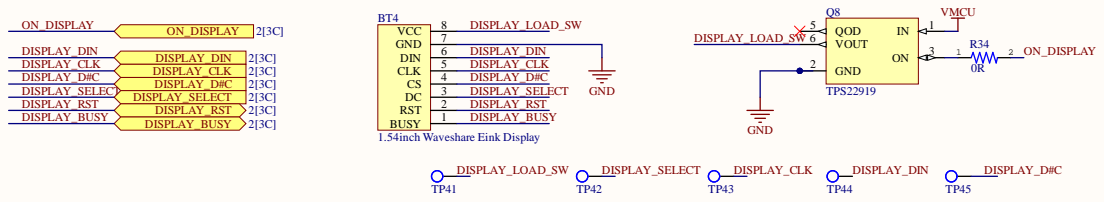
[picture p69: page 9]

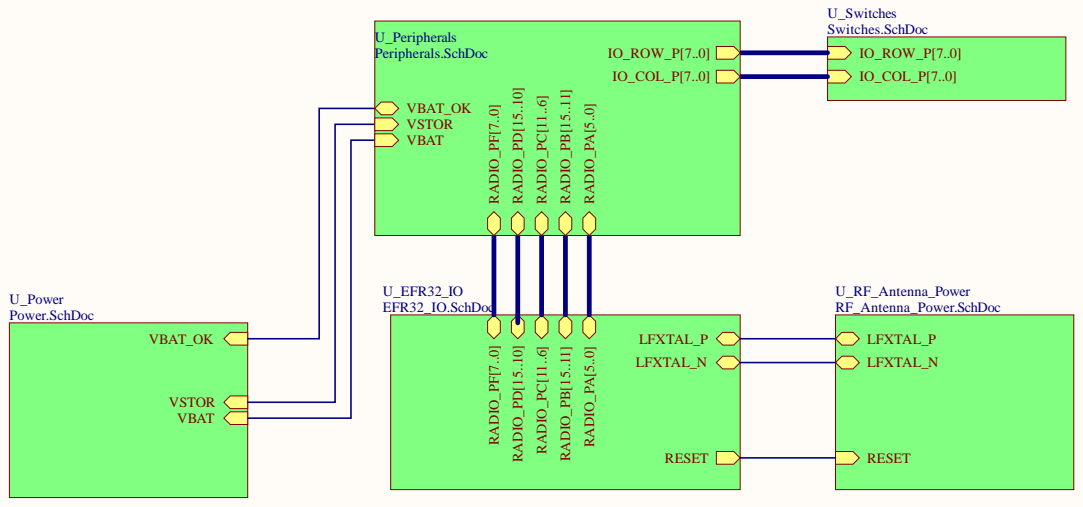
[picture p70: page 10]

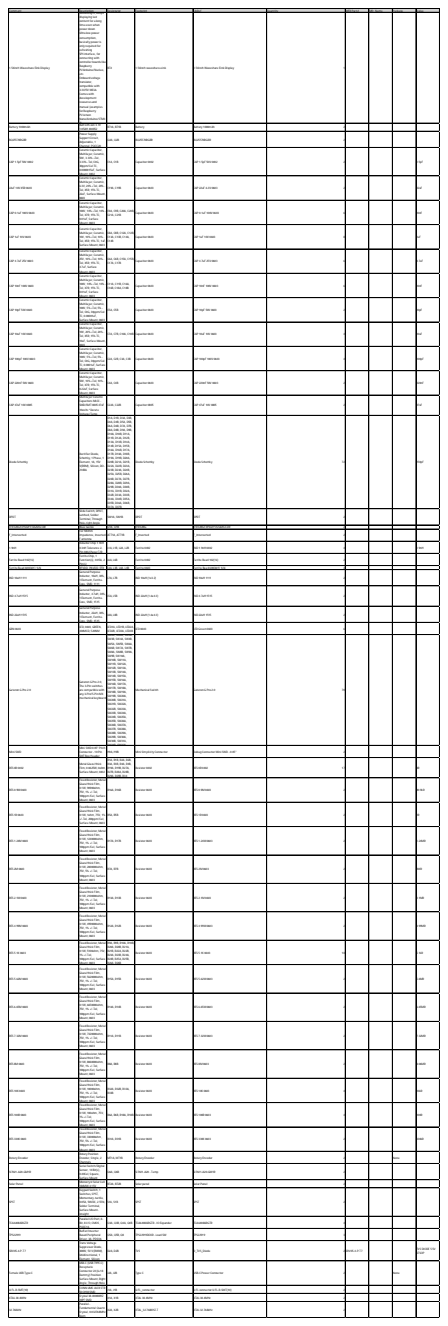
[picture p71: page 11]

Battery 1000mAh | Batt Lith-ion 3.7V 1.05AH 404852 | BT1A, BT1B | Battery | Battery 1000mAh | 2

BQ25570RGRR | Power Supply Support Circuit, Adjustable, 1 Channel, PQCC20 | Q2A, Q2B | BQ25570RGRR | BQ25570RGRR | 2

CAP 1.5pF 50V 0402 | Ceramic Capacitor, Multilayer, Ceramic, 50V, 3.33% +Tol, 3.33% -Tol, C0G, 30ppm/Cel TC, 0.0000015uF, Surface Mount, 0402 | C1A, C1B | Capacitor 0402 | CAP 1.5pF 50V 0402 | 2 | 1.5pF

22uF 10V X5R 0603 | Ceramic Capacitor, Multilayer, Ceramic, 6.3V, 20% +Tol, 20% -Tol, X5R, 15% TC, 22uF, Surface Mount, 0603 | C19A, C19B | Capacitor 0603 | CAP 22uF 6.3V 0603 | 2 | 22uF

CAP 0.1uF 100V 0603 | Ceramic Capacitor, Multilayer, Ceramic, 100V, 10% +Tol, 10% -Tol, X7R, 15% TC, 0.01uF, Surface Mount, 0603 | C9A, C9B, C20A, C20B, C21A, C21B | Capacitor 0603 | CAP 0.1uF 100V 0603 | 6 | 10nF

CAP 1uF 10V 0603 | Ceramic Capacitor, Multilayer, Ceramic, 10V, 10% +Tol, 10% -Tol, X5R, 15% TC, 1uF, Surface Mount, 0603 | C8A, C8B, C12A, C12B, C13A, C13B, C14A, C14B | Capacitor 0603 | CAP 1uF 10V 0603 | 8 | 1uF

CAP 4.7uF 25V 0603 | Ceramic Capacitor, Multilayer, Ceramic, 25V, 10% +Tol, 10% -Tol, X5R, 15% TC, 4.7uF, Surface Mount, 0603 | C6A, C6B, C15A, C15B, C17A, C17B | Capacitor 0603 | CAP 4.7uF 25V 0603 | 6 | 4.7uF

CAP 10nF 100V 0603 | Ceramic Capacitor, Multilayer, Ceramic, 100V, 10% +Tol, 10% -Tol, X7R, 15% TC, 0.01uF, Surface Mount, 0603 | C11A, C11B, C16A, C16B, C18A, C18B | Capacitor 0603 | CAP 10nF 100V 0603 | 6 | 10nF

CAP 10pF 50V 0603 | Ceramic Capacitor, Multilayer, Ceramic, 100V, 5% +Tol, 5% -Tol, C0G, 30ppm/Cel TC, 0.00001uF, Surface Mount, 0603 | C5A, C5B | Capacitor 0603 | CAP 10pF 50V 0603 | 2 | 10pF

CAP 10uF 10V 0603 | Ceramic Capacitor, Multilayer, Ceramic, 10V, 20% +Tol, 20% -Tol, X5R, 15% TC, 10uF, Surface Mount, 0603 | C7A, C7B, C10A, C10B | Capacitor 0603 | CAP 10uF 10V 0603 | 4 | 10uF

CAP 100pF 100V 0603 | Ceramic Capacitor, Multilayer, Ceramic, 100V, 5% +Tol, 5% -Tol, C0G, 30ppm/Cel TC, 0.0001uF, Surface Mount, 0603 | C2A, C2B, C3A, C3B | Capacitor 0603 | CAP 100pF 100V 0603 | 4 | 100pF

CAP 220nF 50V 0603 | Ceramic Capacitor, Multilayer, Ceramic, 50V, 10% +Tol, 10% -Tol, X7R, 15% TC, 0.22uF, Surface Mount, 0603 | C4A, C4B | Capacitor 0603 | CAP 220nF 50V 0603 | 2 | 220nF

CAP 47uF 10V 0805 | Multilayer Ceramic Capacitors MLCC -SMD/SMT 0805 47uF 10volts *Derate Voltage/Temp | C22A, C22B | Capacitor 0805 | CAP 47uF 10V 0805 | 2 | 47uF

Diode Schottky | Rectifier Diode, Schottky, 1 Phase, 1 Element, 1A, 15V V(RRM), Silicon, DO-214BA | D1A, D1B, D3A, D3B, D4A, D4B, D5A, D5B, D6A, D6B, D7A, D7B, D8A, D8B, D9A, D9B, D10A, D10B, D11A, D11B, D12A, D12B, D13A, D13B, D14A, D14B, D15A, D15B, D16A, D16B, D17A, D17B, D18A, D18B, D19A, D19B, D20A, D20B, D21A, D21B, D22A, D22B, D23A, D23B, D24A, D24B, D25A, D25B, D26A, D26B, D27A, D27B, D28A, D28B, D29A, D29B, D30A, D30B, D31A, D31B, D32A, D32B, D33A, D33B, D34A, D34B, D35A, D35B, D36A, D36B, D37A, D37B | Diode Schottky | Diode Schottky | 72 | 150pF

DPDT | Slide Switch, DPDT, Latched, Solder Terminal, Through Hole-right Angle | SW1A, SW1B | DPDT | DPDT | 2

EFR32BG13P632F512GM32-DR F_Interverted | For 50Ohm BLue Gecko impedence, Inverted F antenna | Q1A, Q1B ATT1A, ATT1B | EFR32BG F_Inverted | EFR32BG13P632F512GM32-DR F_Interverted | 2 2

1.9nH | Inductor Chip 1.9nH 0.3nH Tolerance 2-Pin 0402 Paper T/R | L1A, L1B, L2A, L2B | Ferrite 0402 | IND 1.9nH 0402 | 4 | 1.9nH

Farrite Bead 102(1k) | Ferrite Chip, 1 Function(s), 0.05A, 2 Pin(s) | L6A, L6B | Ferrite 0402 | Farrite Bead 102(1k) | 2

Ferrite Bead 600(601) 1LN IND 10uH 1111 | RFVDD, PAVDD, EFR General Purpose Inductor, 10uH, 30%, 1 Element, Ferrite-Core, SMD, 1111 | L3A, L3B, L4A, L4B L7A, L7B | Ferrite 0603 IND 10uH (1x3.2) | Ferrite Bead 600(601) 1LN IND 10uH 1111 | 4 2

IND 4.7uH 1515 | General Purpose Inductor, 4.7uH, 30%, 1 Element, Ferrite-Core, SMD, 1515 | L5A, L5B | IND 22uH (1.6x4.3) | IND 4.7uH 1515 | 2

IND 22uH 1515 | General Purpose Inductor, 22uH, 30%, 1 Element, Ferrite-Core, SMD, 1515 | L8A, L8B | IND 22uH (1.6x4.3) | IND 22uH 1515 | 2

GRN 0603 | LED, 0603, GREEN, 430MCD, 520NM | LED1A, LED1B, LED2A, LED2B, LED3A, LED3B | LED 0603 | LED Green 0603 | 6

Gateron G Pro 2.0 | Gateron G Pro 2.0, The 3-Pin switches are compatible with any 3-Pin/5-Pin MX mechanical keyboard | SW2A, SW2B, SW3A, SW3B, SW4A, SW4B, SW5A, SW5B, SW6A, SW6B, SW7A, SW7B, SW8A, SW8B, SW9A, SW9B, SW10A, SW10B, SW11A, SW11B, SW12A, SW12B, SW13A, SW13B, SW14A, SW14B, SW15A, SW15B, SW16A, SW16B, SW17A, SW17B, SW18A, SW18B, SW19A, SW19B, SW20A, SW20B, SW21A, SW21B, SW22A, SW22B, SW23A, SW23B, SW24A, SW24B, SW25A, SW25B, SW26A, SW26B, SW27A, SW27B, SW28A, SW28B, SW29A, SW29B, SW30A, SW30B, SW31A, SW31B, SW32A, | Mechanical Switch | Gateron G Pro 2.0 | 70

Mini SWD | Mini SWD 0.05" Pitch Connector - 10 Pin SMT Box Header | H9A, H9B | Mini Simplicity Connector | Debug Connector Mini SWD - 0.05" | 2

RES 0R 0402 | Metal Glaze/thick Film, 0.0625W, 0ohm, Surface Mount, 0402 | R1A, R1B, R2A, R2B, R3A, R3B, R4A, R4B, R19A, R19B, R27A, R27B, R28A, R28B, R29A, R29B, R34 | Resistor 0402 | RES 0R 0402 | 17 | | 0R

RES 0.9M 0603 | Fixed Resistor, Metal Glaze/thick Film, 0.1W, 90900ohm, 75V, 1% +/-Tol, 100ppm/Cel, Surface Mount, 0603 | R16A, R16B | Resistor 0603 | RES 0.9M 0603 | 2 | | 90.9kR

RES 1R 0603 | Fixed Resistor, Metal Glaze/thick Film, 0.1W, 1ohm, 75V, 1% +/-Tol, 200ppm/Cel, Surface Mount, 0603 | R5A, R5B | Resistor 0603 | RES 1R 0603 | 2 | | 1R

RES 1.24M 0603 | Fixed Resistor, Metal Glaze/thick Film, 0.1W, 1240000ohm, 75V, 1% +/-Tol, 100ppm/Cel, Surface Mount, 0603 | R17A, R17B | Resistor 0603 | RES 1.24M 0603 | 2 | | 1.24MR

RES 2M 0603 | Fixed Resistor, Metal Glaze/thick Film, 0.1W, 2000000ohm, 75V, 5% +/-Tol, 100ppm/Cel, Surface Mount, 0603 | R7A, R7B | Resistor 0603 | RES 2M 0603 | 2 | | 2MR

RES 2.1M 0603 | Fixed Resistor, Metal Glaze/thick Film, 0.1W, 2100000ohm, 75V, 1% +/-Tol, 100ppm/Cel, Surface Mount, 0603 | R13A, R13B | Resistor 0603 | RES 2.1M 0603 | 2 | | 2.1MR

RES 4.99M 0603 | Fixed Resistor, Metal Glaze/thick Film, 0.1W, 4990000ohm, 75V, 1% +/-Tol, 100ppm/Cel, Surface Mount, 0603 | R12A, R12B | Resistor 0603 | RES 4.99M 0603 | 2 | | 4.99MR

RES 5.1K 0603 | Fixed Resistor, Metal Glaze/thick Film, 0.1W, 5100ohm, 75V, 1% +/-Tol, 100ppm/Cel, Surface Mount, 0603 | R9A, R9B, R10A, R10B, R20A, R20B, R21A, R21B, R22A, R22B, R23A, R23B, R24A, R24B, R25A, R25B, R26A, R26B | Resistor 0603 | RES 5.1K 0603 | 18 | | 5.1kR

RES 5.62M 0603 | Fixed Resistor, Metal Glaze/thick Film, 0.1W, 5620000ohm, 75V, 1% +/-Tol, 100ppm/Cel, Surface Mount, 0603 | R15A, R15B | Resistor 0603 | RES 5.62M 0603 | 2 | | 5.6MR

RES 6.65M 0603 | Fixed Resistor, Metal Glaze/thick Film, 0.1W, 6650000ohm, 75V, 1% +/-Tol, 100ppm/Cel, Surface Mount, 0603 | R14A, R14B | Resistor 0603 | RES 6.65M 0603 | 2 | | 6.65MR

RES 7.32M 0603 | Fixed Resistor, Metal Glaze/thick Film, 0.1W, 7320000ohm, 75V, 1% +/-Tol, 100ppm/Cel, Surface Mount, 0603 | R11A, R11B | Resistor 0603 | RES 7.32M 0603 | 2 | | 7.32MR

RES 8M 0603 | Fixed Resistor, Metal Glaze/thick Film, 0.1W, 8060000ohm, 75V, 1% +/-Tol, 100ppm/Cel, Surface Mount, 0603 | R8A, R8B | Resistor 0603 | RES 8M 0603 | 2 | | 8.06MR

RES 10K 0603 | Fixed Resistor, Metal Glaze/thick Film, 0.1W, 10000ohm, 75V, 1% +/-Tol, 100ppm/Cel, Surface Mount, 0603 | R32A, R32B, R33A, R33B | Resistor 0603 | RES 10K 0603 | 4 | | 10kR

RES 100R 0603 | Fixed Resistor, Metal Glaze/thick Film, 0.1W, 100ohm, 75V, 1% +/-Tol, 100ppm/Cel, Surface Mount, 0603 | R6A, R6B, R18A, R18B | Resistor 0603 | RES 100R 0603 | 4 | | 100R

RES 330K 0603 | Fixed Resistor, Metal Glaze/thick Film, 0.1W, 330000ohm, 75V, 5% +/-Tol, 100ppm/Cel, Surface Mount, 0603 | R31A, R31B | Resistor 0603 | RES 330K 0603 | 2 | | 330kR

Rotery Encoder | Rotary Position Encoder, Single, 2 Channels | MT1A, MT1B | Rotery Encoder | Rotery Encoder | 2 | None

SI7021-A20-GM1R | Serial Switch/Digital Sensor, 14 Bit(s), 0.40Cel, Square, Surface Mount | Q6A, Q6B | Si7021-A20 - Temp | SI7021-A20-GM1R | 2

Solar Panel | Monocryst Solar Cell 184MW 4.15V | BT2A, BT2B | Solar panel | Solar Panel | 2

SPST | Keypad Switch, 1 Switches, SPST, Momentary-tactile, 0.05A, 50VDC, 2.55N, Solder Terminal, Surface Mount-straight | S1A, S1B | SPST | SPST | 2

TCA6408ARGTR | Parallel I/O Port, 8-Bit, 8 I/O, CMOS, PQCC16 | Q3A, Q3B, Q4A, Q4B | TCA6408ARGTR - IO Expander | TCA6408ARGTR | 4

TPS22919 | Buffer/Inverter Based Peripheral Driver, 3A, PDSO6 | Q5A, Q5B, Q8 | TPS22919DCKR - Load SW | TPS22919 | 3

SRV05-4-P-T7 | Trans Voltage Suppressor Diode, 300W, 5V V(RWM), Unidirectional, 1 Element, Silicon | D2A, D2B | TVS | D_TVS_Diode | 2 SRV05-4-P-T7 | | TVS DIODE 5.5V 6TSOP

Female USB Type C | USB-C (USB TYPE-C) Receptacle Connector 24 (6+18 Dummy) Position Surface Mount, Right Angle; Through Hole | J2A, J2B | Type C | USB-C Power Connector | 2 | None

U.FL-R-SMT(10) | CONN UMC JACK STR 50OHM SMD | J1A, J1B | U.FL_connector | U.FL connector U.FL-R-SMT(10) | 2

XTAL 38.4MHz | Crystal 38.4000MHZ 10PF SMD | X1A, X1B | XTAL 38.4MHz | XTAL 38.4MHz | 2

32.768kHz | Parallel -Fundamental Quartz Crystal, 0.032768MHz Nom | X2A, X2B | XTAL_32.768KHZ-T | XTAL 32.768kHz | 2
