parthishere/Insane-Keyboard/HardwareDesign/PCB/intlib/Project Outputs for InsaneIntegratedLib/InsaneIntegratedLib/pcb.pdf

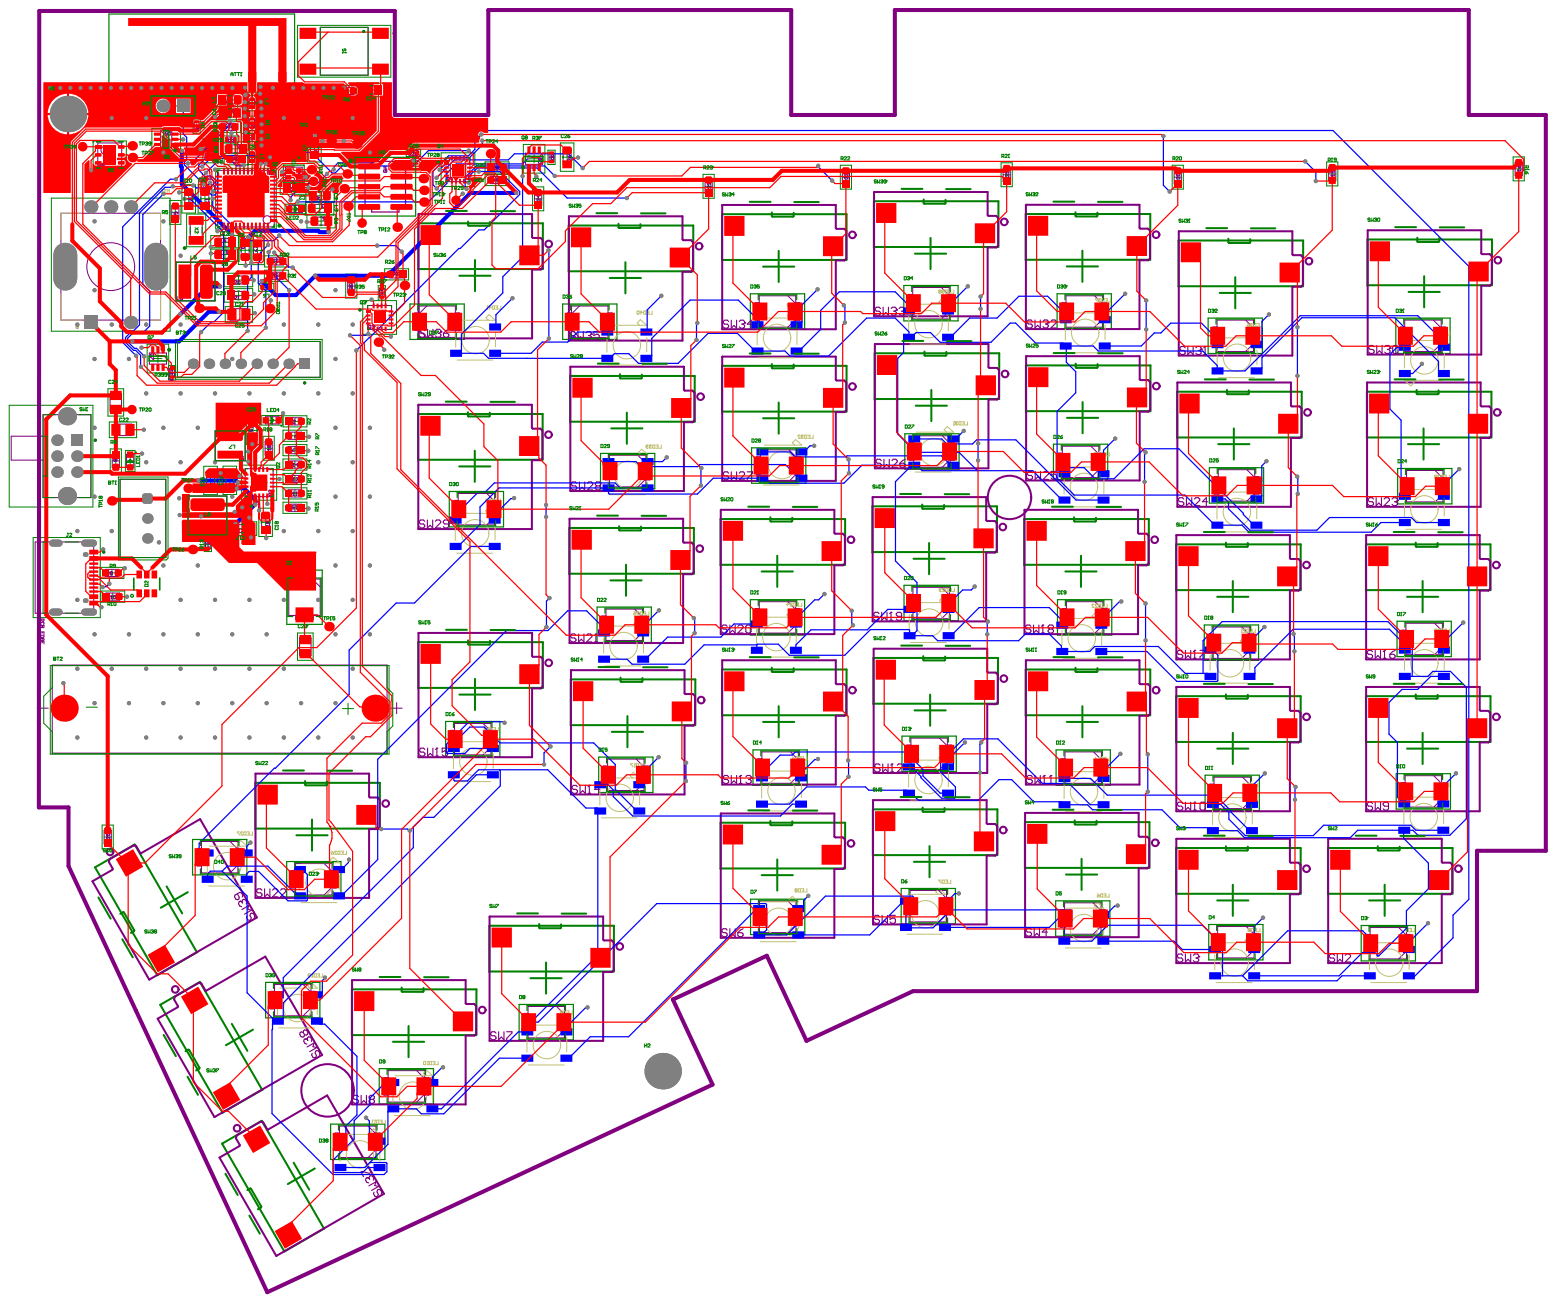
[picture p72: page 1]

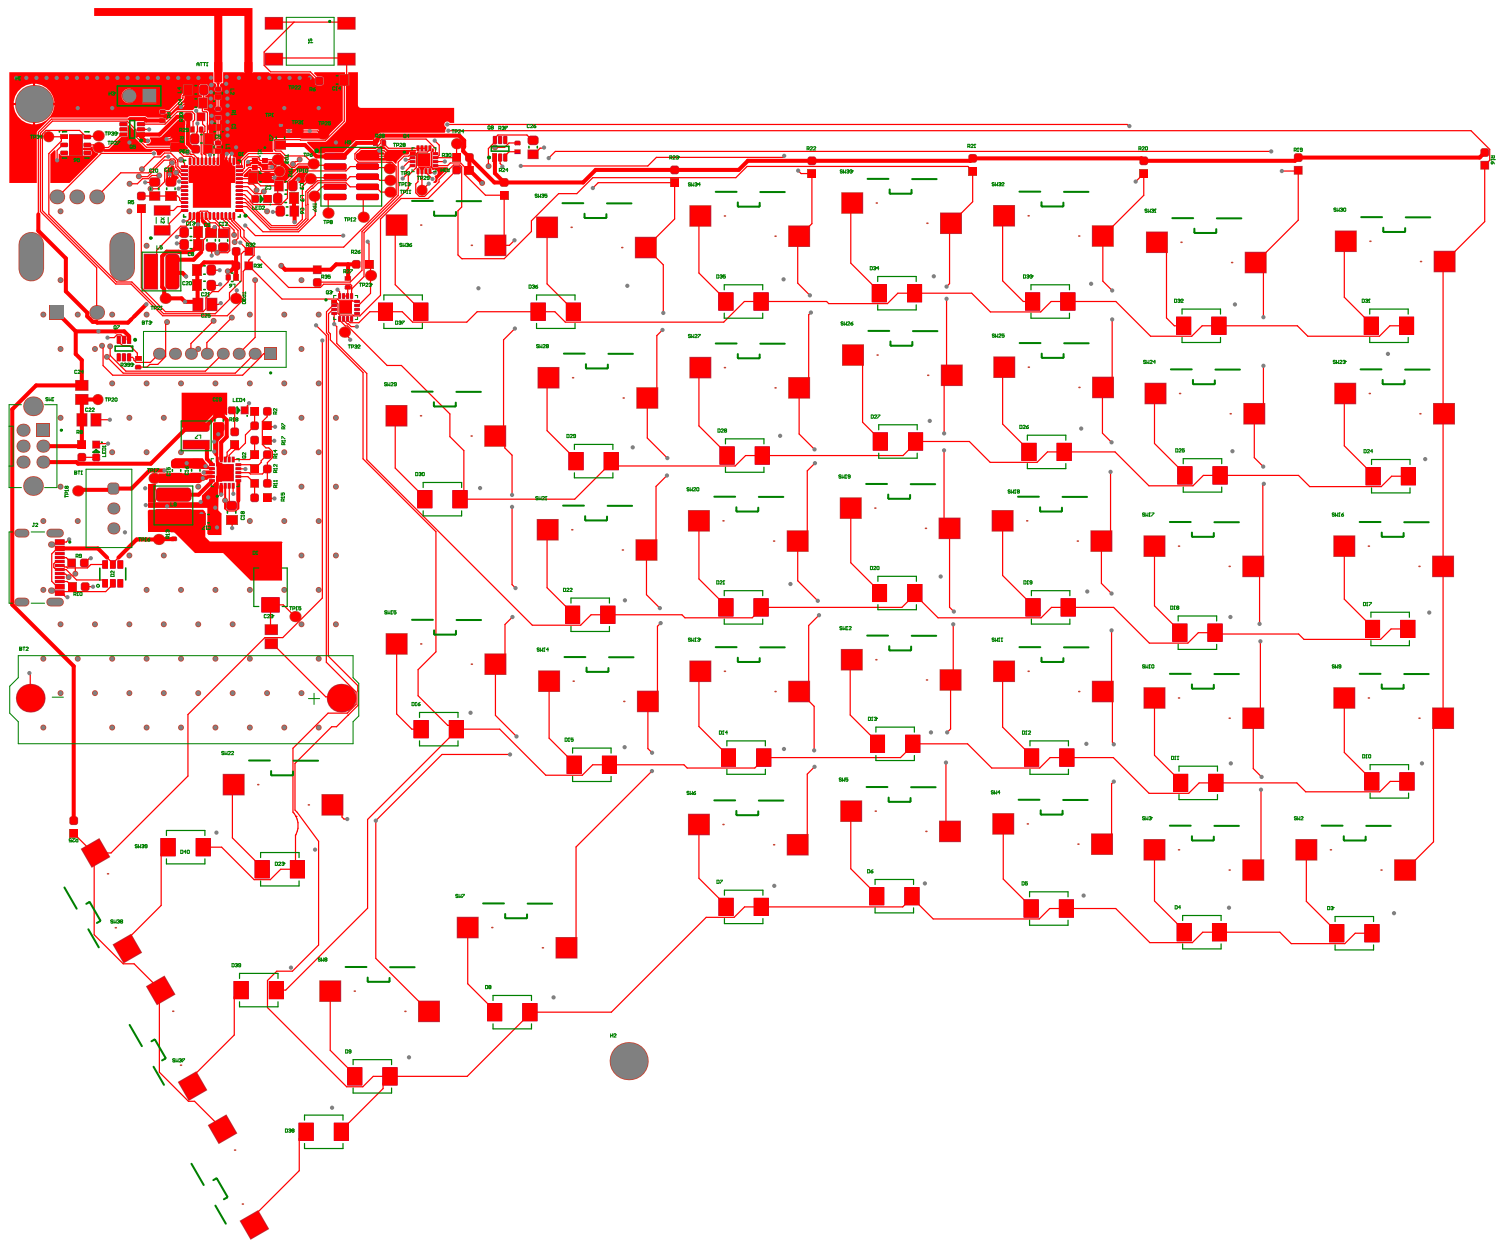
[picture p73: page 2]

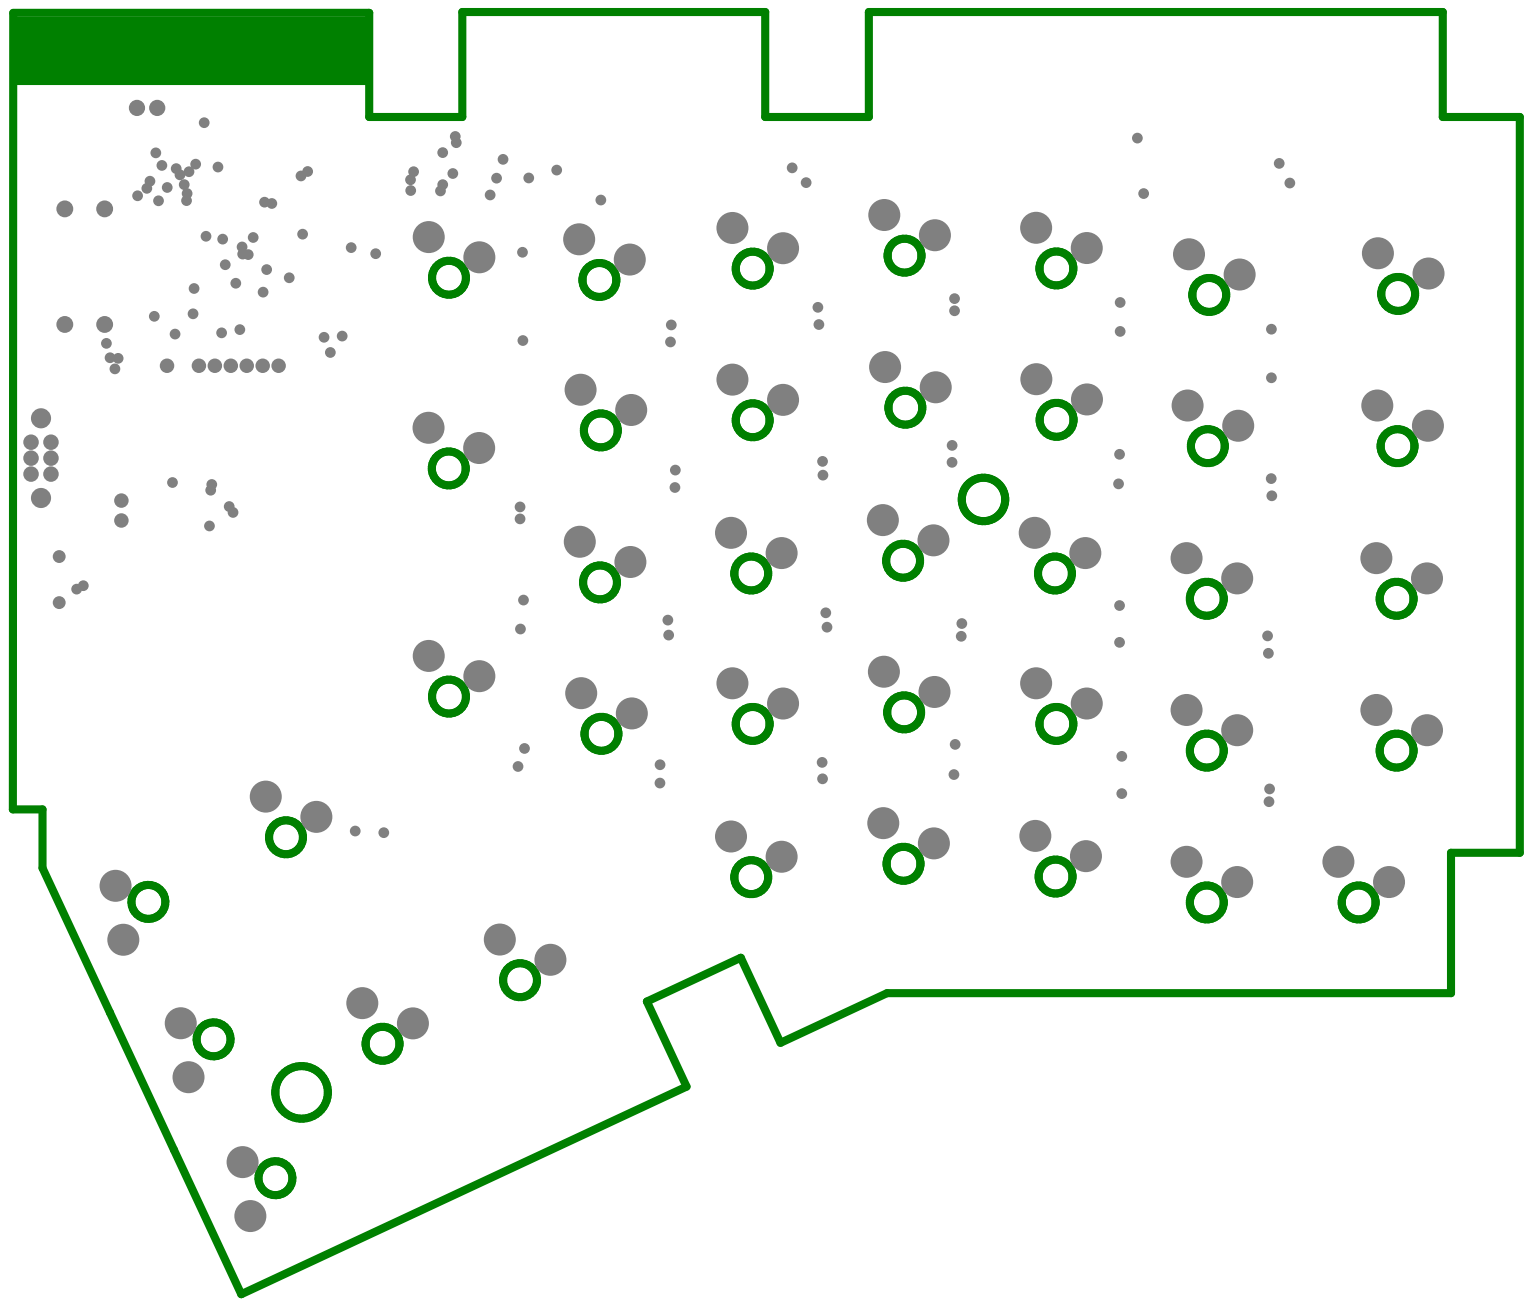
[picture p74: page 3]

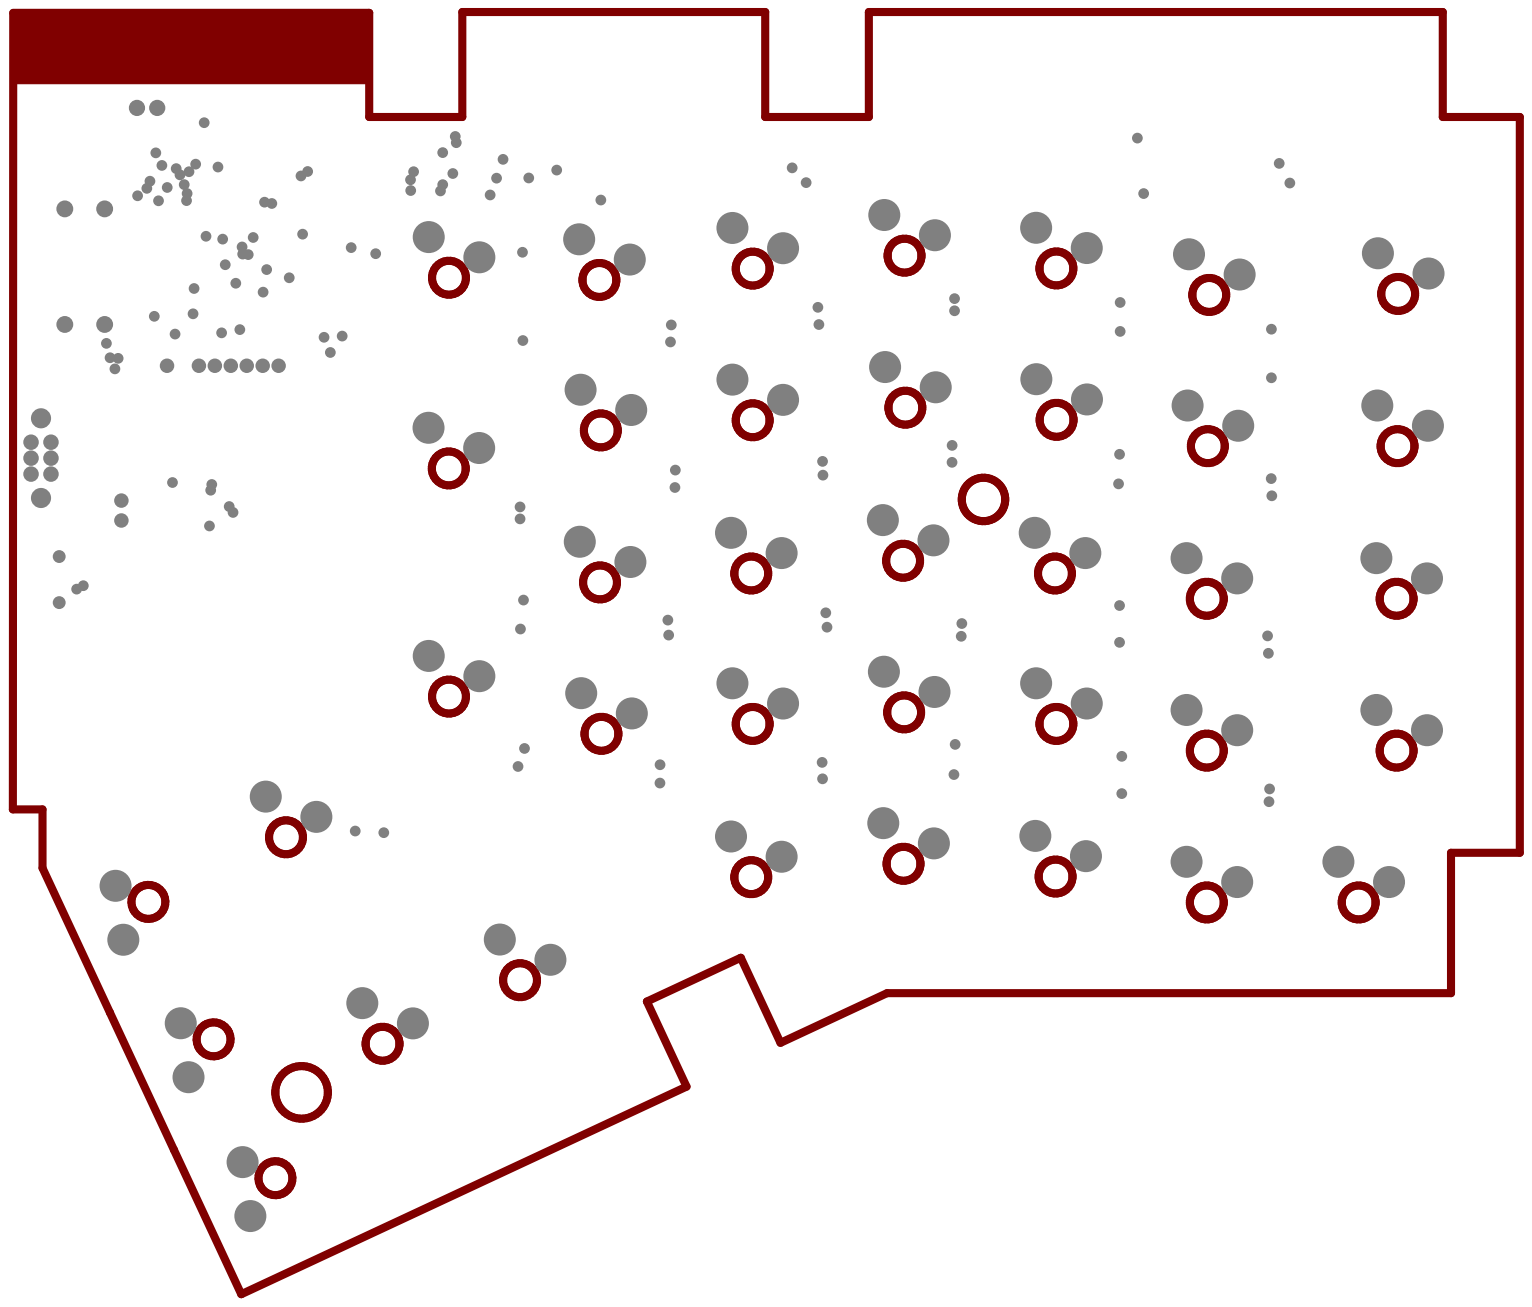
[picture p75: page 4]

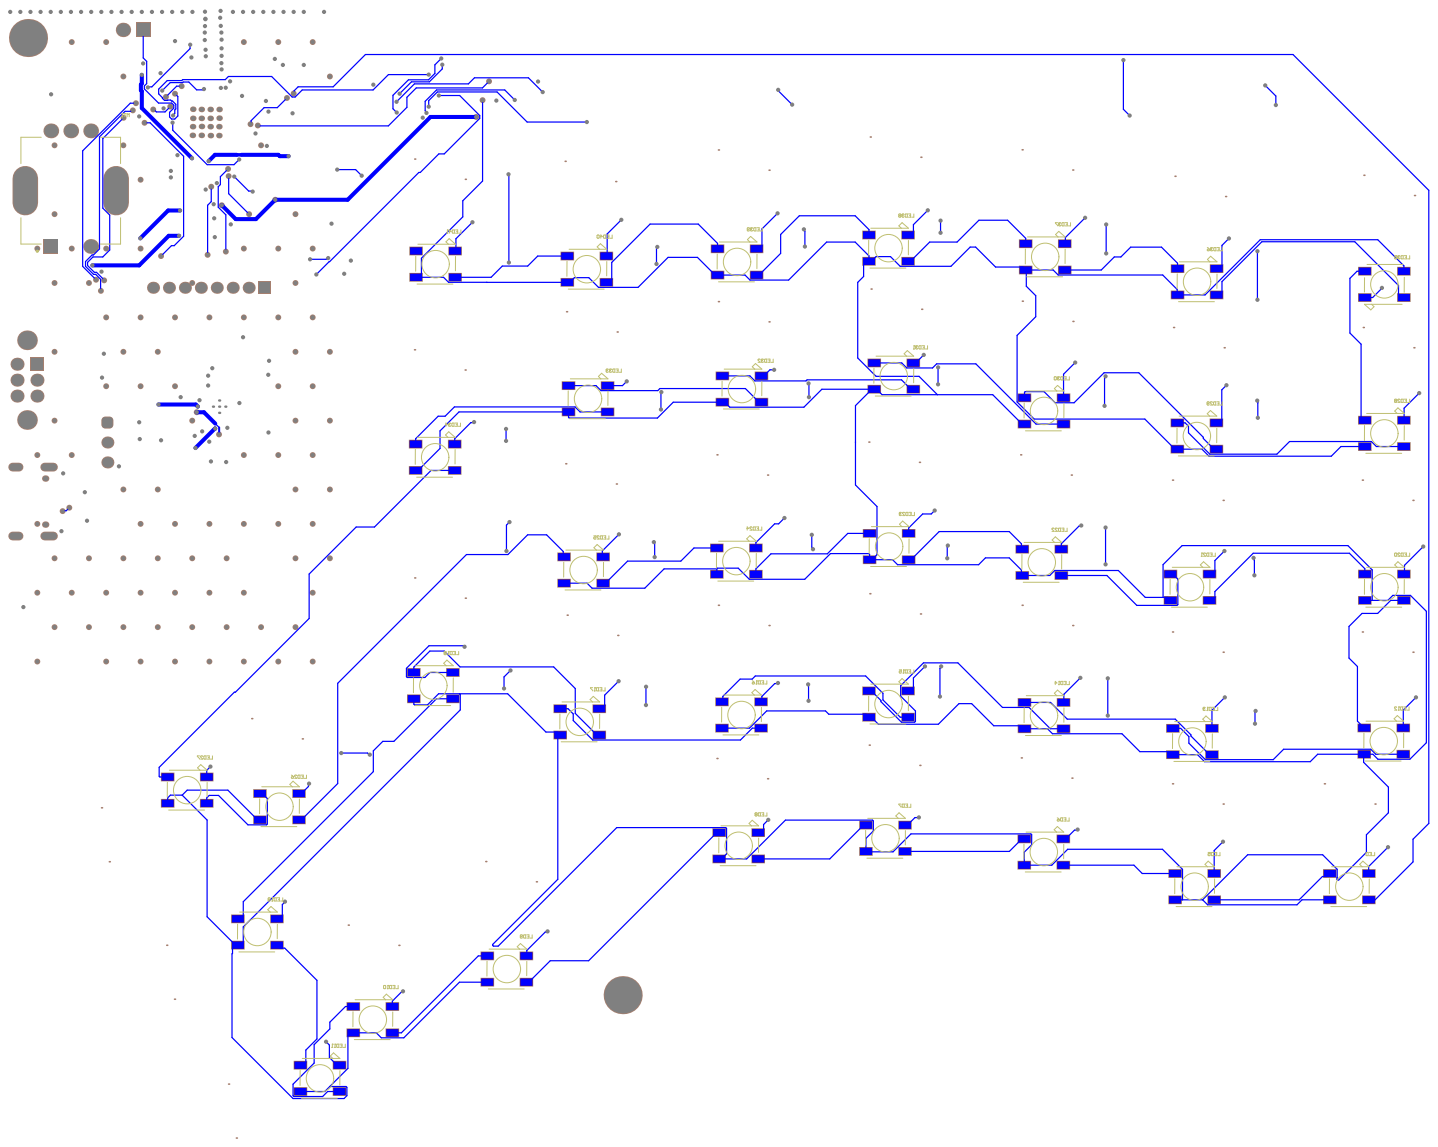
[picture p76: page 5]
