parthishere/Insane-Keyboard/(list of files, drawings)

Other design files:
HardwareDesign/PCB/InsaneKeyboard (Copy)/Display.SchDoc
HardwareDesign/PCB/InsaneKeyboard (Copy)/EFR32_IO.SchDoc
HardwareDesign/PCB/InsaneKeyboard (Copy)/InsaneKeyboard.PrjPcb
HardwareDesign/PCB/InsaneKeyboard (Copy)/Keyboard-Left.SchDoc
HardwareDesign/PCB/InsaneKeyboard (Copy)/Keyboard_parts.SchLib
HardwareDesign/PCB/InsaneKeyboard (Copy)/Keys.SchDoc
HardwareDesign/PCB/InsaneKeyboard (Copy)/Lights.SchDoc
HardwareDesign/PCB/InsaneKeyboard (Copy)/Peripherals.SchDoc
HardwareDesign/PCB/InsaneKeyboard (Copy)/Power.SchDoc
HardwareDesign/PCB/InsaneKeyboard (Copy)/RF_Antenna_Power.SchDoc
HardwareDesign/PCB/InsaneKeyboard (Copy)/Switches.SchDoc
HardwareDesign/PCB/InsaneKeyboard-R - Copy/Display.SchDoc
HardwareDesign/PCB/InsaneKeyboard-R - Copy/EFR32_IO.SchDoc
HardwareDesign/PCB/InsaneKeyboard-R - Copy/InsaneKeyboard-R - Copy.PrjPcb
HardwareDesign/PCB/InsaneKeyboard-R - Copy/Keyboard-Left.SchDoc
HardwareDesign/PCB/InsaneKeyboard-R - Copy/Lights.SchDoc
HardwareDesign/PCB/InsaneKeyboard-R - Copy/Peripherals.SchDoc
HardwareDesign/PCB/InsaneKeyboard-R - Copy/Power.SchDoc
HardwareDesign/PCB/InsaneKeyboard-R - Copy/RF_Antenna_Power.SchDoc
HardwareDesign/PCB/InsaneKeyboard-R - Copy/Switches.SchDoc
HardwareDesign/PCB/InsaneKeyboard/Display.SchDoc
HardwareDesign/PCB/InsaneKeyboard/EFR32_IO.SchDoc
HardwareDesign/PCB/InsaneKeyboard/InsaneKeyboard.PrjPcb
HardwareDesign/PCB/InsaneKeyboard/Keyboard-Left.SchDoc
HardwareDesign/PCB/InsaneKeyboard/Keyboard_parts.SchLib
HardwareDesign/PCB/InsaneKeyboard/Keys.SchDoc
HardwareDesign/PCB/InsaneKeyboard/Lights.SchDoc
HardwareDesign/PCB/InsaneKeyboard/Peripherals.SchDoc
HardwareDesign/PCB/InsaneKeyboard/Power.SchDoc
HardwareDesign/PCB/InsaneKeyboard/Project Outputs for InsaneIntegratedLib/InsaneIntegratedLib/Project Outputs for InsaneIntegratedLib/InsaneIntegratedLib/Keyboard_parts.SchLib
HardwareDesign/PCB/InsaneKeyboard/RF_Antenna_Power.SchDoc
HardwareDesign/PCB/InsaneKeyboard/Switches.SchDoc
HardwareDesign/PCB/InsaneKeyboardTwoLayer/Display.SchDoc
HardwareDesign/PCB/InsaneKeyboardTwoLayer/EFR32_IO.SchDoc
HardwareDesign/PCB/InsaneKeyboardTwoLayer/InsaneKeyboard.PrjPcb
HardwareDesign/PCB/InsaneKeyboardTwoLayer/Keyboard-Left.SchDoc
HardwareDesign/PCB/InsaneKeyboardTwoLayer/Keyboard_parts.SchLib
HardwareDesign/PCB/InsaneKeyboardTwoLayer/Keys.SchDoc
HardwareDesign/PCB/InsaneKeyboardTwoLayer/Lights.SchDoc
HardwareDesign/PCB/InsaneKeyboardTwoLayer/Peripherals.SchDoc
HardwareDesign/PCB/InsaneKeyboardTwoLayer/Power.SchDoc
HardwareDesign/PCB/InsaneKeyboardTwoLayer/RF_Antenna_Power.SchDoc
HardwareDesign/PCB/InsaneKeyboardTwoLayer/Switches.SchDoc
HardwareDesign/PCB/intlib/Project Outputs for InsaneIntegratedLib/InsaneIntegratedLib/Keyboard_parts.SchLib
HardwareDesign/PCB/Not correct/InsaneKeyboard_Right - Copy/Display.SchDoc
HardwareDesign/PCB/Not correct/InsaneKeyboard_Right - Copy/EFR32_IO.SchDoc
HardwareDesign/PCB/Not correct/InsaneKeyboard_Right - Copy/InsaneKeyboard_Right - Copy.PrjPcb
HardwareDesign/PCB/Not correct/InsaneKeyboard_Right - Copy/Keyboard-Left.SchDoc
HardwareDesign/PCB/Not correct/InsaneKeyboard_Right - Copy/Lights.SchDoc
HardwareDesign/PCB/Not correct/InsaneKeyboard_Right - Copy/Peripherals.SchDoc
HardwareDesign/PCB/Not correct/InsaneKeyboard_Right - Copy/Power.SchDoc
HardwareDesign/PCB/Not correct/InsaneKeyboard_Right - Copy/RF_Antenna_Power.SchDoc
HardwareDesign/PCB/Not correct/InsaneKeyboard_Right - Copy/Switches.SchDoc
HardwareDesign/PCB/TwoLayerBoard-Right/Display.SchDoc
HardwareDesign/PCB/TwoLayerBoard-Right/EFR32_IO.SchDoc
HardwareDesign/PCB/TwoLayerBoard-Right/Keyboard-Left.SchDoc
HardwareDesign/PCB/TwoLayerBoard-Right/Keyboard_parts.SchLib
HardwareDesign/PCB/TwoLayerBoard-Right/Lights.SchDoc
HardwareDesign/PCB/TwoLayerBoard-Right/Peripherals.SchDoc
HardwareDesign/PCB/TwoLayerBoard-Right/Power.SchDoc
HardwareDesign/PCB/TwoLayerBoard-Right/RF_Antenna_Power.SchDoc
HardwareDesign/PCB/TwoLayerBoard-Right/Switches.SchDoc
HardwareDesign/PCB/TwoLayerBoard-Right/TwoLayerBoard-Right.PrjPcb
