parthishere/Insane-Keyboard/Keyboard_Firmware-DEFAULT-PRINT/autogen/sl_spidrv_instances.h

#ifndef SL_SPIDRV_INSTANCES_H
#define SL_SPIDRV_INSTANCES_H

#ifdef __cplusplus
extern "C" {
#endif

#include "spidrv.h"
extern SPIDRV_Handle_t sl_spidrv_usart_displayy_handle;

void sl_spidrv_init_instances(void);

#ifdef __cplusplus
}
#endif

#endif // SL_SPIDRV_INSTANCES_H
