parthishere/Insane-Keyboard/Keyboard_Firmware/src/irq.c

/*******************************************************************************
 * Copyright (C) 2023 by Parth Thakkar
 *
 * Redistribution, modification or use of this software in source or binary
 * forms is permitted as long as the files maintain this copyright. Users are
 * permitted to modify this and use it to learn about the field of embedded
 * software. Parth Thakkar and the University of Colorado are not liable for
 * any misuse of this material.
 * ****************************************************************************/

/**
 * @file    irq.c
 * @brief   Interrupt Service Routines for the LETIMER0.
 *
 * This file provides the implementation of the Interrupt Service Routine (ISR) for LETIMER0.
 * It includes handling for different types of interrupts like Compare Match 1 and Underflow,
 * and actions to be performed in each case, such as LED control.
 *
 * @author  Parth Thakkar
 * @date    15th Feb 2024
 *
 */

#include "irq.h" // Include the header file for interrupt-related functions and definitions.

// Include logging specifically for this .c file
#define INCLUDE_LOG_DEBUG 1
#include "src/log.h"

// Interval for log timing
#define UF_TIME_MS LETIMER_PERIOD_MS

volatile uint32_t underflow_count = 0;

/**
 * @brief Interrupt Service Routine for LETIMER0.
 *
 * This function is called when LETIMER0 generates an interrupt. It handles two types
 * of interrupts: Compare Match 1 and Underflow. The function checks which interrupt
 * occurred and performs actions accordingly, such as turning an LED on or off.
 * The function operates within a critical section to ensure atomic operations.
 *
 *
 * @param None.
 *
 * @return void.
 */
void LETIMER0_IRQHandler(void)
{
    CORE_DECLARE_IRQ_STATE; // Declare variable to hold the interrupt state.

    CORE_ENTER_CRITICAL(); // Enter a critical section to prevent interruption during flag handling.

    volatile uint32_t flags = LETIMER_IntGetEnabled(LETIMER0); // Retrieve currently enabled interrupt flags.
    LETIMER_IntClear(LETIMER0, flags);                         // Clear the interrupt flags to prevent re-triggering.

    if ((flags & LETIMER_IEN_UF) > 0)
    { // Check if Underflow Interrupt flag is set.
        // Handle Underflow Interrupt.
        schedulerSetEventUF();
        underflow_count++;
    }
    if ((flags & LETIMER_IEN_COMP1) > 0)
    { // Check if Underflow Interrupt flag is set.
        // Handle Underflow Interrupt.

        schedularSetEventCOMP1();
    }
    CORE_EXIT_CRITICAL(); // Exit the critical section, allowing other interrupts to be processed.
} // LETIMER0_IRQHandler

static volatile bool last_A = false;
static volatile bool last_B = false;
static volatile int32_t position = 0;

/**
 * Handles GPIO interrupts for odd-numbered GPIO pins.
 * This interrupt service routine (ISR) is triggered by events on odd-numbered GPIO pins. It reads
 * the interrupt flags to determine which pin(s) caused the interrupt, clears these flags, and then
 * performs actions based on the specific pin(s) involved. In the context of a BLE server device, this
 * ISR specifically checks for events related to the SW1 pin (assumed to be odd-numbered) and triggers
 * appropriate actions (like setting an event in a scheduler) in response to these events.
 */
void GPIO_ODD_IRQHandler(void)
{
    uint32_t flags = GPIO_IntGetEnabled();
    GPIO_IntClear(flags);
    // PRINT_LOG("ODD\n");
    // if (flags & (1 << ROTARY_ENCODER_B_pin))
    if (flags & (1 << ROTARY_ENCODER_B_pin))
    {
        bool current_A, current_B;

        // Read both pins with debouncing
        do
        {
            current_A = GPIO_PinInGet(ROTARY_ENCODER_A);
            current_B = GPIO_PinInGet(ROTARY_ENCODER_B);
        } while ((current_A != GPIO_PinInGet(ROTARY_ENCODER_A)) ||
                 (current_B != GPIO_PinInGet(ROTARY_ENCODER_B)));

        
        if (last_A == last_B && current_A != current_B)
        {
            // Transition from 00->01 or 11->10
            if (current_A == last_A)
            {
                position--; // Counter-clockwise
                PRINT_LOG("CCW: %ld\n", position);
            }
        }
        else if (last_A != last_B && current_A == current_B)
        {
            // Transition from 01->11 or 10->00
            if (current_A == last_B)
            {
                position++; // Clockwise
                PRINT_LOG("CW: %ld\n", position);
            }
        }

        // Update last state
        last_A = current_A;
        last_B = current_B;

        // Signal the change
        schedulerSetEventENCODER_ROTATE();
        
        printf("counter %d\n\r", position);
    }

    if (flags & (1 << EXPANDER_INT_COL_pin))
    {
        
        // PRINT_LOG("IRQ ODD scan\n");
        schedulerSetEventIOEXPANDER_ROW();
    }

    // GPIO_PinInGet
}

/**
 * Handles GPIO interrupts for even-numbered GPIO pins.
 * Similar to its odd-numbered counterpart, this interrupt service routine (ISR) is called when an
 * event occurs on any even-numbered GPIO pin. It identifies the source(s) of the interrupts by checking
 * the enabled interrupt flags, clears these flags, and then triggers specific responses. For a BLE server
 * device, this function is concerned with actions related to the SW0 pin,
 * such as scheduling specific events in response to button presses or other triggers.
 */
void GPIO_EVEN_IRQHandler(void)
{
    uint32_t flags = GPIO_IntGetEnabled();
    GPIO_IntClear(flags);
    // during pairing and bonding confirmation for server
    if (flags & (1 << ROTERY_ENCODER_SW_pin))
    {
    }
    if (flags & (1 << ROTARY_ENCODER_A_pin))
    {
        bool current_A, current_B;

        // Read both pins with debouncing
        do
        {
            current_A = GPIO_PinInGet(ROTARY_ENCODER_A);
            current_B = GPIO_PinInGet(ROTARY_ENCODER_B);
        } while ((current_A != GPIO_PinInGet(ROTARY_ENCODER_A)) ||
                 (current_B != GPIO_PinInGet(ROTARY_ENCODER_B)));

        // Determine rotation direction based on the sequence
     
        if (last_A == last_B && current_A != current_B)
        {
            // Transition from 00->01 or 11->10
            if (current_A == last_A)
            {
                position--; // Counter-clockwise
                PRINT_LOG("CCW: %ld\n", position);
            }
        }
        else if (last_A != last_B && current_A == current_B)
        {
            // Transition from 01->11 or 10->00
            if (current_A == last_B)
            {
                position++; // Clockwise
                PRINT_LOG("CW: %ld\n", position);
            }
        }

        // Update last state
        last_A = current_A;
        last_B = current_B;

        // Signal the change
        schedulerSetEventENCODER_ROTATE();
        
    }
        // not working
        // if (flags & (1 << EXPANDER_INT_ROW_pin)){
        //     // PRINT_LOG("[INFO] IO Expander Interrupt even\n\r");
        //     // scan_io_expander();
        // }
}

/**************************************************************************/ /**
                                                                              * @brief RTCC interrupt service routine
                                                                              *****************************************************************************/
// void RTCC_IRQHandler(void)
//{
//   // Read the interrupt source
//   rtccFlag = RTCC_IntGet();
//
//   // Clear interrupt flag
//   RTCC_IntClear(rtccFlag);
//
//   GPIO_PinOutSet(BSP_GPIO_LED1_PORT, BSP_GPIO_LED1_PIN); // Toggle LED to turn it on
// }

/**
 * @brief Calculate the total elapsed time in milliseconds based on LETIMER underflows.
 *
 * This function calculates the total time elapsed in milliseconds by multiplying the number
 * of LETIMER underflows by the predefined duration of one underflow event in milliseconds (UF_TIME_MS).
 * each underflow represents a fixed and known time interval, allowing for the
 * calculation of the total elapsed time since the LETIMER started counting underflows.
 *
 * @return uint32_t The total elapsed time in milliseconds since the LETIMER started.
 */
uint32_t letimerMilliseconds(void)
{
    // Return interval for underflow count and underflow millisecond (3000ms)
    return ((underflow_count * UF_TIME_MS));
}
