parthishere/Insane-Keyboard/Keyboard_Firmware-DEFAULT-PRINT/autogen/sl_component_catalog.h

#ifndef SL_COMPONENT_CATALOG_H
#define SL_COMPONENT_CATALOG_H

// APIs present in project
#define SL_CATALOG_APP_ASSERT_PRESENT
#define SL_CATALOG_APP_LOG_PRESENT
#define SL_CATALOG_APP_TIMER_PRESENT
#define SL_CATALOG_APPLOADER_UTIL_PRESENT
#define SL_CATALOG_BLUETOOTH_CONFIGURATION_PRESENT
#define SL_CATALOG_BLUETOOTH_FEATURE_ADVERTISER_PRESENT
#define SL_CATALOG_BLUETOOTH_FEATURE_BUILTIN_BONDING_DATABASE_PRESENT
#define SL_CATALOG_BLUETOOTH_FEATURE_CONNECTION_PRESENT
#define SL_CATALOG_BLUETOOTH_FEATURE_GATT_PRESENT
#define SL_CATALOG_BLUETOOTH_FEATURE_GATT_SERVER_PRESENT
#define SL_CATALOG_BLUETOOTH_FEATURE_LEGACY_ADVERTISER_PRESENT
#define SL_CATALOG_BLUETOOTH_FEATURE_LEGACY_SCANNER_PRESENT
#define SL_CATALOG_BLUETOOTH_FEATURE_SCANNER_PRESENT
#define SL_CATALOG_BLUETOOTH_FEATURE_SM_PRESENT
#define SL_CATALOG_BLUETOOTH_FEATURE_SYSTEM_PRESENT
#define SL_CATALOG_BLUETOOTH_PRESENT
#define SL_CATALOG_GECKO_BOOTLOADER_INTERFACE_PRESENT
#define SL_CATALOG_DEVICE_INIT_PRESENT
#define SL_CATALOG_DEVICE_INIT_CLOCKS_PRESENT
#define SL_CATALOG_DEVICE_INIT_CORE_PRESENT
#define SL_CATALOG_DEVICE_INIT_DCDC_PRESENT
#define SL_CATALOG_DEVICE_INIT_EMU_PRESENT
#define SL_CATALOG_DEVICE_INIT_HFXO_PRESENT
#define SL_CATALOG_DEVICE_INIT_LFXO_PRESENT
#define SL_CATALOG_DEVICE_INIT_NVIC_PRESENT
#define SL_CATALOG_EMLIB_CORE_PRESENT
#define SL_CATALOG_EMLIB_CORE_DEBUG_CONFIG_PRESENT
#define SL_CATALOG_GATT_CONFIGURATION_PRESENT
#define SL_CATALOG_IOSTREAM_PRESENT
#define SL_CATALOG_RETARGET_STDIO_PRESENT
#define SL_CATALOG_IOSTREAM_UART_COMMON_PRESENT
#define SL_CATALOG_IOSTREAM_USART_PRESENT
#define SL_CATALOG_MX25_FLASH_SHUTDOWN_USART_PRESENT
#define SL_CATALOG_POWER_MANAGER_PRESENT
#define SL_CATALOG_RAIL_LIB_PRESENT
#define SL_CATALOG_SLEEPTIMER_PRESENT
#define SL_CATALOG_SLI_PROTOCOL_CRYPTO_PRESENT
#define SL_CATALOG_SPIDRV_USART_PRESENT

#endif // SL_COMPONENT_CATALOG_H
