parthishere/Insane-Keyboard/(commit log)

2024-11-24 LED STILL NOT W9ORKING
2024-11-24 OHK LED IS WORKING BUT im not able to see proper signal on oscope
2024-11-25 iinterrupt is not agetting triggered lets see what is wrong, removed spi flash and solderd mcu again cause some pins were not connected it seems
    [app.c, ble.c, gpio.c, i2c.c, i2c.h, irq.c, sl_mx25_flash_shutdown_usart_config.h, spi.c]
2024-11-26 getting gpio interrupt
2024-11-29 scan is causing some problem and we need to work on sending report
    [app.c, ble.c, ble_utility.c, ble_utility.h, irq.c, irq.h, ws2812.c]
2024-12-02 connection between both devices might be working now
2024-12-05 first connect other device then connect main device
2024-12-07 Display temperatute working
2024-12-07 Display temperatute working-partial refresh
2024-12-08 number of devices are working now
2024-12-10 low power day git
